joaocolombari/Gagabiro/components/res/PMFLR - PR02  - 100r - 2w - 1.JPG

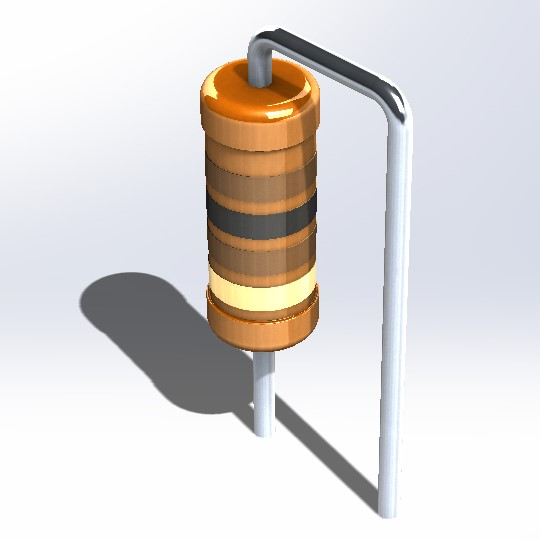
components/res/PMFLR - PR02 - 100r - 2w - 1.JPG
