joaocolombari/Gagabiro/components/El84/Renderings/untitled.250.jpg

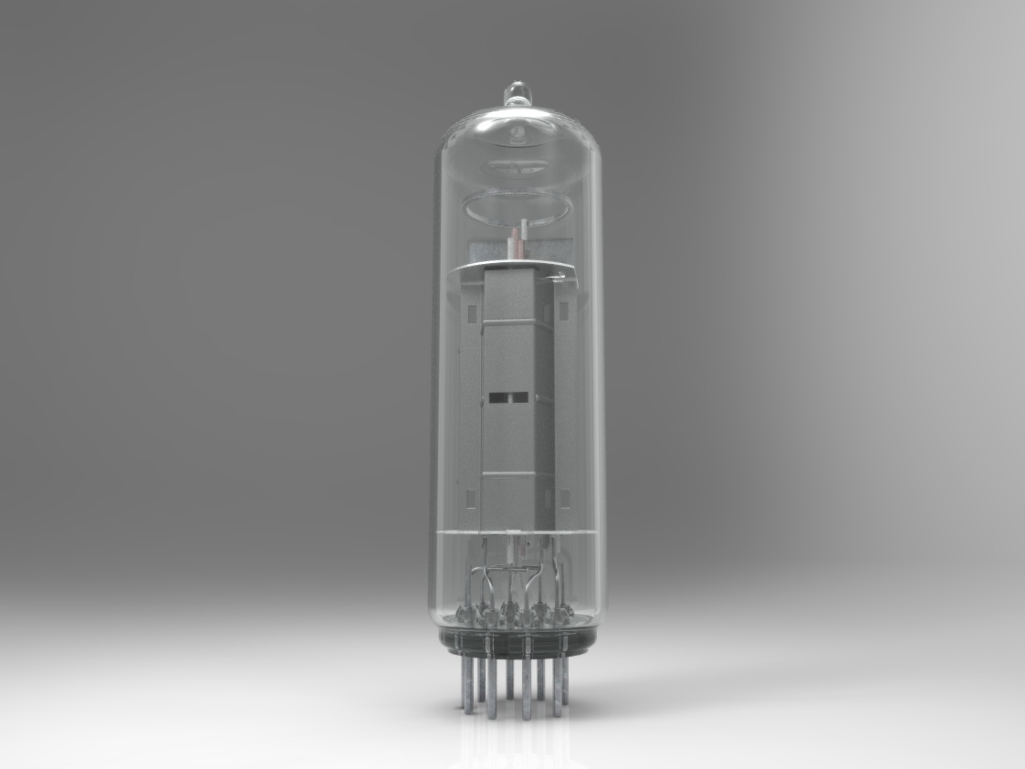
components/El84/Renderings/untitled.250.jpg
