joaocolombari/Gagabiro/schatz/How Good is an Audio Transformer - Crowhurst - 1952.pdf

# How Good is an Audio Transformer?

### N. H. CROWHURST

A thorough understanding of transformers is essential to the selection of the proper type for any particular application. The fundamentals are here presented by the author to intro-

duce the series on one of the most important components in high- quality audio equipment. THERE WAS A T1ME when audio trans-

formers were specified simply by
turns ratio. An interstage transformer would be designated, according to ratio, e.g., 3: 1 or 5: 1. But one com- ponent would give much better per- formance, although having the same turns ratio as another. The modern

transformer manufacturer knows that there is far more to designing a good transformer than just putting windings on a core so as to have the correct turns

ratio. Each design must in fact be suited for the particular job in hand. To help the prospective user, the component is generally specified by the circuit for which it is intended, e.g. "10,000 -ohm plate to single grid," together with some statement of frequency range. This is much more informative, but a still further and more detailed understanding of audio transformers will enable them to be used to best advantage in every ap- plication. Any audio transformer is essentially a matching device, but no transformer is a perfect matching device because it introduces its own losses and defects. It is the designer's job to see that these losses and defects are kept to suitable proportions. If he has done a good job, then the user can get the best perform- ance from the component by following

the manufacturer's recommendations as to circuit values. But it would not be

economic to design a different transformer to suit every possible application or circuit, so a standardized design often

has to cover a range of uses. A perfectly good transformer, connected into a circuit unsuited for it, will give poor re- sults, but correct understanding of the

problem can help rectify these deficiencies.

How Big Must it Bet
A popular fallacy has been that audio transformers always follow the principle "the bigger the better." Sometimes size is essential to quality, but for other applications the smaller component is the better one. All modern transformer core mate-

rials have a well defined saturation density. Magnetization above it will con- siderably distort the current waveform, and the distortion will reflect into the 82, Canterbury Grove, London, S.E. 27, England.

circuit. The saturation density will cor- respond to different voltage levels at dif-

ferent frequencies, so the handling ca- pacity of a transformer depends on the frequency considered. A winding that will accept 5 volts at 60 cps before distorting will accept 10 volts at 120 cps. Applying this fact to audio power transformers, a component rated to de-

liver 10 watts over a frequency range down to 60 cps will deliver considerably more power if the low- frequency cut -off

is raised to, say, 240 cps. Conversely, a smaller transformer may be used for the same power rating if a higher cut -off

is employed. In practice, the fact that only signals of low level are needed at the low -frequency end of the audio spectrum enables smaller transformers to be employed than would be possible if full output were required down to,

say, 60 cps.
Another factor that affects size is the presence or otherwise of d.c. polarizing. Where plate current passes through one winding (not in push -pull), the core be- comes polarized. To minimize this polar -, ization, a gap is left in the core by the

manufacturer, according to the intended current. Polarization reduces the allowable a.c. magnetization, but the gap in the core reduces the primary inductance unless the turns are increased. So to achieve suitable primary inductance and satisfactory a.c. magnetization limits, without excessive insertion loss, the presence of polarizing current requires more turns on a larger core size. For input transformers -line to grid, or microphone to grid -size is seldom an advantage, the best transformers

designed being of small size. For inter - stage transformers, where appreciable voltage swing is required, a slightly larger transformer may be necessary.

Fig. 1. Equivalent circuit of
C.= primary | Lp = capacitance | L. = Ca = secondary | r, = capacitance | ra = Cs = interwinding capacitance | Rv =

audio transforme .
lprimary

inductance eakage inductan e primary resistance secondary resistance core loss referred

to primary

For driver transformers, where power must be delivered to the grid circuit, considerably larger sizes are required.

Its Electrical Specification
The transformer's electrical properties have a direct bearing on its performance, but the user will not necessarily be bothered with them directly. His con- cern is with the performance of the finished article. The principal properties are shown for reference at Fig. 1, which will assist in understanding the behavior of the transformer under different con- ditions, and what part each contributes. This is one way of representing the equivalent circuit of any audio transformer. For convenience, the fact that the transformer provides a step -up or step -down is not shown in the diagram. This action of the transformer may be

regarded as perfect, its imperfections being presented in the circuit values of Fig. 1. The legend under the diagram explains what each symbol represents. There are four elements shown as shunting the transmitted signal -pri-

mary and secondary winding capacitance, primary inductance, and core loss referred to the primary. There are four elements shown as in series with signal transmission-pri - mary and secondary winding resistance. RI

R

la) | IB) Fig. 2. Equivalent circuit for low- frequency cut-

off, in a direct - coupled a.f. transformer. (A) Complete arrangement: R, = primary source

impedance; R, = secondary load impedance.
I B) Simplified equivalent of IA) : R. parallel combination of R,, R,, and Ra. leakage inductance, and interwinding capacitance.

All these circuit elements must be referred to one winding when considering their effect. If the primary is the chosen reference winding, then elements actually due to the secondary winding or its associated circuit must be "referred" in value by a factor of the turns ratio squared. Suppose the ratio is 3 : 1 step -up, then secondary winding resist- ance is divided by 9 and its capacitance

20 | AUDIO ENGINEERING | MARCH, 1952

multiplied by 9 in referring to the primary. Usually the "referred" winding resistances of both windings are of the same order, but the referred winding capacitance of the high winding is much larger than that of the low one (about 9 times for 3: 1 ratio). Hence the effect of the low- winding capacitance can often be ignored, only that of the high one being taken into account.

Insertion Loss At a middle frequency, the shunt re- actances will be high enough to exercise

negligible effect, while the series reac- tance of L. will be low enough to ignore, so the transformer is virtually a "T" re- sistor network, the attenuation of which can be calculated with reference to ex- ternal circuit values -also usually re- sistances only -at mid- frequency. This

attenuation, essentially a measure of power loss, is known as the insertion loss of the transformer.
For input and interstage transformers, where voltage transfer is the important feature, insertion loss is not generally given serious consideration. But for driver and output transformers, where insertion loss means valuable watts are lost, it must be considered. Insertion loss may be expressed in db, when the fractional power ratio corresponding to the db figure gives the proportion of input power reaching the output, or it may be expressed directly as a percentage. For example an insertion loss of 1 db represents an efficiency of approximately 80 per cent.
For a given transformer size, cor- rectly designed, the ratio of r, and r, to

Rp is fixed by the geometry of the com- ponent. Variation of turns and wire

Fig. 4 (left). Equivalent circuit for low -fre- quency cut -off in a parallel -fed a.f. transformer: = coupling capacitor. F g. 5 (right). Re- arrangement of Fig. 4 to show it as a resorant circuit.

gauge to suit, varies winding resistance and referred core -loss shunt in the same proportion. Thus a winding with too few turns results in low core -loss shunt, while too many turns produces excessive winding resistance. Conversely, from the user's viewpoint, connecting a transformer to circuits of lower impedance than design values introduces high series loss due to winding resistance, while connection to higher impedances results in serious shunt losses due to core magnetization.
In generally, a variation of impedance results in a deficiency in frequency re- sponse as well, and the choice of the

number of turns in design must be a compromise to achieve good response to

both low and high ends of the spectrum. At low frequencies, the effect of La, C., C., and C. is negligible, but that of

AUDIO ENGINEERING | MARCH,
Fig. 3. Low- frequency cut -off | attenuation

characteristic, 6 db per octave.

01 | 0.2 030.4 0608 | 2 | 3 | 4567810 RELATIVE FREOUE/KY - /,c

inductance Ln will become appreciable. For the purpose of comparative re- sponse, the values of winding resist- ances r, and r. can generally be ignored as small compared to the circuit resist- ances R. and R. to which the trans-

former is connected. Thus the circuit can be redrawn as at Fig. 2 from the viewpoint of relative l.f. response. At
(A) the relevant values are shown, R, being the source impedance -i.e., the plate resistance of the tube if the transformer is connected in a plate circuit ;

Fig. 6 (left). Equivalent circuit for high -frequency cut -off in a step -up transformer, and Fig. 7 (right), in a step -down transformer.

R. is the secondary load resistance, if any, referred by turns ratio squared to the primary side. For example, a shunt resistor of 1 megohm on the secondary of a 5: 1 step -up will give a referred R. of 1 megohm divided by 5' or 25, which is 40.000 ohms.
The shunting effect of Lp must be considered relative to the parallel re- sultant of R., R. and Rp. Thus (B) in Fig. 2 shows a simplified theoretical form of the circuit, where R is the re- sistance of R,, R. and Rp in parallel. This circuit produces a simple 6 db/ octave l.f. cut -off, of the type shown at Fig. 3, in which the 3 -db point is the frequency where the reactance of Lp is equal to R. Thus the cut-off frequency can be modified by changing either Lo or R. As Lp and Rp are fixed by the

transformer, the remaining possibilities for adjusting l.f. cut -off are R, and R.. Reduction of the effective parallel re- sistance of these two will lower the I.f.

cut -off, extending the frequency range. With a direct -coupled transformer, where the core is polarized, the core is gapped so that the highest possible inductance is achieved when the current for which it is designed passes through the winding. It is wasteful to work the

1952

transformer at a current differing appreciably from this value.
A direct -coupled transformer operating in a push -pull plate circuit does not have its core polarized, so a smaller component can be used, and the circuit of Fig. 2 can be applied, taking care that all impedances are referred to either the whole, or half, of the primary winding, correctly. However, the inductance varies widely with both frequency and level, so the response shown at Fig. 3. will not be applicable, but the same prin-

ciple for adjusting 11 cut -off applies. Distortion is closely associated with l.f. response because it appears most strongly at this end. Steps that improve I.f. response also reduce distortion due to harmonics in the magnetizing current. Sometimes transformers are parallel fed, to avoid passing the plate current through the primary winding. Since a coupling capacitor is then necessary, its. reactance also becomes effective at low frequencies, so the circuit for l.f. re- sponse takes the form shown at Fig. 4.

Here R. is the effective resistance given, by the plate resistance of the tube and its coupling resistor in parallel ; R., as before, is the secondary load resistance,. if any, referred to the primary. This . circuit is in the form of a resonant cir-

cuit, seen more clearly as redrawn at Fig. 5, where R. is in series with the resonant components Cc and L,, and the resistances Rp and R. are in shunt. For this reason, larger values of R. or smaller values of R. increase the damping (or reduce the Q) of the resonant circuit.
Less -than -critical damping results im a l.f. peak in the vicinity of cut -off. Critical, or more -than -critical, damping, eliminates any tendency to peak. Choice' of suitable values for R,, R., and Cc can result in best possible operation of the transformer in a circuit. as will heshown in detail in following articles.

Response at High Frequencies
At high frequencies the effect of Lp,. and Cc if used, will be negligible, and where any appreciable transformation ratio is employed, one of the winding capacitances may usually be neglected. Thus Fig. 6 shows the h.f. circuit equivalent for a step -up transformer. while [Continued on page 5.51' 2T

TABLE II

Preferred change in level db From speech to speech

From music to speech
From speech to loud - starting music
From speech to quiet - starting music
From speech to interval
signal ( Bow Bells)

## - -4to-í

+2
+2to+3
-19

Voltage Regulator Tubes
An article un the use of neon voltage regulator tubes by C. Tuppin appears in the September 1950 Toute la Radio. Techniques for the stabilization of both d.c. and a.c. voltages are discussed, and trigger

tubes are mentioned briefly. Of importance is the table of regulator tubes available in France. Some of these tubes are capable of stabilizing voltages as high as 340 volts while others have current ranges up to 200 ma. Most of these tubes are not mar- keted in this country, although they would

appear to be quite useful in many applications where designers are now forced to use series or parallel connection of avail-

able tubes.

### HOW GOOD IS AN

## AUDIO TRANSFORMER?

from page 211
Fig. 7 shows that for a step -down type. As in the previous section. it is assumed that winding resistances are negligible 'in comparison with the circuit impedances.
A complicating factor is the interwinding capacitance Cs. so it is usual to take steps to eliminate its effect. Some transformers incorporate shields between windings, connected to ground, so that interwinding capacitance is replaced by winding -to- shield, i.e. to ground, capaci-

tance. effectively increasing existing winding capacitance slightly. Where shields are not employed, it is

RUGGED
CONS'i RUC (ION
EXCEPTIONAL
CALIBRATION
STABILITY
UNAFFECTED BY VARIATIONS
IN HUMIDITY

# MIDGET

# CONDENSER

# MICROPHONE

## for Precision Sound

## Measurements and High Quality Sound 'Recording

Built to give years of service without change in calibration. Even without dessicators, Kellogg Midget Condenser Microphones show no detectable drift in laboratory service. Proven in use for
optimum performance for more than 15 years. MODEL A | MODEL 8 RESPONSE JReferred to
1 volt, dyne, cmr) | -59 db | -55 db
FLAT TO WITHIN ± 3db from 20 to 11,000 cps, for closed cavity without grille. | ± A db from 20 to 15,000 cps with or without grille for perpen- dicular incidence in free field. Users 1r:dude government laboratories.

universities. audio development labora-

tories. sound studios and industrial plants manufacturing sound equipment. | SEND FOR FULL SPECIFICATIOtic TODAY! WRITE DEPT 27 -C ELLDSWITCHBOARD AND | COMPANY
-, a "7 | MIDGET CONDENSER MICROPHONE 6650 South Cicero Avenu e, Chicago 38, I Ilinois

Fig. 8 !left). Elimination of C. from Fig. 6, and Fig. 9(right) from Fig. 7. generally possible to connect the trans-

former so as to practically eliminate the effect of interwinding capacitance. Inter - winding capacitance is the capacitance

between the layers of turns that are nearest together in the two windings. These layers will be turns electrically close to one end of their respective windings. By connecting the windings into the external circuit so that the signal potential to ground from one of these ends is zero, the interwinding capacitance will become virtually the capacitance from the other winding to ground. If the ends nearest together in both

HIGH -FIDELITY k a quarterly magazine, devoted to the

interests of people who enjoy the best in home musical entertainment. It is a large- size magazine, beautifully

illustrated, and handsomely
printed on Fne paper. Published by MILTON B. SLEEPER

# Before you spend money

# for RECORDS, consult

# Uig h ; Jidcliiq

## the Big Magazine of Information about

Records and Hi -Fi Equipment for Your Home

BEFORE YOU BUY NEW RECORDS: Make it a habit to check the reviews in HIGH -FIDELITY by such outstanding critics os John Conly, Alfred Frankenstein, C. G. Burke, and John Indcox. If a new release is worth buying, you'll fund it listed. Also, you'll find

it compared with other recordings of the some composition. Thus HIGH -FIDELITY con help you to avoid mistakes, and to choose the best recording of any composition you want. Playing time and price of each record is shown. SPECIAL FEATURE: The Spring Issue contains C. G. Burke's monumental research work which reviews every LP ever made of Beethoven's music. In book form, it would occupy 120 pages.

BEFORE YOU BUY HI-FI EQUIPMENT: Make it a habit to consult the elaborately -illustrated articles in HIGH -FIDELITY on record players, styli, tape recorders, FM and TV tuners, amplifiers,

speakers, and modern decorative ideas for home installations, all described in non -technical language.
Mail Coupon Today! Big Spring issue now ready for mailing. e Mr. Charles Fowler, Editor, High Fidelity Magazine

I 26 Audio Building, Great Barrington, Mass. Please enter my subscription to High Fidelity Magazine:

36.00 for three years (SAVE $61 053.00 for one year (SAVE 511 Name Address Add 50{ per year for Canada, $1.00 foreign countries AUDIO ENGINEERING | MARCH, 1952 | 55

windings have zero signal potential to ground, the effect of interwinding ca- pacitance is completely eliminated, not even adding to effective winding ca- pacitance, because there is no signal

potential across it. (Any d.c. potential between windings will not produce ca- pacitance currents.) When the effect of interwinding ca- pacitance has been eliminated, the circuits of Figs. 6 and 7 become those shown at Figs. 8 and 9 respectively. Now, as in the 1.f. case, each circuit be- comes a simple resonant circuit, in which the impedance connected to the low side of the transformer is series damping, while that connected to the high side is shunt damping. Figure 10 shows the h.f. response due to (a) less - than- critical damping, (b) critical damp-

ing, (c) more -than -critical damping. Common cases where inadequate damping gives rise to a h.f. peak are interstage transformers operated in the

plate circuit of triodes, and output transformers for tetrode or pentode tubes. Careful attention to the circuit can eliminate an undesirable peak or loss and produce the best possible response.

# FIFTH PRINTING

## Just off the press

# AND STILL GOING STRONG!

# audio

# anthology

Paper cover . | $2.00

Distributors write for quantity discount

The long awaited compilation of reprints from early issues of AUDIO ENGINEERING, most of which are unobtainable.

Contains 37 articles on the following subjects:
Amplifiers | Phonograph Equipment
Speakers | Tone and Loudness Controls
Noise Suppressors | Dividing Networks
These articles have been of great interest to readers of AUDIO ENGINEER-ING over the past three years. Assembled in one volume, they comprise the most authoritative reference work for the audio hobbyist.
I- | -CUT OUT -MAIL TODAY-
Book Division, Dept. A9
Radio Magazines, Inc.
342 Madison Ave., New York 17, N. Y. Sins: Enclosed is my | check | money order for | copies of the
Audio Anthology. Name (print carefully) Address City | Zone | State | J

The internal properties of an audio transformer that set a limit to its frequency range at the upper end are its leakage inductance and the winding ca- pacitance of the high side (including

additional capacitance connected across the winding externally, such as grid input and strays). The ultimate cut -off frequency is inversely proportional to the square root of the product of this inductance and capacitance. Both these quantities increase with the size of the transformer so it is clear that smaller transformers have an inherently higher frequency range.

o g

10

03 | 05 | 2

i10

20 03 0.5

z o i 10

20 | 05 | 2 | 3

Fig. 10. Attenuation responses for high -fre- quency cut -off; (A) less- than -critical damp-

ing; (B) critical damping; and (C) more -thancritical damping.
Successful operation of any transformer depends appreciably upon the circuit in which it is worked, and the manufacturer's specification does not wholly determine how good any particular transformer is for the job in hand. Simple methods of measuring up the qualities of a transformer and of determining circuit modifications for opti- mum performance will be discussed in

subsequent articles.

56 | AUDIO ENGINEERING | MARCH, 1952
