joaocolombari/Gagabiro/Gagabiro/Project Outputs for Gagabiro/png_layers/1.png

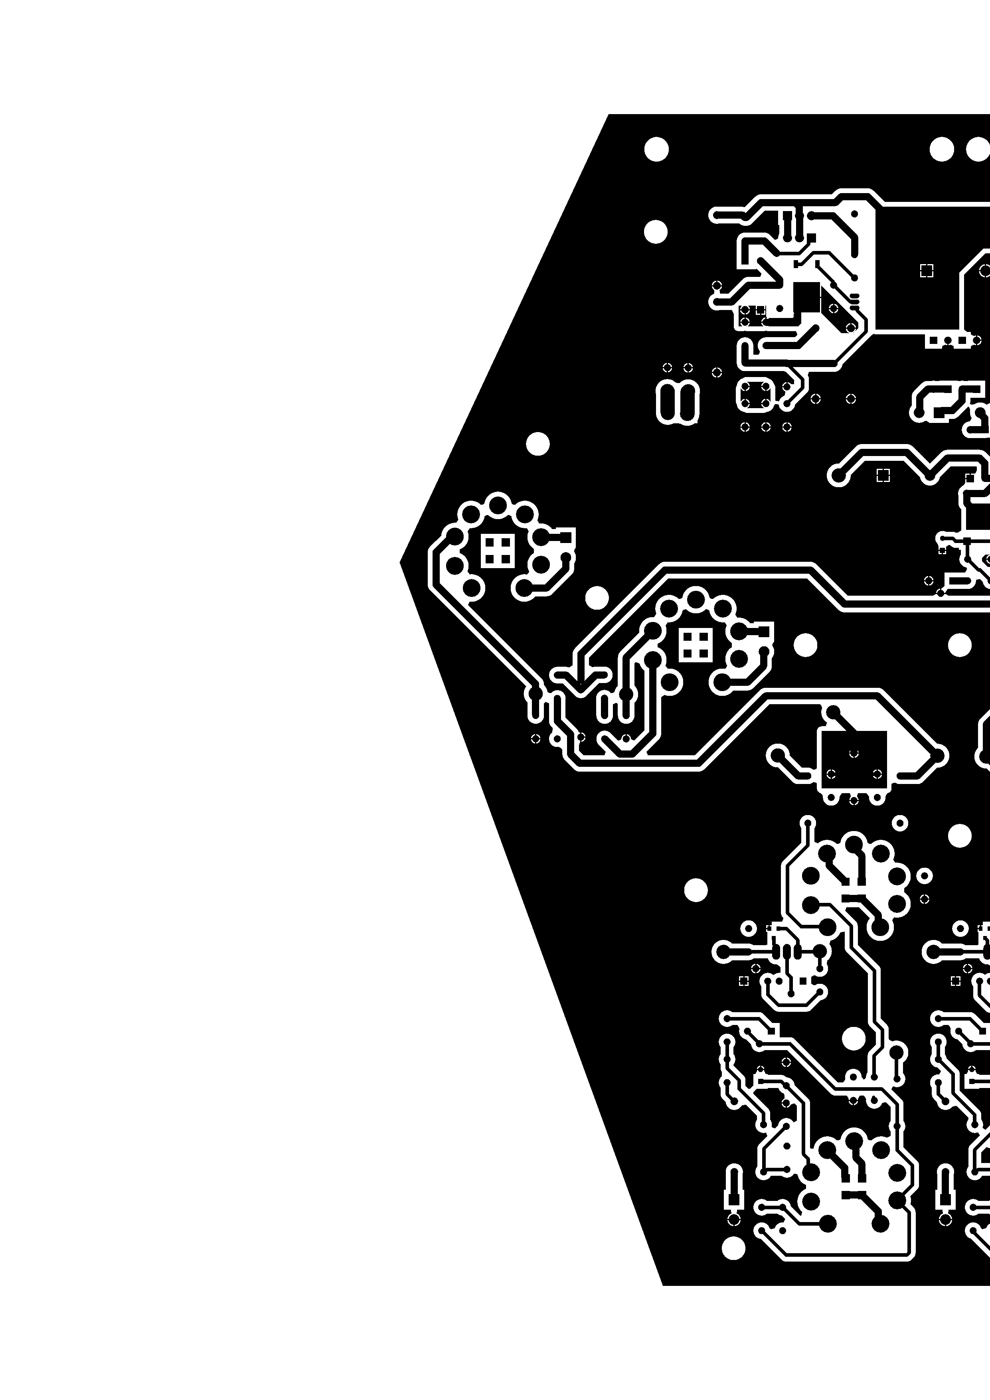
Gagabiro/Project Outputs for Gagabiro/png_layers/1.png
