joaocolombari/Gagabiro/Gagabiro/Project Outputs for Gagabiro/png_layers/2.png

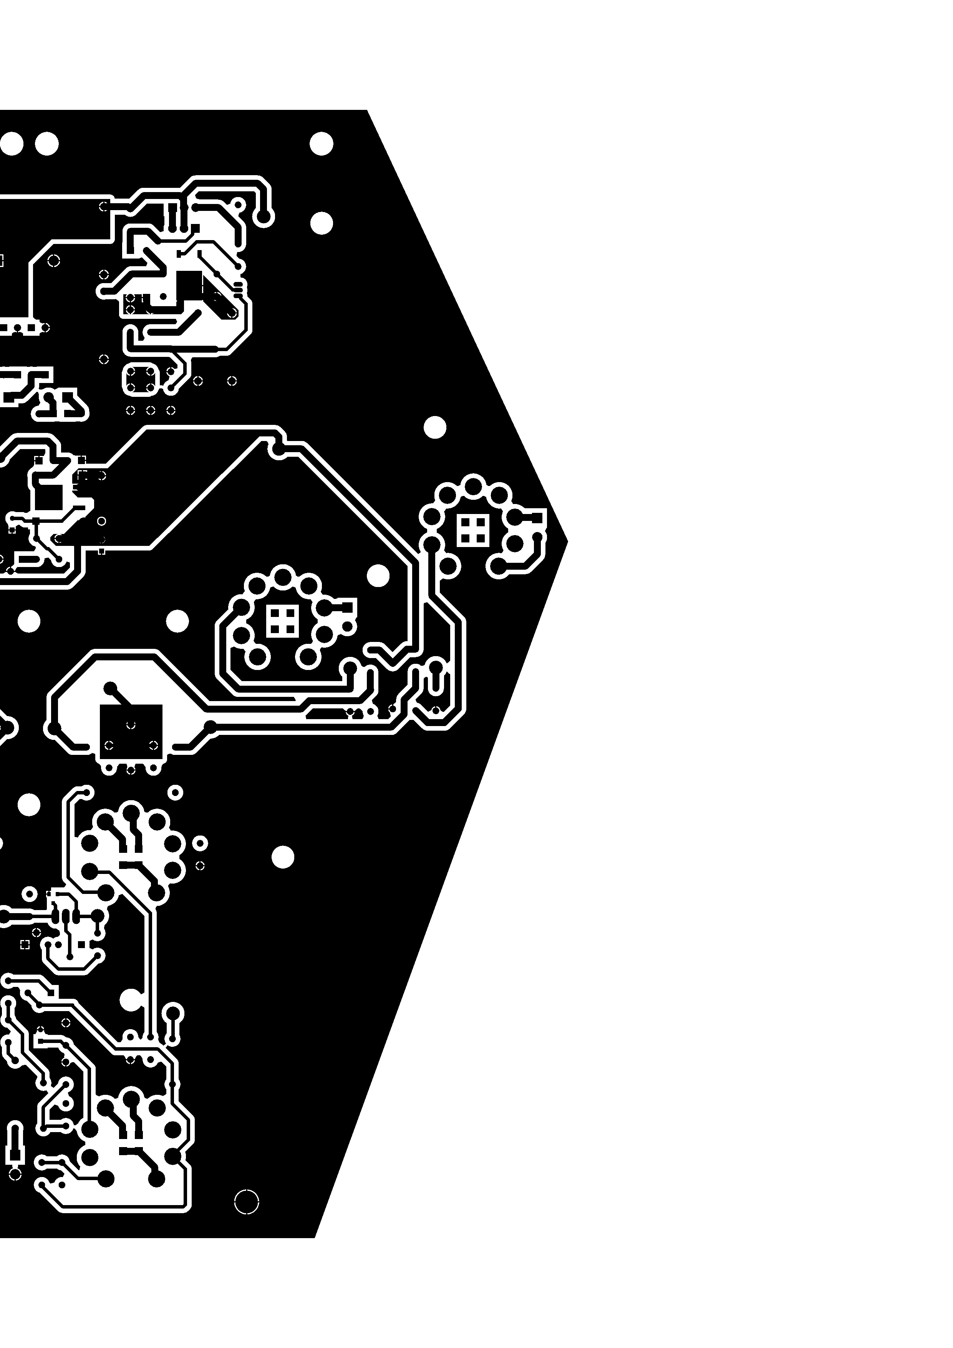
Gagabiro/Project Outputs for Gagabiro/png_layers/2.png
