joaocolombari/Gagabiro/Gagabiro/Project Outputs for Gagabiro/png_layers/3.png

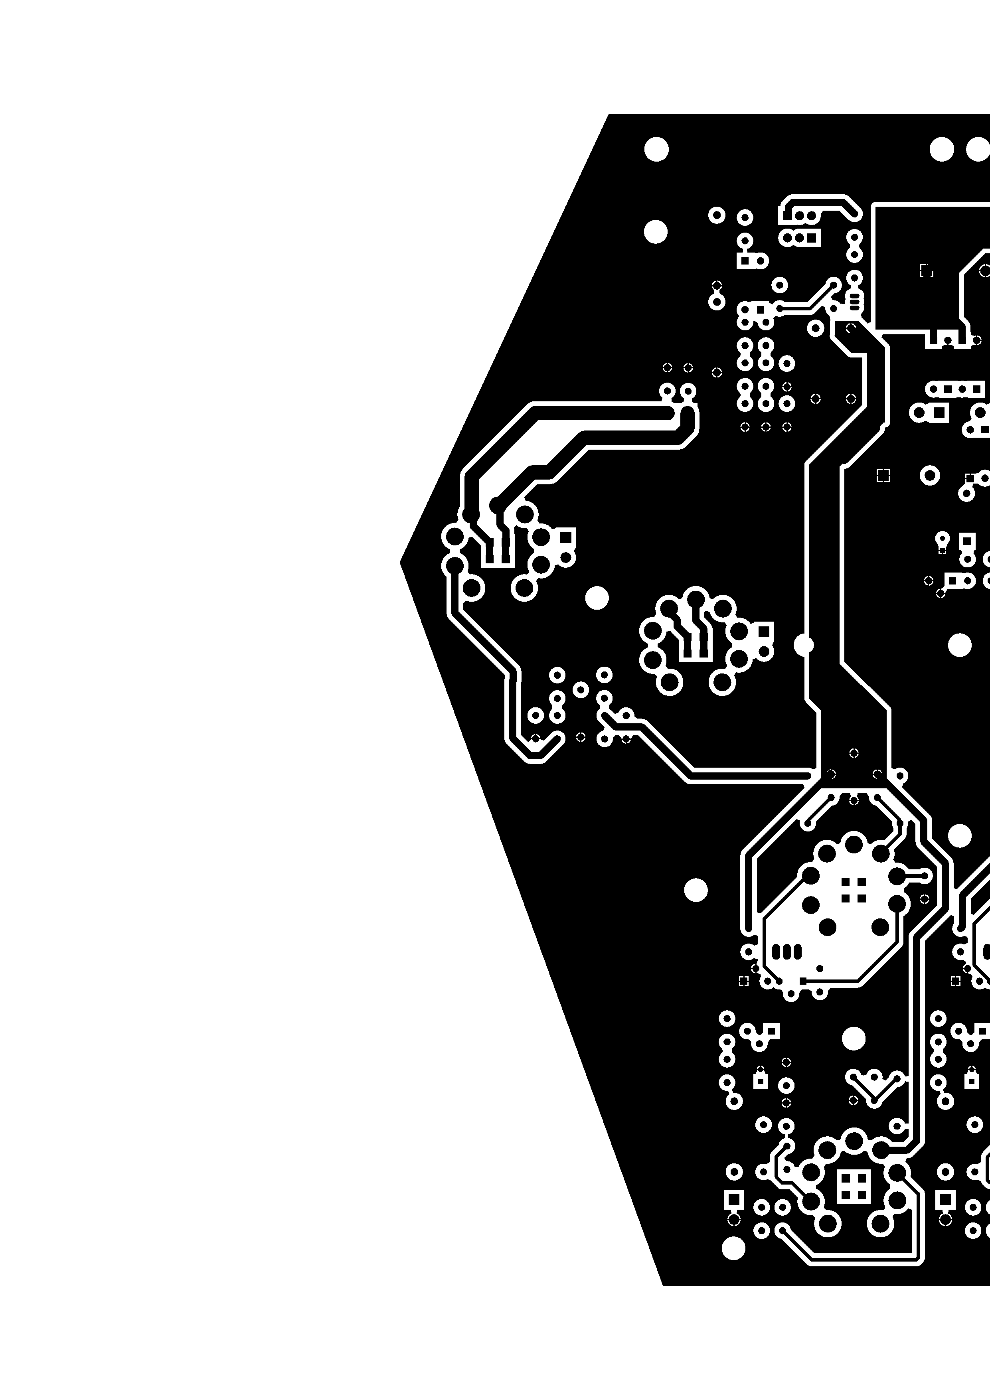
Gagabiro/Project Outputs for Gagabiro/png_layers/3.png
