joaocolombari/Gagabiro/templates/USP-removebg-preview.png

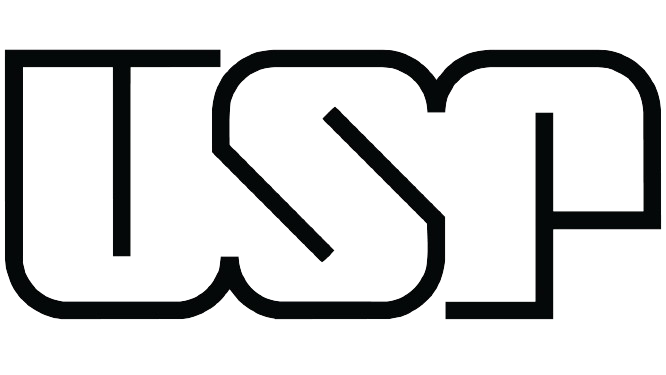
templates/USP-removebg-preview.png
