joaocolombari/Gagabiro/components/12ax7/2/base sem blindagem.fw.png

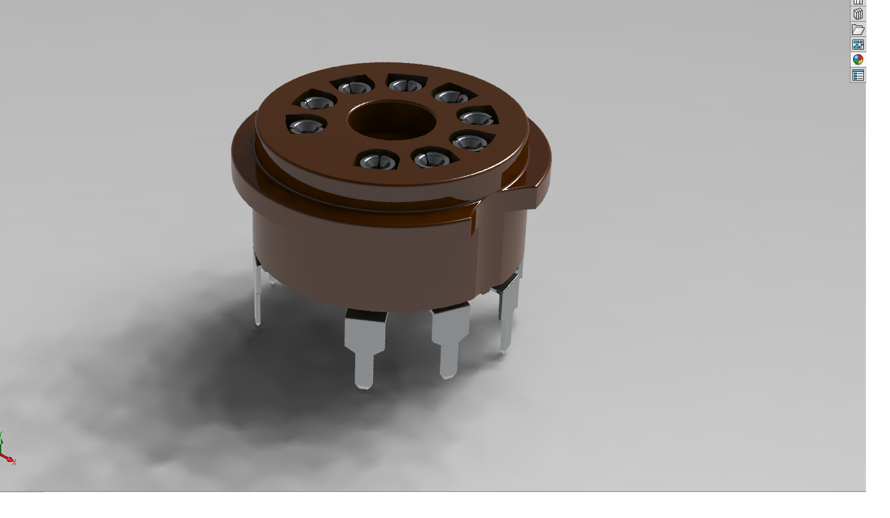
components/12ax7/2/base sem blindagem.fw.png
