joaocolombari/Gagabiro/components/12ax7/2/render base.fw.png

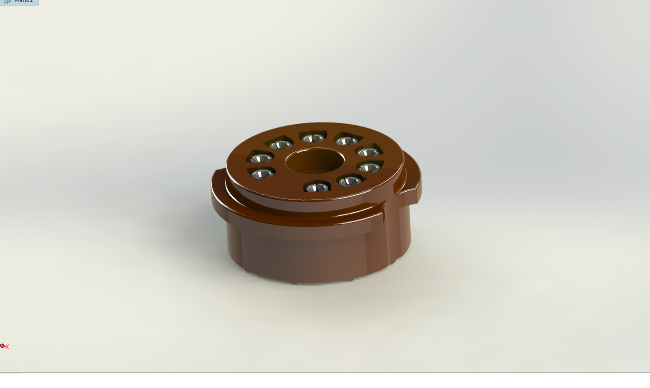
components/12ax7/2/render base.fw.png
