joaocolombari/Gagabiro/components/12ax7/2/render end.fw.png

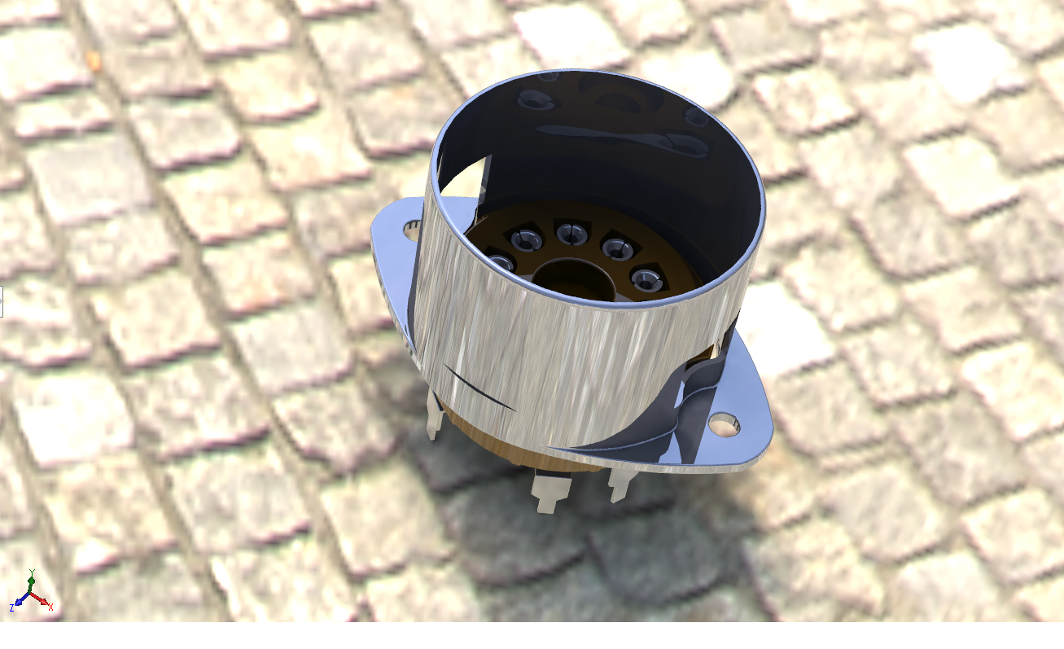
components/12ax7/2/render end.fw.png
