joaocolombari/Gagabiro/components/12ax7/Tube Socket - PCB v2.png

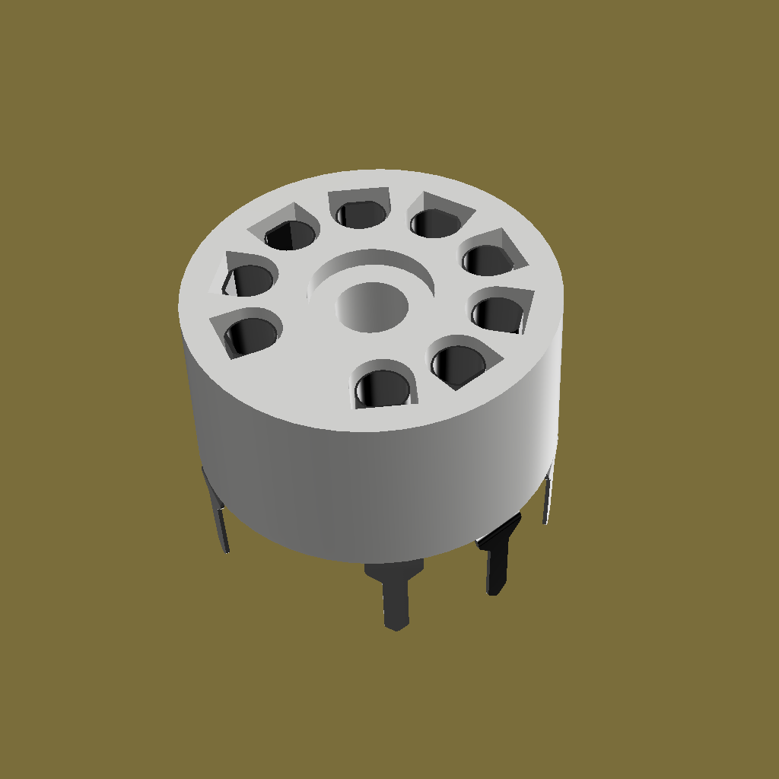
components/12ax7/Tube Socket - PCB v2.png
