joaocolombari/Gagabiro/components/El84/Renderings/el84.jpg

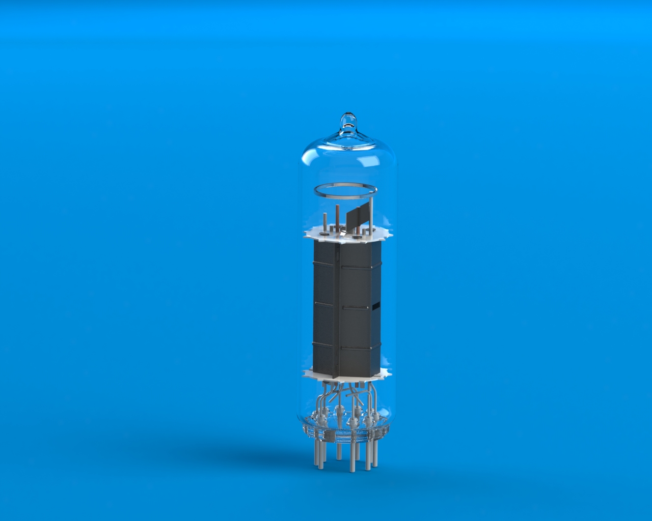
components/El84/Renderings/el84.jpg
