joaocolombari/Gagabiro/components/octal/octal.jpg

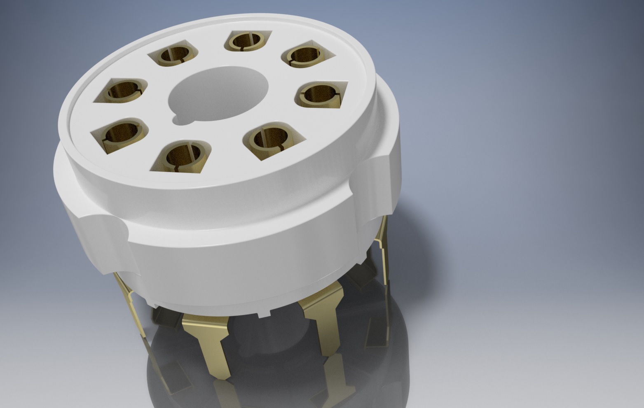
components/octal/octal.jpg
