joaocolombari/Gagabiro/components/octal/octal/Octal Base tube socket.png

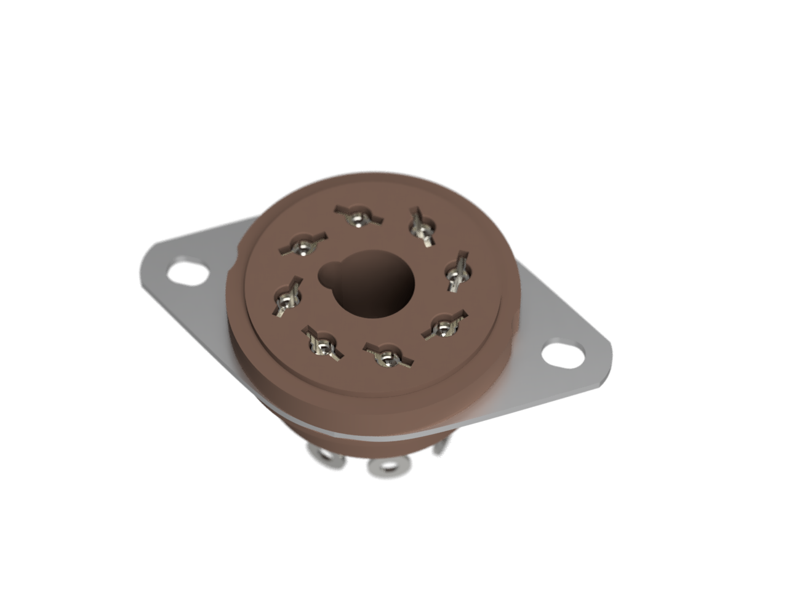
components/octal/octal/Octal Base tube socket.png
