joaocolombari/Gagabiro/components/octal/octal/Octal Tube Socket/Bottom.png

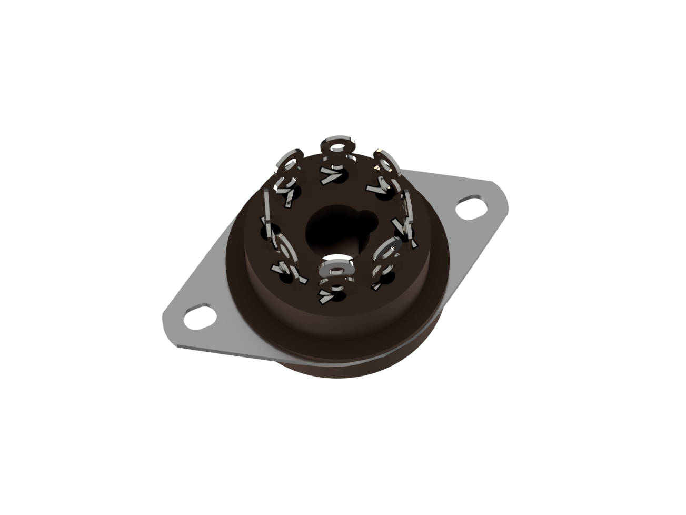
components/octal/octal/Octal Tube Socket/Bottom.png
