joaocolombari/Gagabiro/components/octal/octal/Octal Tube Socket/Front.png

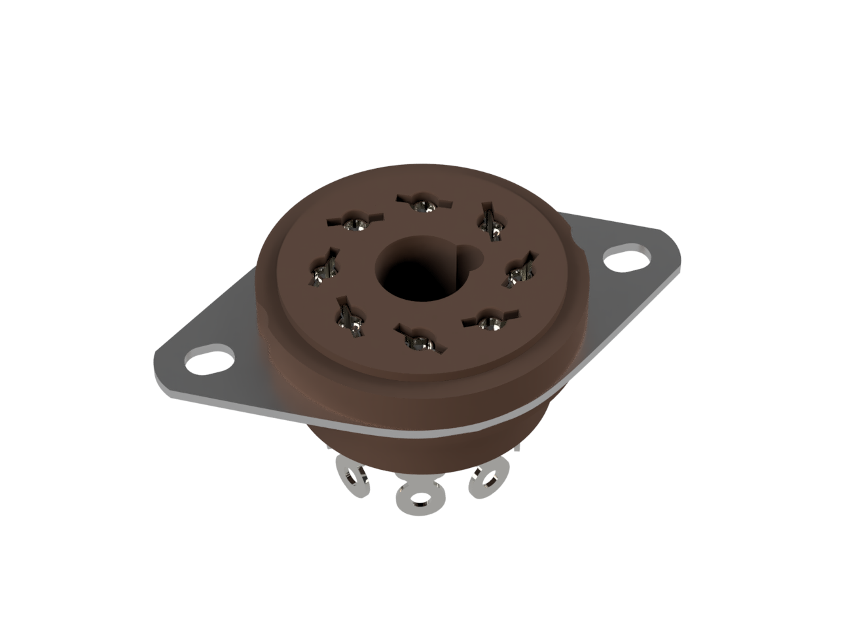
components/octal/octal/Octal Tube Socket/Front.png
