joaocolombari/Gagabiro/components/octal/octal/Octal Tube Socket/pin.png

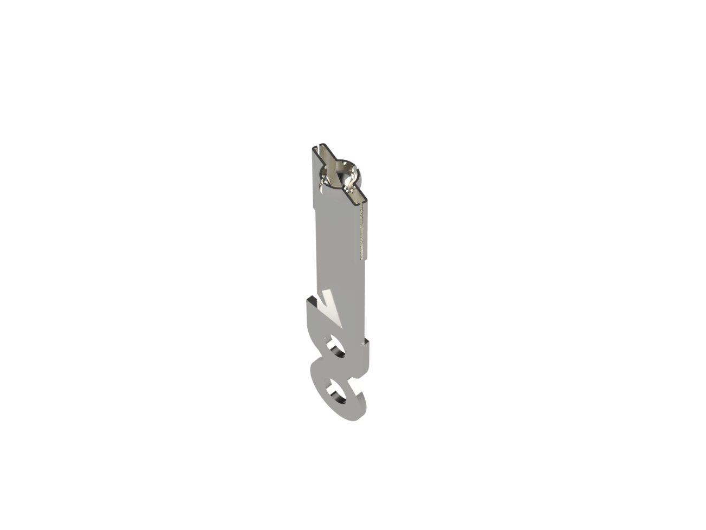
components/octal/octal/Octal Tube Socket/pin.png
