joaocolombari/Gagabiro/components/octal/Renderings/octal socket.jpg

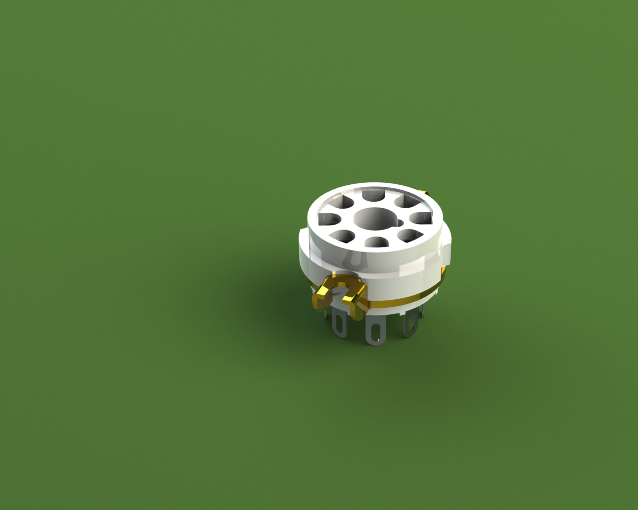
components/octal/Renderings/octal socket.jpg
