joaocolombari/Gagabiro/components/octal/octal assembly.SLDASM

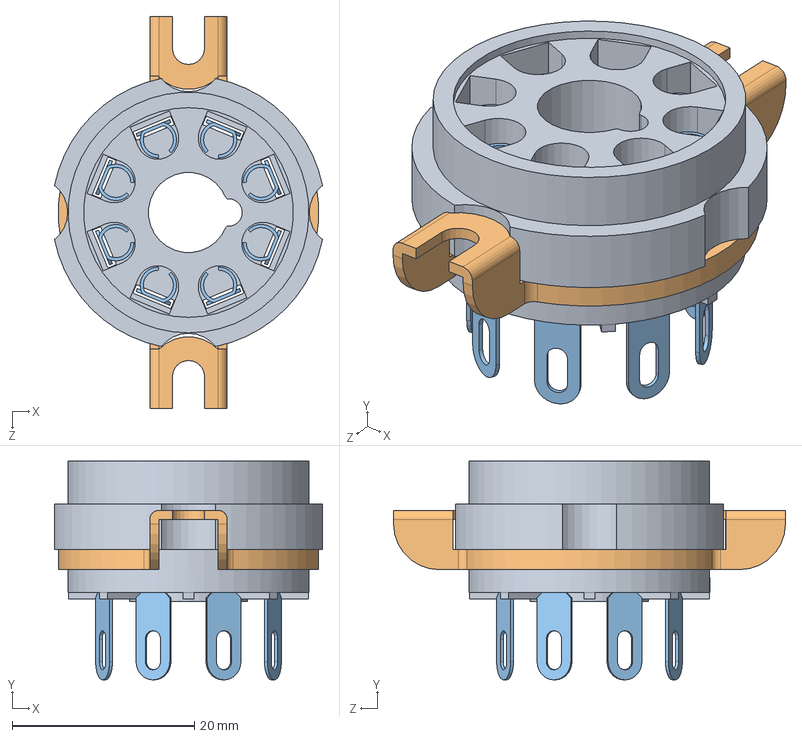
[picture p26: CAD file, 2025-02-04]
components/octal/octal assembly.SLDASM
29.4 x 24.0 x 43.0 mm
octal ceramic
octal clamp
octal tag x 8
