joaocolombari/Gagabiro/components/12ax7/2/montagem sem blindagem.SLDASM

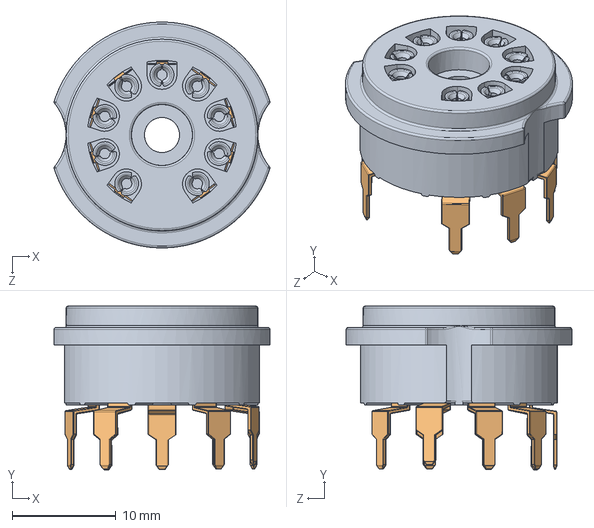
[picture p27: CAD file, 2025-02-04]
components/12ax7/2/montagem sem blindagem.SLDASM
20.8 x 15.8 x 21.8 mm
Base plastica
terminal x 9
