joaocolombari/Gagabiro/components/12ax7/2/blindagem.SLDPRT

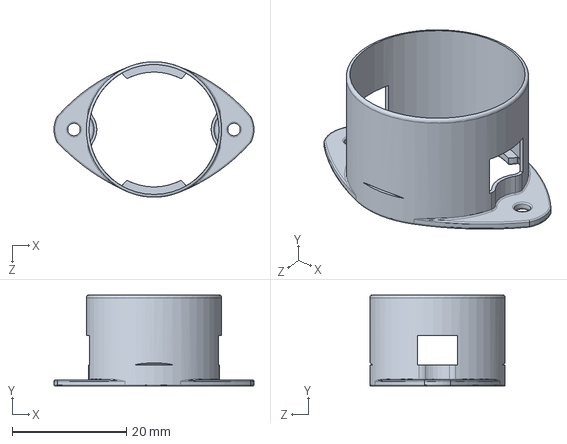
[picture p28: CAD file, 2025-02-04]
components/12ax7/2/blindagem.SLDPRT
35.0 x 15.9 x 23.7 mm
