joaocolombari/Gagabiro/components/12ax7/Tube Socket - PCB v2.step

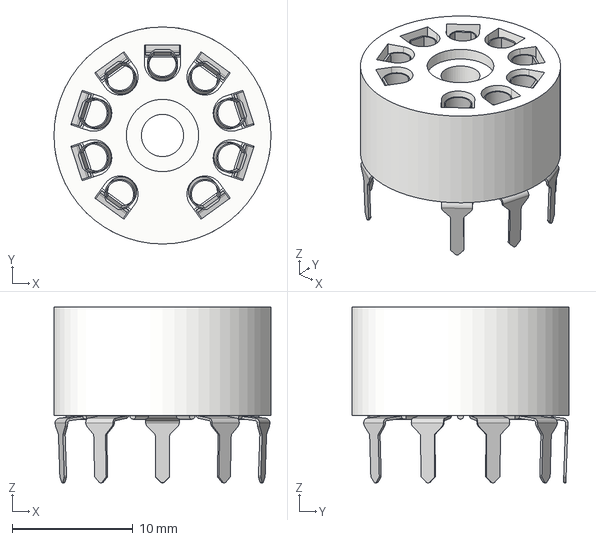
[picture p29: CAD file, 2025-02-04]
components/12ax7/Tube Socket - PCB v2.step
18.0 x 18.0 x 14.6 mm
