joaocolombari/Gagabiro/components/12ax7/valvula 12ax7/base-vidro-corpo.SLDPRT

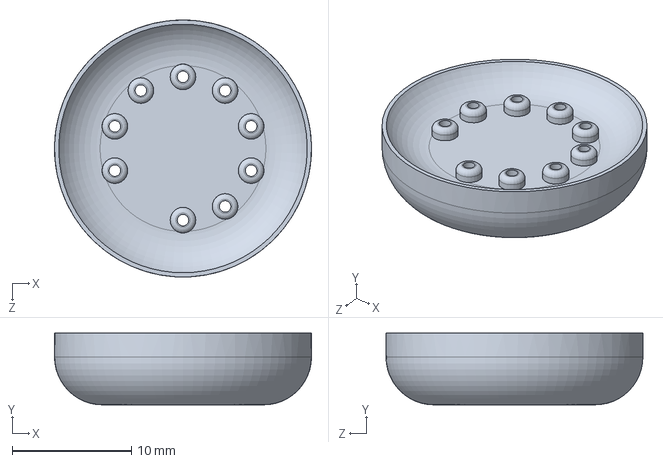
[picture p30: CAD file, 2025-02-04]
components/12ax7/valvula 12ax7/base-vidro-corpo.SLDPRT
21.5 x 6.00 x 21.5 mm
