joaocolombari/Gagabiro/components/AltiumDesigner/KTT3_6P22X6P6.step

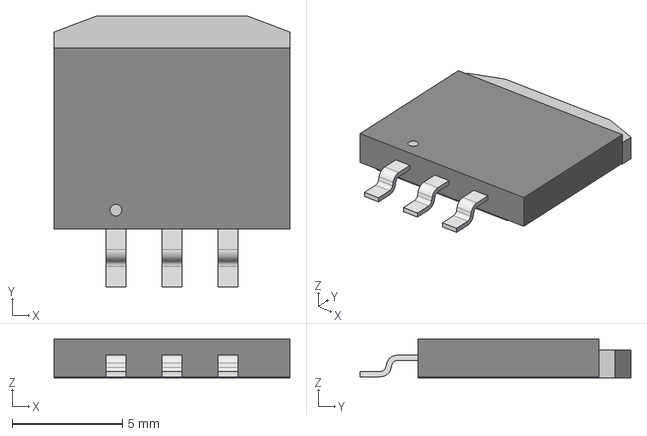
[picture p31: CAD file, 2025-02-04]
components/AltiumDesigner/KTT3_6P22X6P6.step
10.7 x 12.3 x 1.75 mm
