joaocolombari/Gagabiro/components/capacitor/mica-cap.STEP

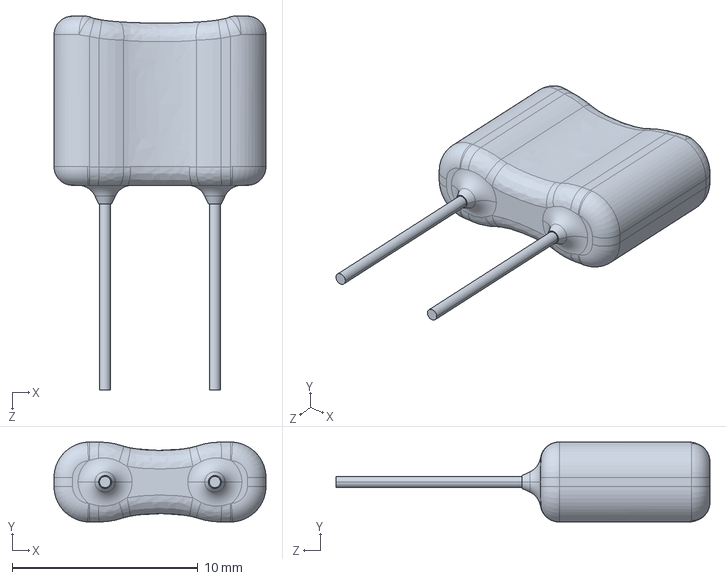
[picture p32: CAD file, 2025-02-04]
components/capacitor/mica-cap.STEP
11.4 x 4.30 x 20.1 mm
