joaocolombari/Gagabiro/components/capacitor/stp/ECW-FD2J-474-KB.stp

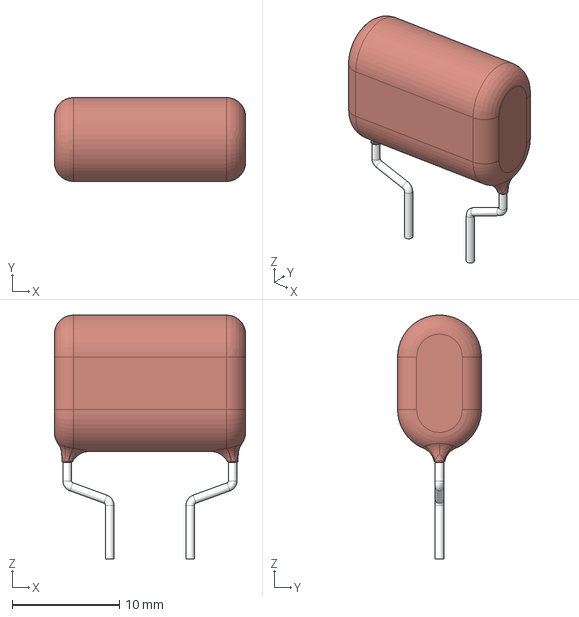
[picture p33: CAD file, 2025-02-04]
components/capacitor/stp/ECW-FD2J-474-KB.stp
17.8 x 7.80 x 22.7 mm
