joaocolombari/Gagabiro/components/eletrolitico/CAPACITOR BLACK-WHITE/0.22uF/0.22uF 50V electr 5 x11mm -P.diameter 2.5 mm-Black-White.stp

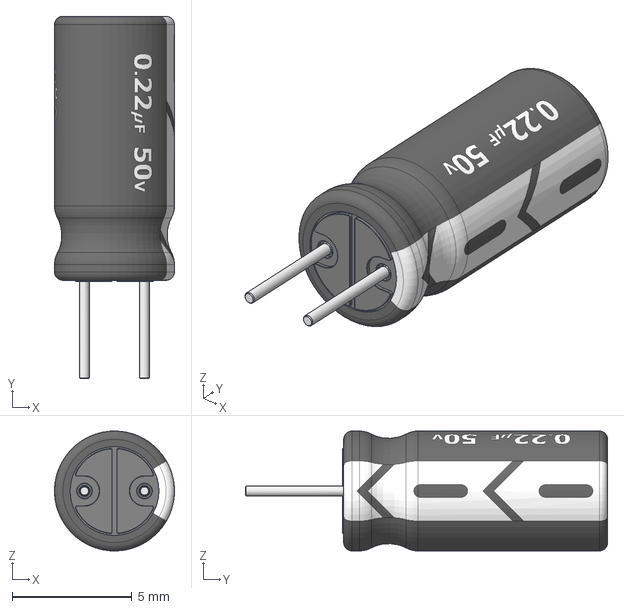
[picture p34: CAD file, 2025-02-04]
components/eletrolitico/CAPACITOR BLACK-WHITE/0.22uF/0.22uF 50V electr 5 x11mm -P.diameter 2.5 mm-Black-White.stp
5.00 x 15.1 x 4.99 mm
