joaocolombari/Gagabiro/components/eletrolitico/CAPACITOR BLACK-WHITE/1000uF/1000uF 100V electr 22 x36mm -P.diameter 11mm-Black-White.stp

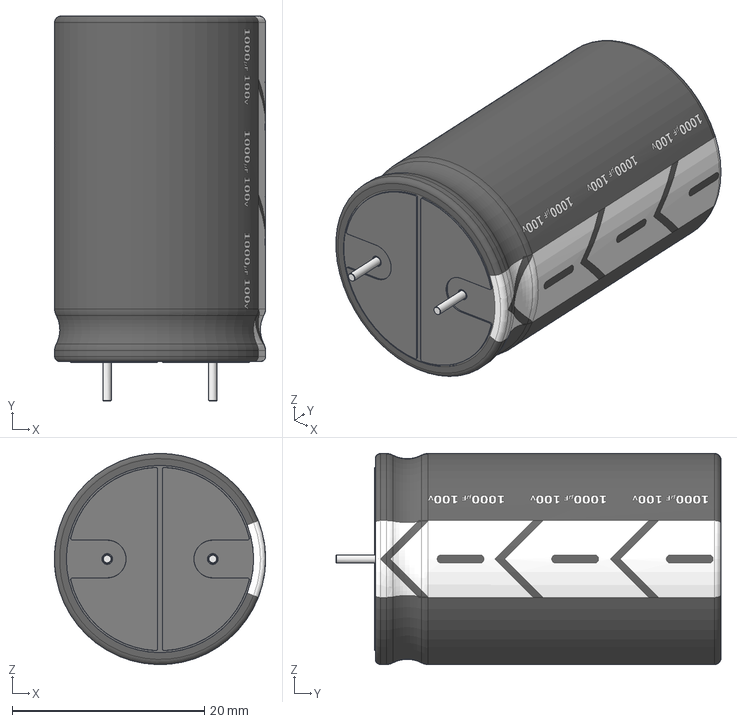
[picture p35: CAD file, 2025-02-04]
components/eletrolitico/CAPACITOR BLACK-WHITE/1000uF/1000uF 100V electr 22 x36mm -P.diameter 11mm-Black-White.stp
22.0 x 40.1 x 22.0 mm
