joaocolombari/Gagabiro/components/eletrolitico/CAPACITOR BLACK-WHITE/100uF/100uF 63V electr 8 x16mm -P.diameter 4mm-Black-White.stp

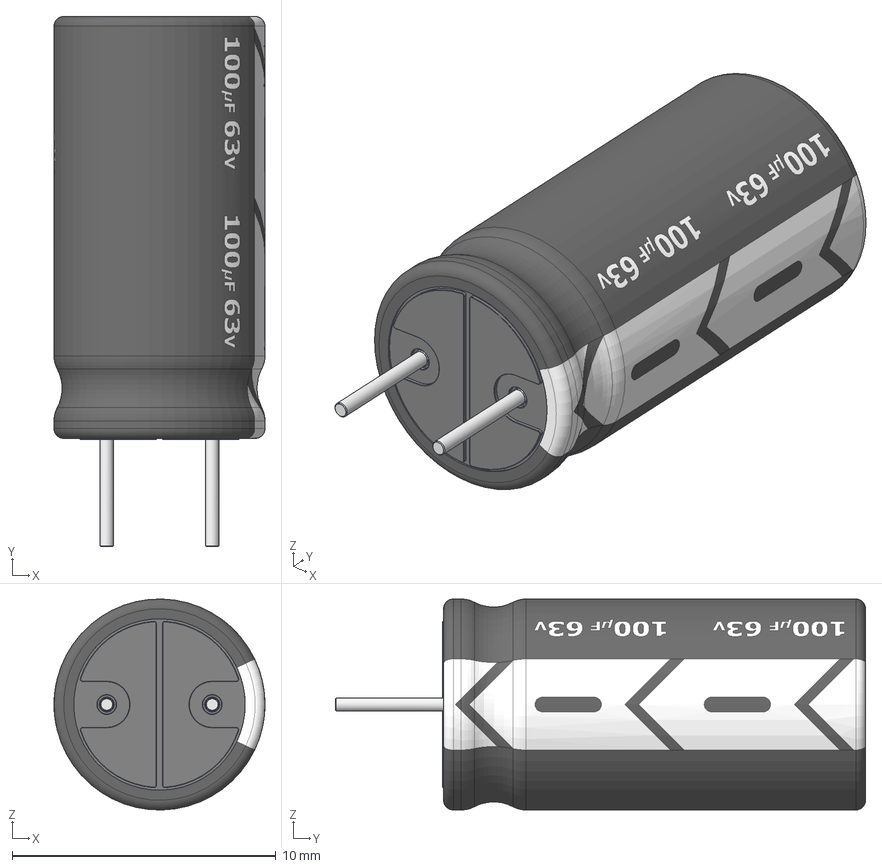
[picture p36: CAD file, 2025-02-04]
components/eletrolitico/CAPACITOR BLACK-WHITE/100uF/100uF 63V electr 8 x16mm -P.diameter 4mm-Black-White.stp
8.00 x 20.1 x 8.00 mm
