joaocolombari/Gagabiro/components/eletrolitico/CAPACITOR BLACK-WHITE/2200uF/2200uF 63V electr 20 x42mm -P.diameter 10mm-Black-White.stp

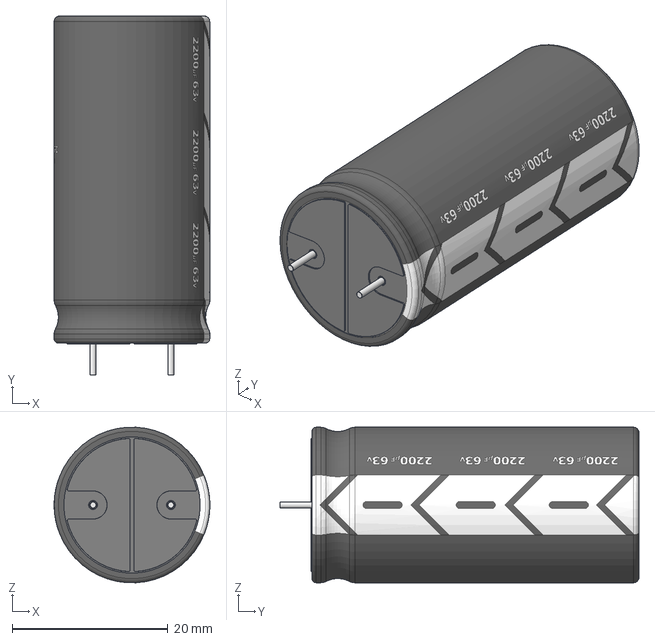
[picture p37: CAD file, 2025-02-04]
components/eletrolitico/CAPACITOR BLACK-WHITE/2200uF/2200uF 63V electr 20 x42mm -P.diameter 10mm-Black-White.stp
20.0 x 46.1 x 20.0 mm
