joaocolombari/Gagabiro/components/eletrolitico/CAPACITOR BLACK-WHITE/220uF/220uF 25V electr 8 x12mm -P.diameter 4mm-Black-White.stp

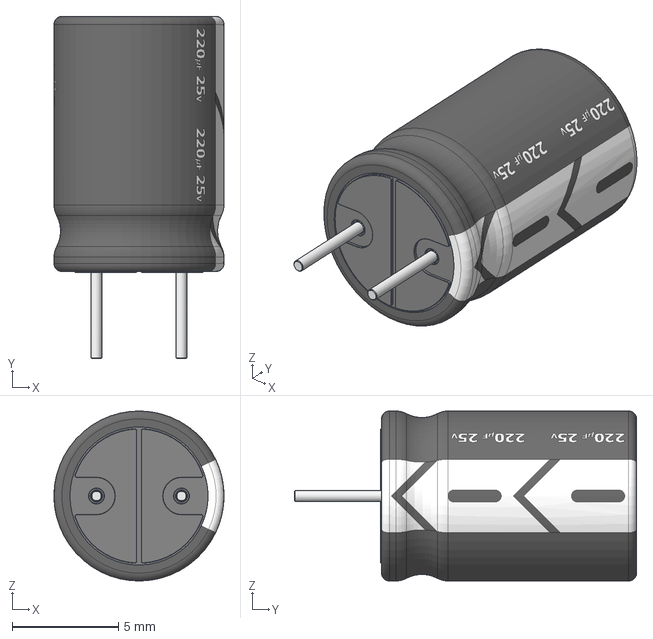
[picture p38: CAD file, 2025-02-04]
components/eletrolitico/CAPACITOR BLACK-WHITE/220uF/220uF 25V electr 8 x12mm -P.diameter 4mm-Black-White.stp
8.00 x 16.1 x 8.00 mm
