joaocolombari/Gagabiro/components/eletrolitico/CAPACITOR BLACK-WHITE/3300uF/3300uF 50V electr 22 x42mm -P.diameter 11mm-Black-White.stp

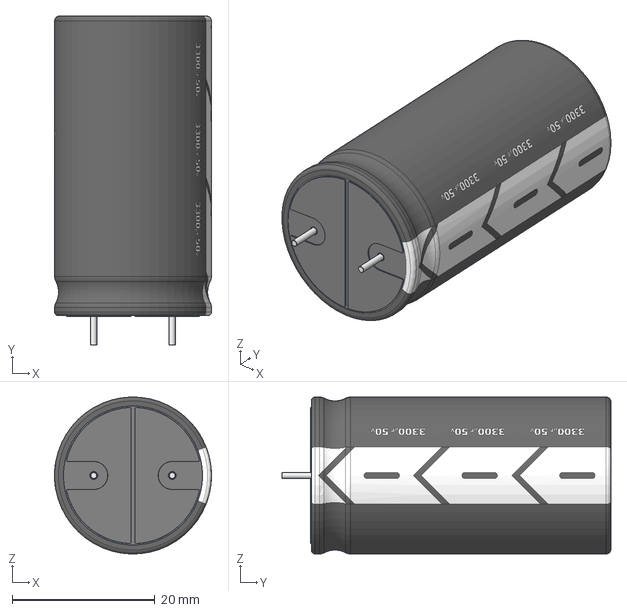
[picture p39: CAD file, 2025-02-04]
components/eletrolitico/CAPACITOR BLACK-WHITE/3300uF/3300uF 50V electr 22 x42mm -P.diameter 11mm-Black-White.stp
22.0 x 46.1 x 22.0 mm
