joaocolombari/Gagabiro/components/eletrolitico/CAPACITOR BLACK-WHITE/330uF/330uF 25V electr 8 x14mm P.diameter 4mm-Black-White.stp

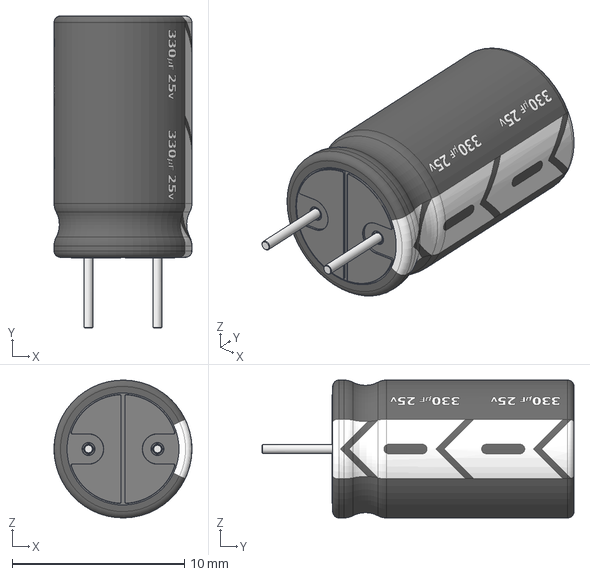
[picture p40: CAD file, 2025-02-04]
components/eletrolitico/CAPACITOR BLACK-WHITE/330uF/330uF 25V electr 8 x14mm P.diameter 4mm-Black-White.stp
8.00 x 18.1 x 8.00 mm
