joaocolombari/Gagabiro/components/eletrolitico/CAPACITOR BLACK-WHITE/47uF/47uF 50V electr 6.3 x11mm -P.diameter 3.2mm-Black-White.stp

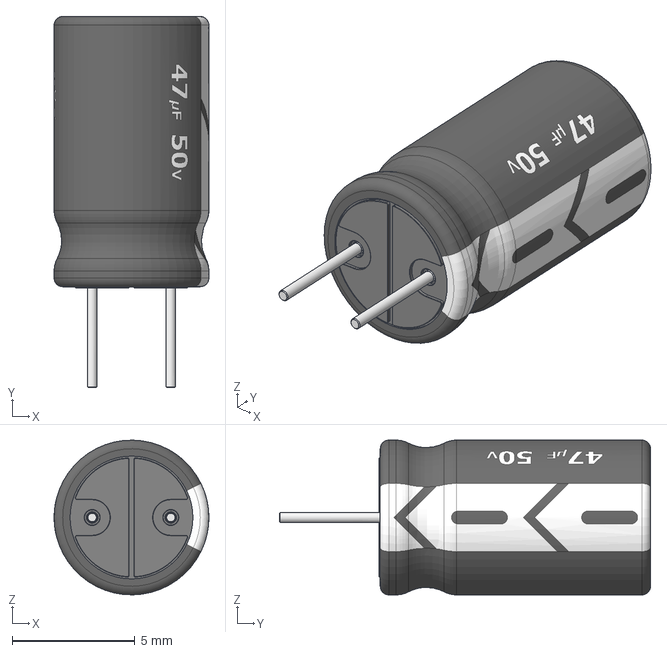
[picture p41: CAD file, 2025-02-04]
components/eletrolitico/CAPACITOR BLACK-WHITE/47uF/47uF 50V electr 6.3 x11mm -P.diameter 3.2mm-Black-White.stp
6.30 x 15.1 x 6.30 mm
