joaocolombari/Gagabiro/components/eletrolitico/panassonic/CAPPRD1000W100D2200H5000.stp

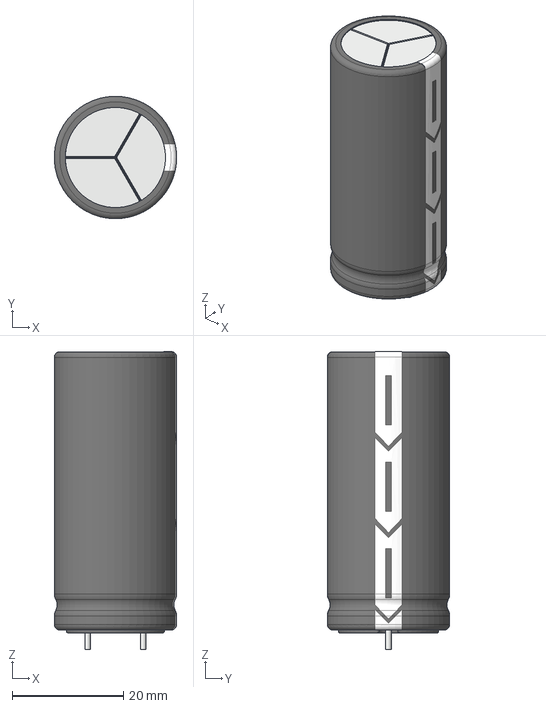
[picture p42: CAD file, 2025-02-04]
components/eletrolitico/panassonic/CAPPRD1000W100D2200H5000.stp
22.0 x 22.0 x 53.5 mm
