joaocolombari/Gagabiro/components/heatsink/sk406.SLDPRT

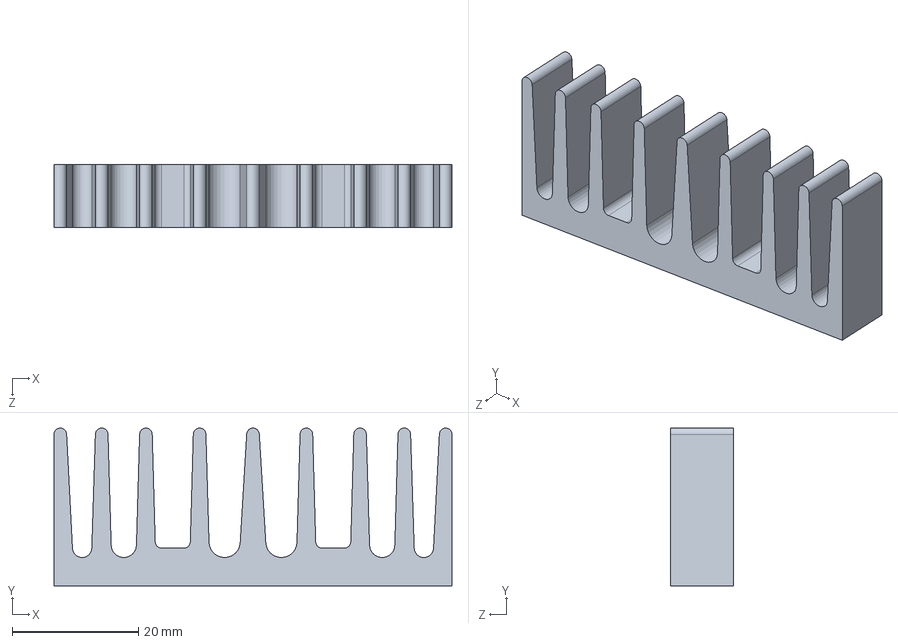
[picture p43: CAD file, 2025-02-04]
components/heatsink/sk406.SLDPRT
63.0 x 25.0 x 10.0 mm
