joaocolombari/Gagabiro/components/KTT0003A.stp

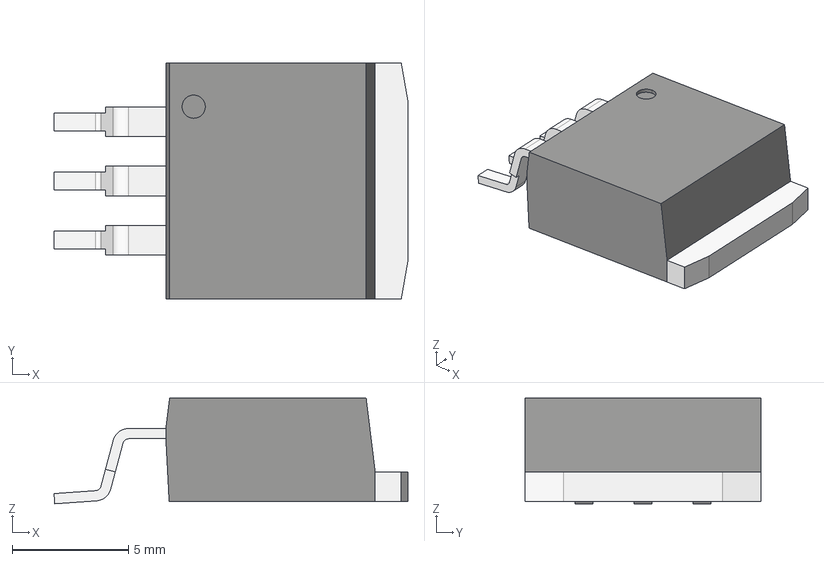
[picture p44: CAD file, 2025-02-04]
components/KTT0003A.stp
15.2 x 10.2 x 4.54 mm
BODY-TO
HTSINK-TO263
LEAD-TO263 x 3
