joaocolombari/Gagabiro/components/LM317MDT-TR/3D/LM317MDT-TR.stp

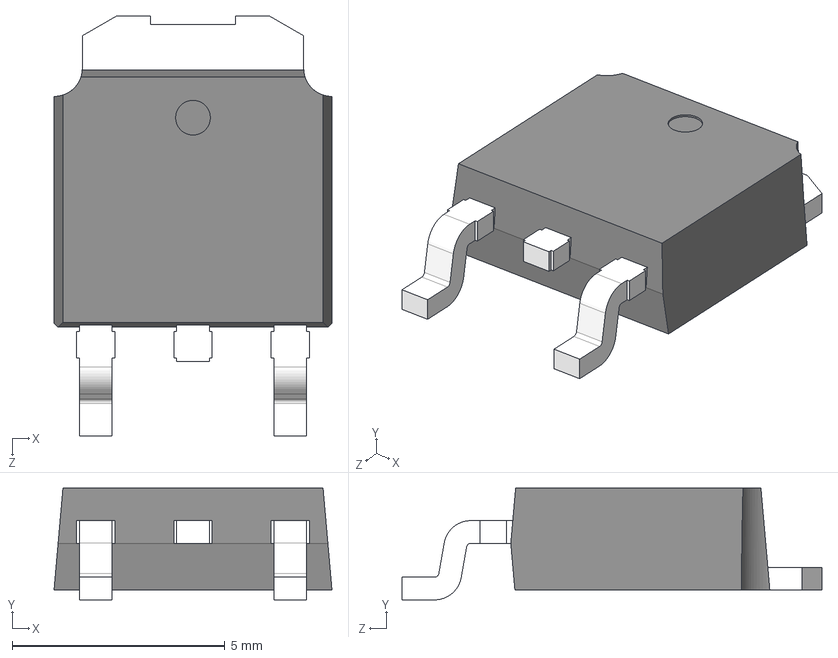
[picture p45: CAD file, 2025-02-04]
components/LM317MDT-TR/3D/LM317MDT-TR.stp
6.54 x 2.63 x 9.88 mm
