joaocolombari/Gagabiro/components/LM337KVURG3/3D/LM337KVURG3.stp

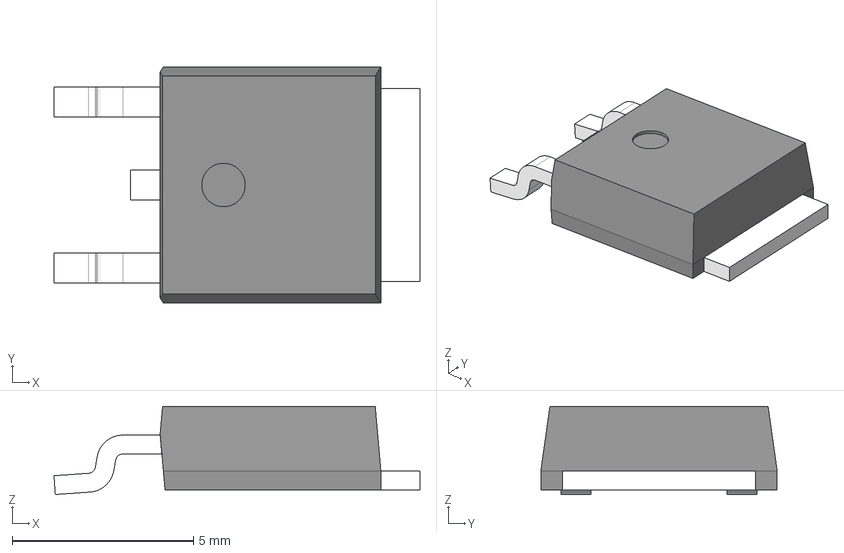
[picture p46: CAD file, 2025-02-04]
components/LM337KVURG3/3D/LM337KVURG3.stp
10.1 x 6.53 x 2.43 mm
BODY-TO
HEATSINK-TO252
LEAD-TO x 2
LEAD-MIDDLE
