joaocolombari/Gagabiro/components/octal/octal clamp.SLDPRT

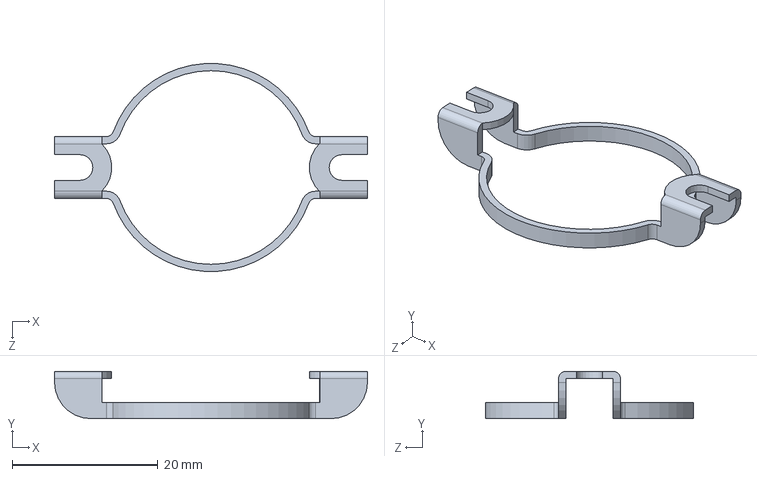
[picture p47: CAD file, 2025-02-04]
components/octal/octal clamp.SLDPRT
43.0 x 6.50 x 28.5 mm
