joaocolombari/Gagabiro/components/octal/octal/Octal Tube Socket/Octal tube socket.step

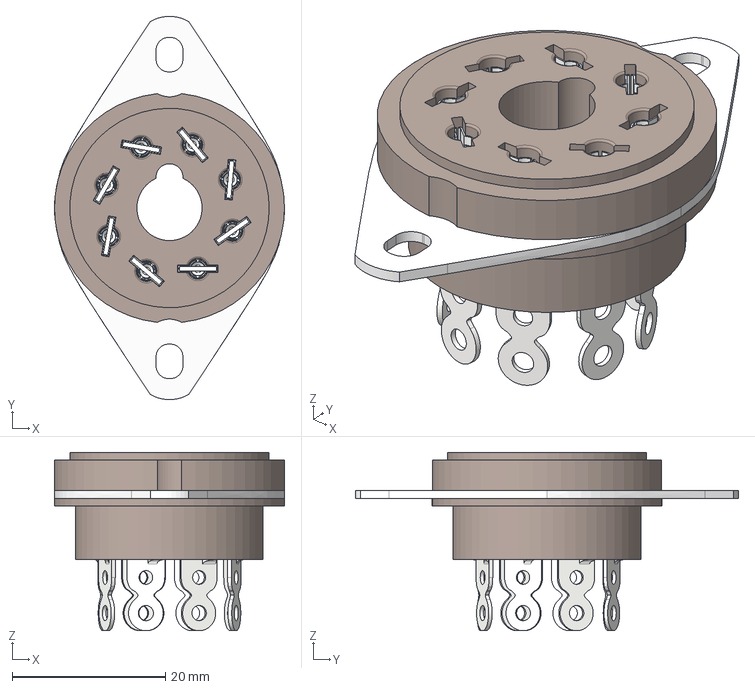
[picture p48: CAD file, 2025-02-04]
components/octal/octal/Octal Tube Socket/Octal tube socket.step
30.0 x 50.0 x 23.3 mm
