joaocolombari/Gagabiro/components/res/PMFLR - PR02  - 100r - 2w.STEP

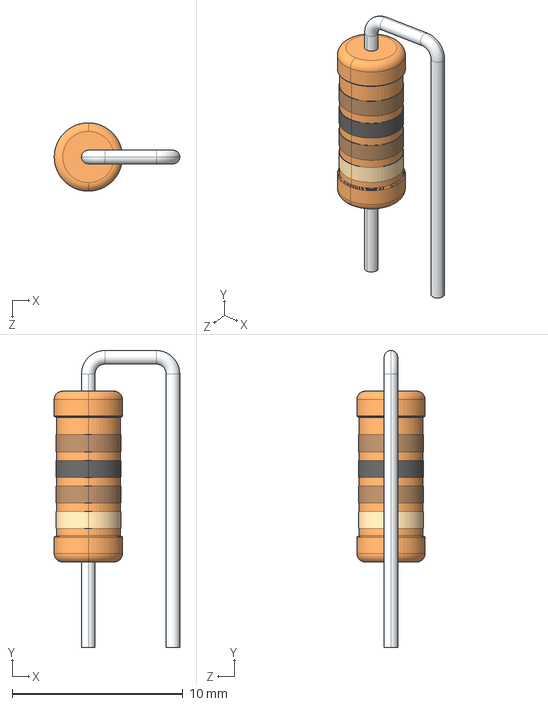
[picture p49: CAD file, 2025-02-04]
components/res/PMFLR - PR02 - 100r - 2w.STEP
7.35 x 17.4 x 4.00 mm
