joaocolombari/Gagabiro/Gagabiro_supply/Gagabiro_supply.step

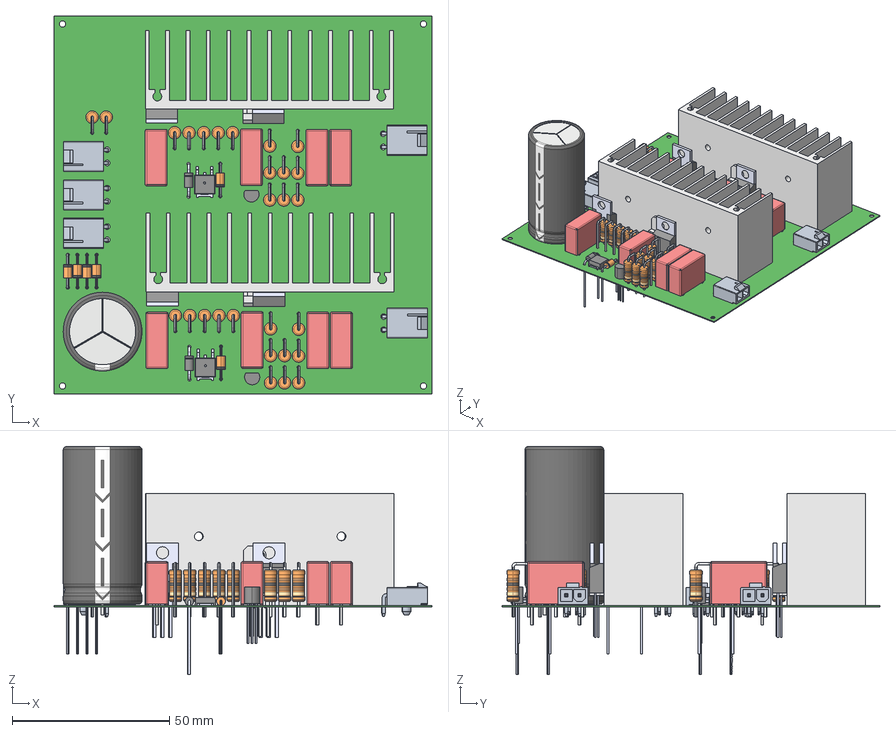
[picture p50: CAD file, 2025-02-04]
Gagabiro_supply/Gagabiro_supply.step
119.9 x 120.0 x 72.4 mm
CAPPRD1250W100D2500H5000
Heatsink_final x 2
TO-220_final x 2
LM317AMDT x 2
PMFLR - PR02 - 100r - 2w x 28
FILM_RED_P1500L1800W700H1400PD80 x 8
LM329AZ x 2
