joaocolombari/Gagabiro/components/12ax7/12AX7--3DModel-STEP-1.STEP

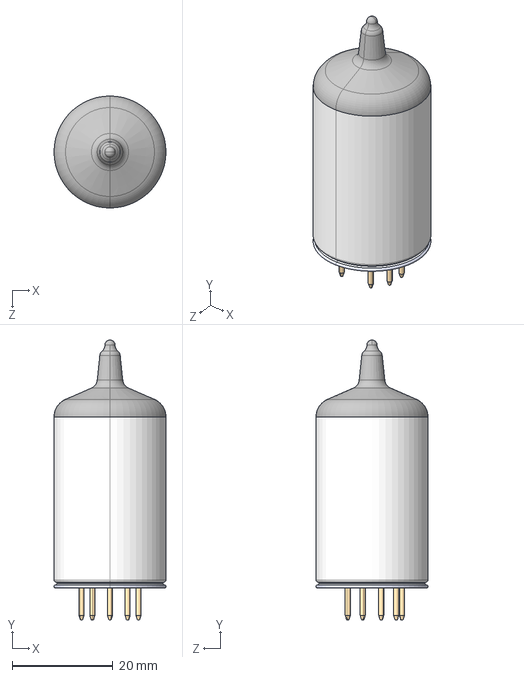
[picture p51: CAD file, 2025-02-04]
components/12ax7/12AX7--3DModel-STEP-1.STEP
22.2 x 55.6 x 22.2 mm
