joaocolombari/Gagabiro/components/12ax7/2/terminal.SLDPRT

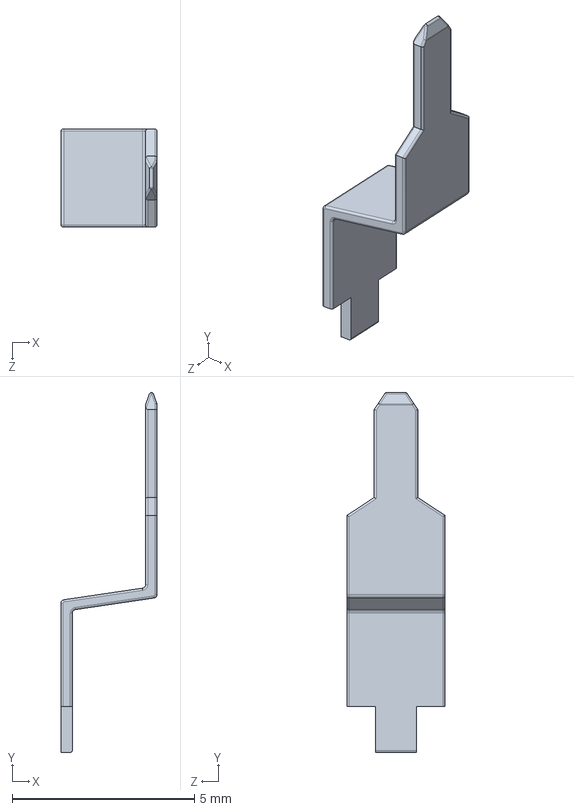
[picture p52: CAD file, 2025-02-04]
components/12ax7/2/terminal.SLDPRT
2.65 x 9.89 x 2.69 mm
