joaocolombari/Gagabiro/components/12ax7/valvula 12ax7/coluna-cintura-baixa.SLDPRT

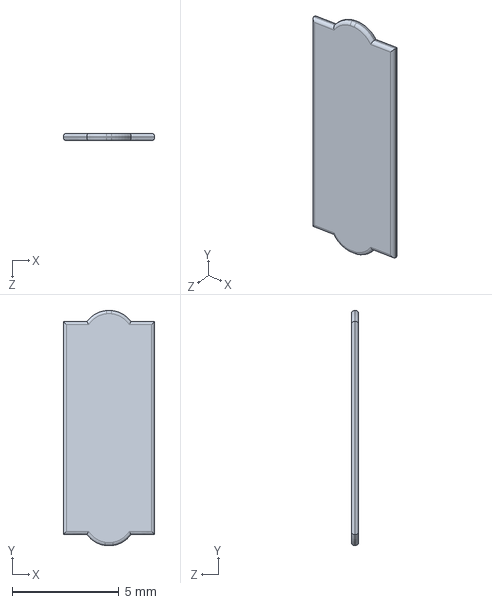
[picture p53: CAD file, 2025-02-04]
components/12ax7/valvula 12ax7/coluna-cintura-baixa.SLDPRT
4.28 x 11.0 x 0.35 mm
