joaocolombari/Gagabiro/components/capacitor/stp/ECW-FD2J-393-KB.stp

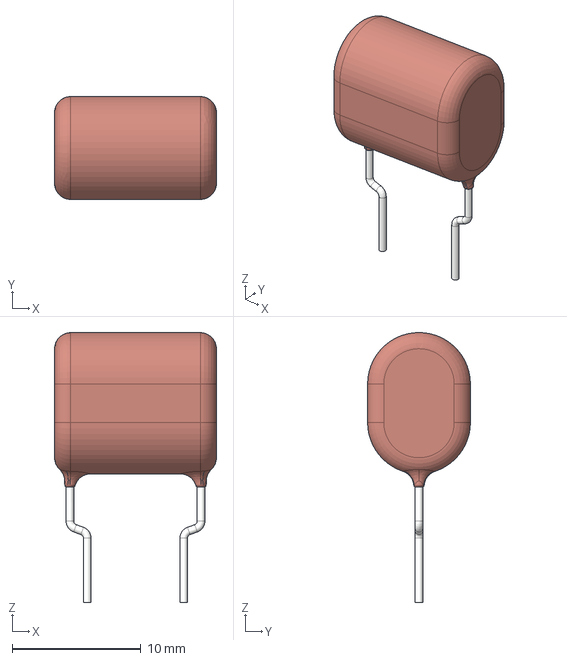
[picture p54: CAD file, 2025-02-04]
components/capacitor/stp/ECW-FD2J-393-KB.stp
12.6 x 8.00 x 21.0 mm
