joaocolombari/Gagabiro/components/eletrolitico/CAPACITOR BLACK-WHITE/1000uF/1000uF 25V electr 13 x20mm -P.diameter 5.5mm-Black-White.stp

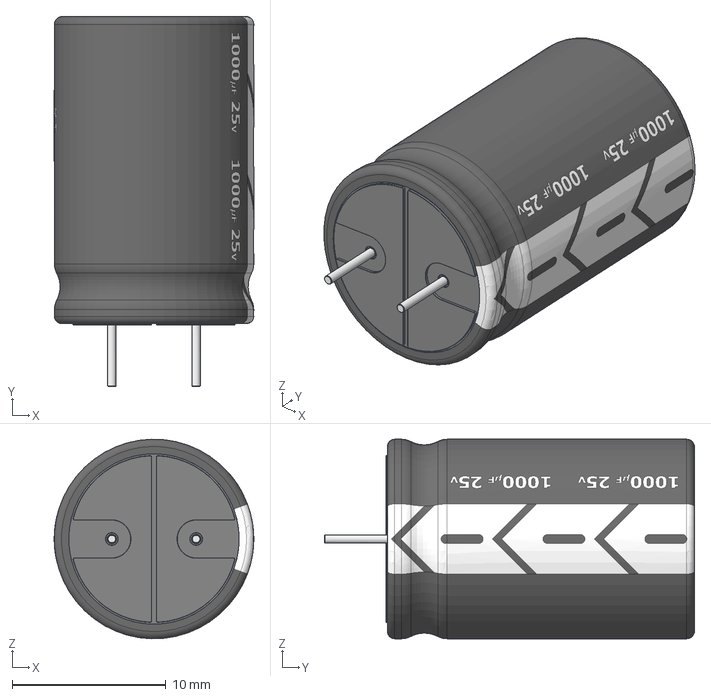
[picture p55: CAD file, 2025-02-04]
components/eletrolitico/CAPACITOR BLACK-WHITE/1000uF/1000uF 25V electr 13 x20mm -P.diameter 5.5mm-Black-White.stp
13.0 x 24.1 x 13.0 mm
