joaocolombari/Gagabiro/components/eletrolitico/CAPACITOR BLACK-WHITE/2200uF/2200uF 100V electr 25 x50mm -P.diameter 12.5mm-Black-White.stp

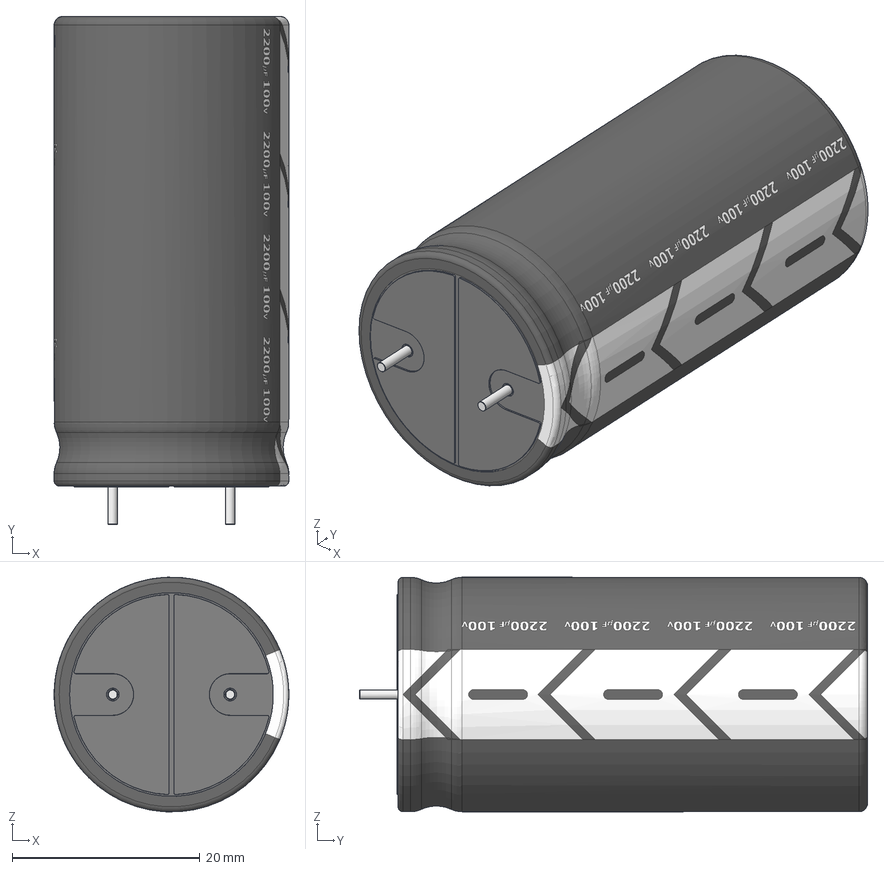
[picture p56: CAD file, 2025-02-04]
components/eletrolitico/CAPACITOR BLACK-WHITE/2200uF/2200uF 100V electr 25 x50mm -P.diameter 12.5mm-Black-White.stp
25.0 x 54.1 x 25.0 mm
