joaocolombari/Gagabiro/components/eletrolitico/CAPACITOR BLACK-WHITE/220uF/220uF 16V electr 6.3 x12mm -P.diameter 3.2mm-Black-White.stp

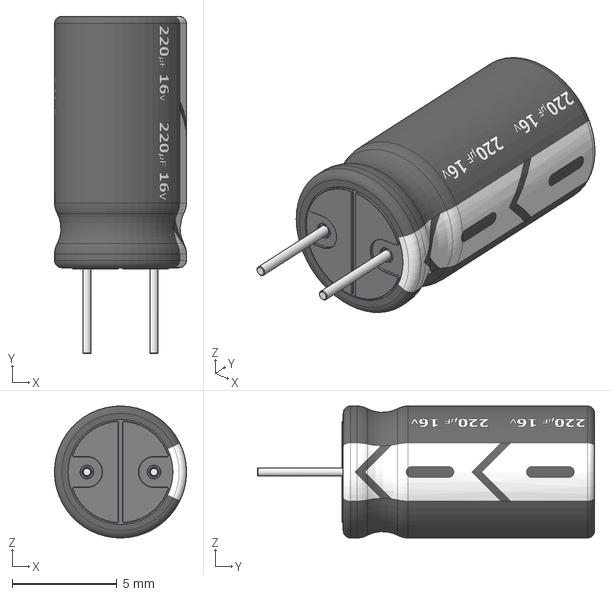
[picture p57: CAD file, 2025-02-04]
components/eletrolitico/CAPACITOR BLACK-WHITE/220uF/220uF 16V electr 6.3 x12mm -P.diameter 3.2mm-Black-White.stp
6.30 x 16.1 x 6.30 mm
