joaocolombari/Gagabiro/components/eletrolitico/CAPACITOR BLACK-WHITE/3300uF/3300uF 25V electr 16 x26mm -P.diameter 8mm-Black-White.stp

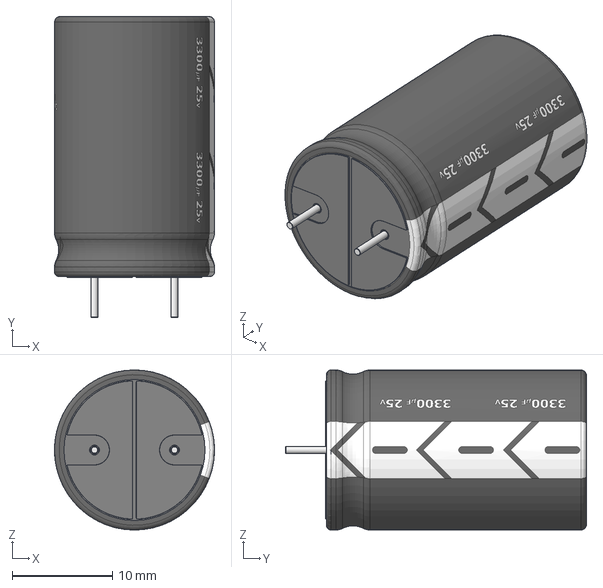
[picture p58: CAD file, 2025-02-04]
components/eletrolitico/CAPACITOR BLACK-WHITE/3300uF/3300uF 25V electr 16 x26mm -P.diameter 8mm-Black-White.stp
16.0 x 30.1 x 16.0 mm
