joaocolombari/Gagabiro/components/eletrolitico/CAPACITOR BLACK-WHITE/330uF/330uF 50V electr 10 x20mm -P.diameter 5mm-Black-White.stp

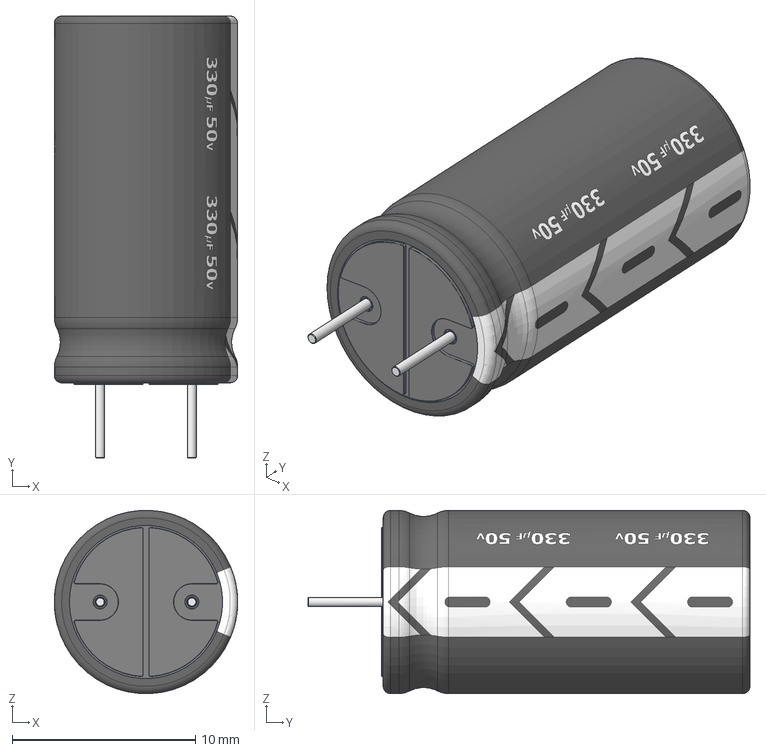
[picture p59: CAD file, 2025-02-04]
components/eletrolitico/CAPACITOR BLACK-WHITE/330uF/330uF 50V electr 10 x20mm -P.diameter 5mm-Black-White.stp
10.0 x 24.1 x 9.99 mm
