joaocolombari/Gagabiro/components/eletrolitico/panassonic/CAPPRD750W80D1600H3550.stp

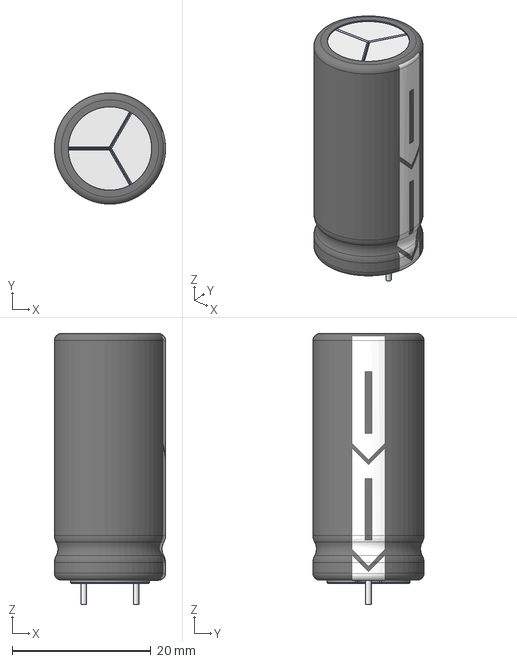
[picture p61: CAD file, 2025-02-04]
components/eletrolitico/panassonic/CAPPRD750W80D1600H3550.stp
16.0 x 16.0 x 39.0 mm
