joaocolombari/Gagabiro/components/heatsink/sk505.SLDPRT

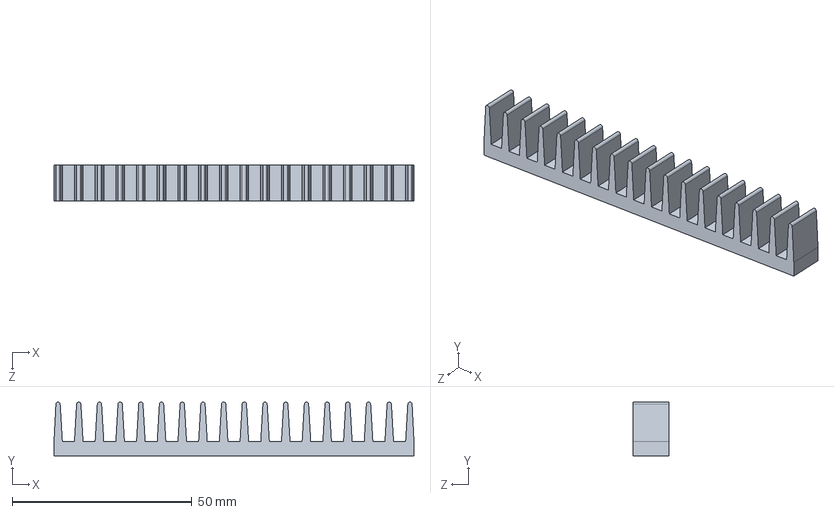
[picture p62: CAD file, 2025-02-04]
components/heatsink/sk505.SLDPRT
100.0 x 15.0 x 10.0 mm
