joaocolombari/Gagabiro/components/12ax7/2/Base plastica.SLDPRT

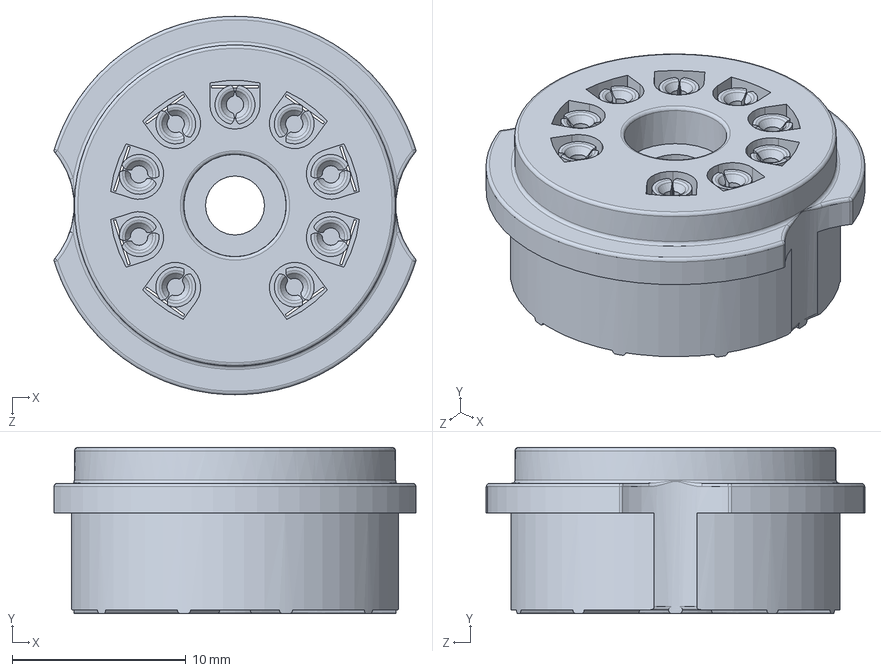
[picture p63: CAD file, 2025-02-04]
components/12ax7/2/Base plastica.SLDPRT
20.8 x 9.56 x 21.8 mm
