joaocolombari/Gagabiro/components/12ax7/valvula 12ax7/terminais.SLDPRT

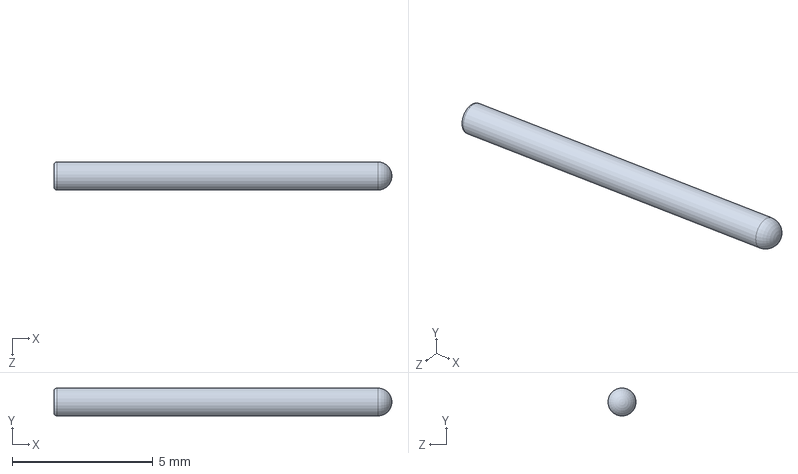
[picture p64: CAD file, 2025-02-04]
components/12ax7/valvula 12ax7/terminais.SLDPRT
12.0 x 0.993 x 1.00 mm
