joaocolombari/Gagabiro/components/capacitor/stp/ECW-FD2J-334-KB.stp

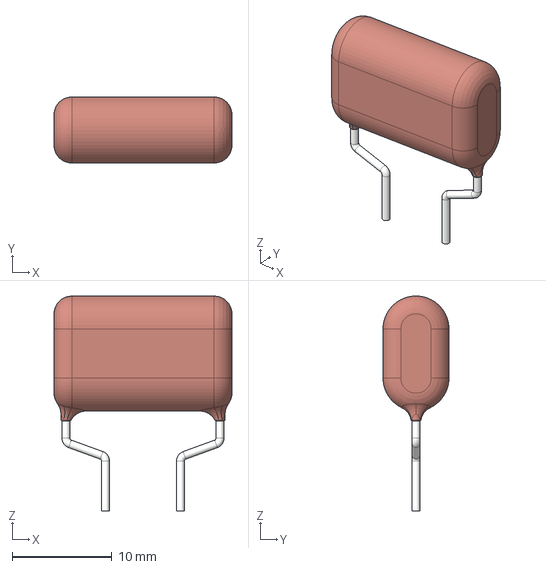
[picture p65: CAD file, 2025-02-04]
components/capacitor/stp/ECW-FD2J-334-KB.stp
17.8 x 6.60 x 21.5 mm
