joaocolombari/Gagabiro/components/eletrolitico/CAPACITOR BLACK-WHITE/1000uF/1000uF 63V electr 16 x33mm -P.diameter 8mm-Black-White.stp

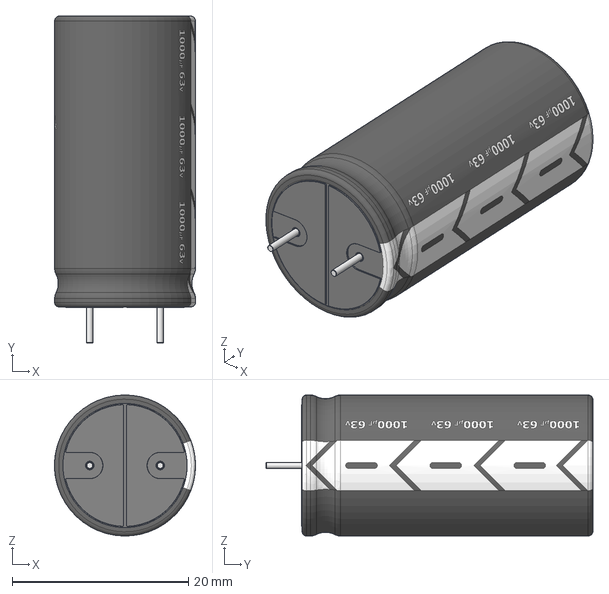
[picture p66: CAD file, 2025-02-04]
components/eletrolitico/CAPACITOR BLACK-WHITE/1000uF/1000uF 63V electr 16 x33mm -P.diameter 8mm-Black-White.stp
16.0 x 37.1 x 16.0 mm
