joaocolombari/Gagabiro/components/eletrolitico/CAPACITOR BLACK-WHITE/2200uF/2200uF 25V electr 13 x26mm -P.diameter 6.5mm-Black-White.stp

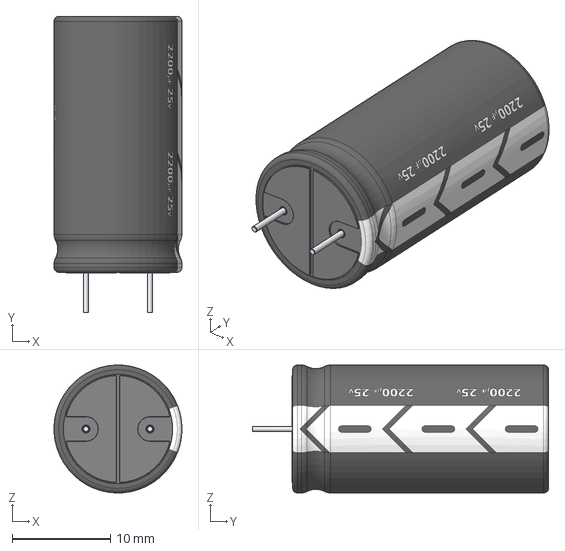
[picture p67: CAD file, 2025-02-04]
components/eletrolitico/CAPACITOR BLACK-WHITE/2200uF/2200uF 25V electr 13 x26mm -P.diameter 6.5mm-Black-White.stp
13.0 x 30.1 x 13.0 mm
