joaocolombari/Gagabiro/components/eletrolitico/CAPACITOR BLACK-WHITE/220uF/220uF 50V electr 10 x16mm  -P.diameter 5mm-Black-White.stp

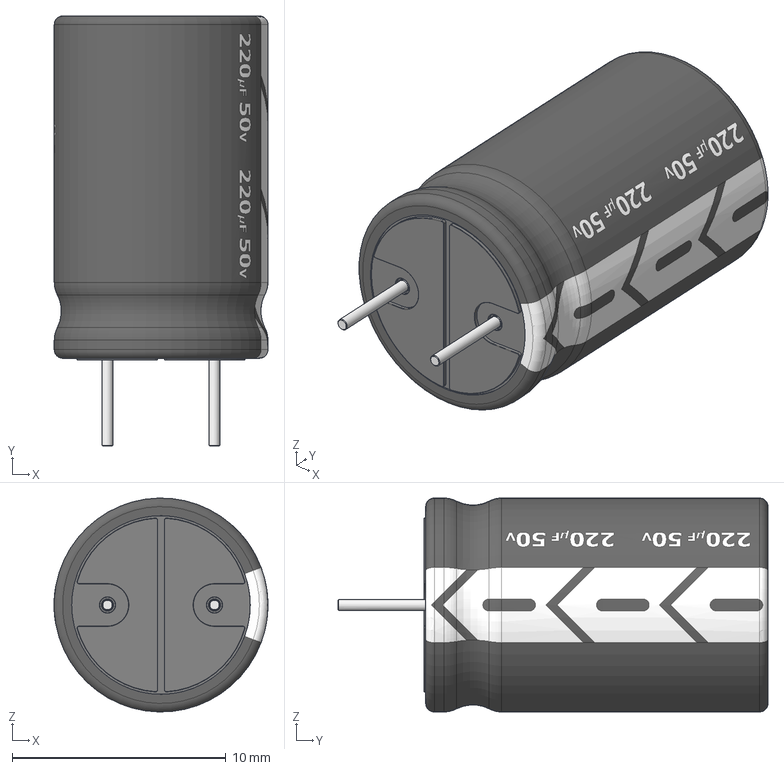
[picture p68: CAD file, 2025-02-04]
components/eletrolitico/CAPACITOR BLACK-WHITE/220uF/220uF 50V electr 10 x16mm -P.diameter 5mm-Black-White.stp
10.0 x 20.1 x 10.00 mm
