joaocolombari/Gagabiro/components/eletrolitico/CAPACITOR BLACK-WHITE/4700uF/4700uF 25V Electr 16 x35 -P.diameter 8mm-Black-White.stp

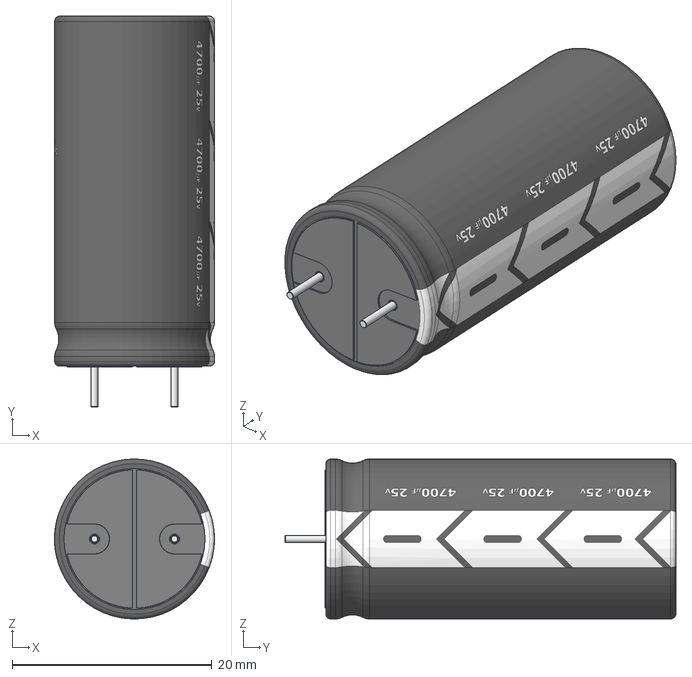
[picture p69: CAD file, 2025-02-04]
components/eletrolitico/CAPACITOR BLACK-WHITE/4700uF/4700uF 25V Electr 16 x35 -P.diameter 8mm-Black-White.stp
16.0 x 39.1 x 16.0 mm
