joaocolombari/Gagabiro/components/eletrolitico/panassonic/CAPPRD350W60D800H1150.stp

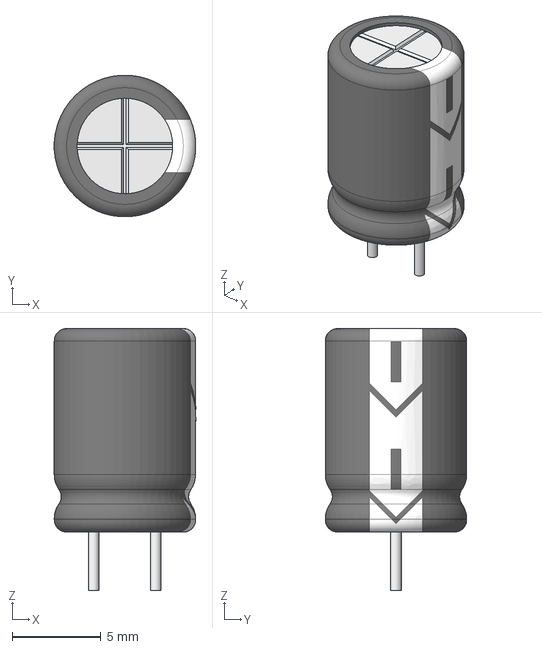
[picture p70: CAD file, 2025-02-04]
components/eletrolitico/panassonic/CAPPRD350W60D800H1150.stp
7.99 x 7.99 x 14.8 mm
