joaocolombari/Gagabiro/components/heatsink/TO220_heatsinkE.step

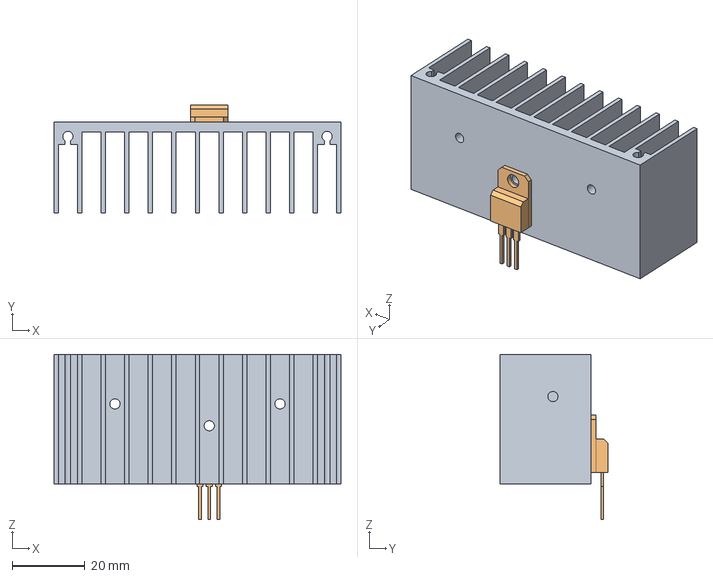
[picture p71: CAD file, 2025-02-04]
components/heatsink/TO220_heatsinkE.step
78.7 x 29.6 x 45.3 mm
Heatsink_final
TO-220_final
