joaocolombari/Gagabiro/components/octal/octal-socket.stp

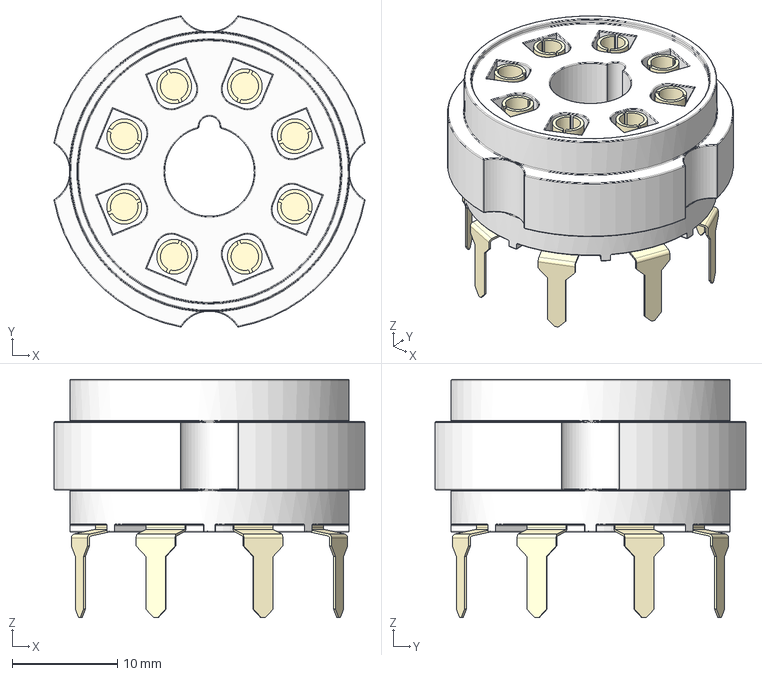
[picture p72: CAD file, 2025-02-04]
components/octal/octal-socket.stp
29.5 x 29.5 x 22.6 mm
