joaocolombari/Gagabiro/components/12ax7/valvula 12ax7/chapeu-dissipador.SLDPRT

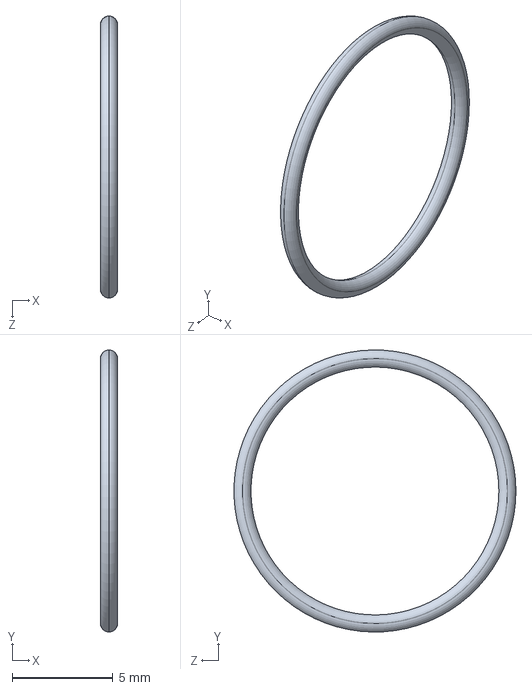
[picture p73: CAD file, 2025-02-04]
components/12ax7/valvula 12ax7/chapeu-dissipador.SLDPRT
0.85 x 14.0 x 14.0 mm
