joaocolombari/Gagabiro/components/capacitor/stp/ECW-FD2J-223-KB.stp

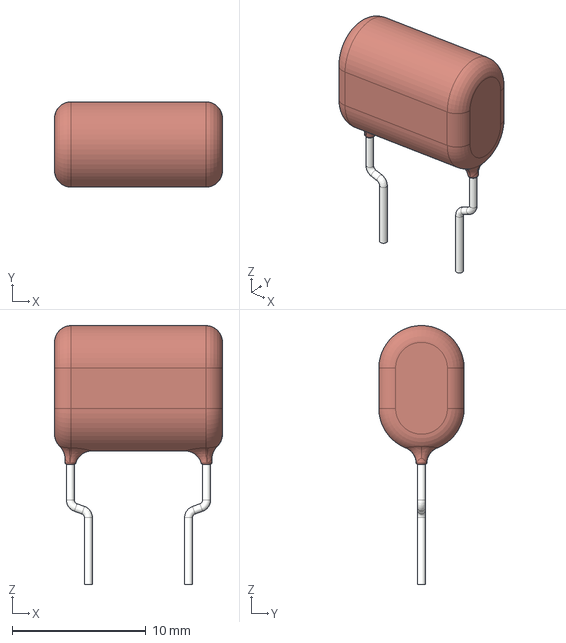
[picture p74: CAD file, 2025-02-04]
components/capacitor/stp/ECW-FD2J-223-KB.stp
12.6 x 6.40 x 19.4 mm
