joaocolombari/Gagabiro/components/eletrolitico/CAPACITOR BLACK-WHITE/2200uF/2200uF 50V electr 18 x35mm -P.diameter 9mm-Black-White.stp

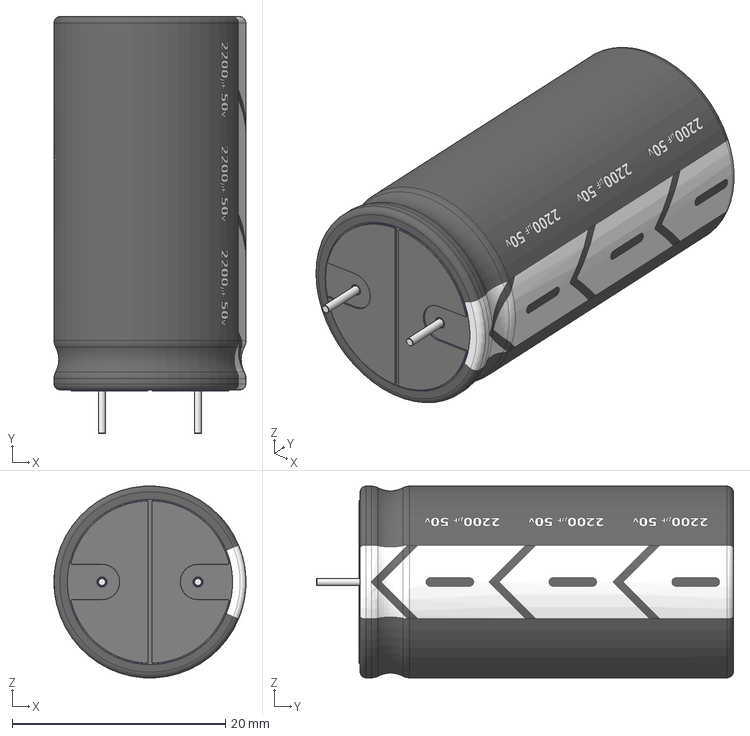
[picture p75: CAD file, 2025-02-04]
components/eletrolitico/CAPACITOR BLACK-WHITE/2200uF/2200uF 50V electr 18 x35mm -P.diameter 9mm-Black-White.stp
18.0 x 39.1 x 18.0 mm
