joaocolombari/Gagabiro/components/eletrolitico/CAPACITOR BLACK-WHITE/4700uF/4700uF 50V Electr 18 x37 -P.diameter 7mm-Black-White.stp

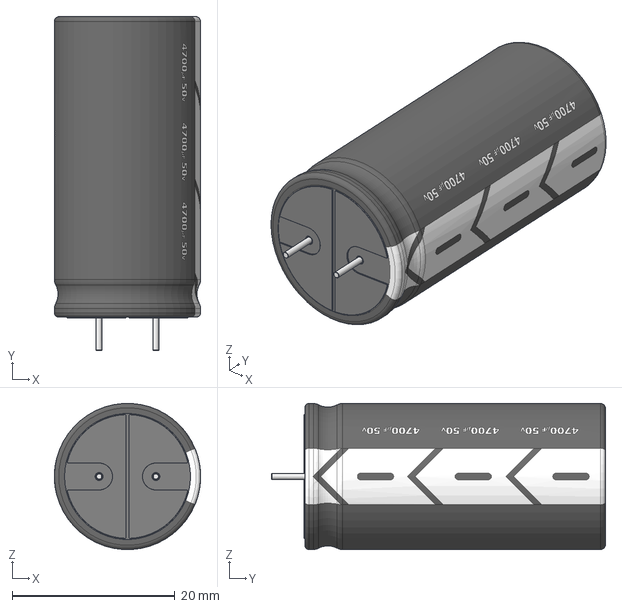
[picture p76: CAD file, 2025-02-04]
components/eletrolitico/CAPACITOR BLACK-WHITE/4700uF/4700uF 50V Electr 18 x37 -P.diameter 7mm-Black-White.stp
18.0 x 41.1 x 18.0 mm
