joaocolombari/Gagabiro/components/eletrolitico/panassonic/CAPPRD150W45D400H700.stp

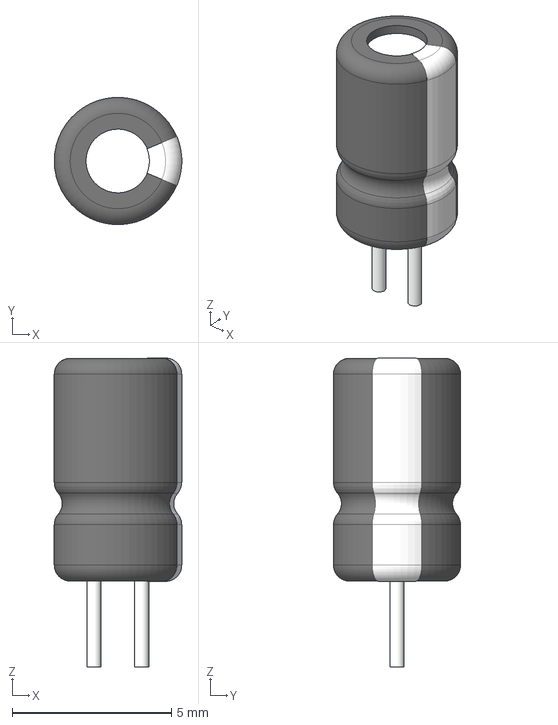
[picture p77: CAD file, 2025-02-04]
components/eletrolitico/panassonic/CAPPRD150W45D400H700.stp
4.01 x 3.99 x 9.71 mm
