joaocolombari/Gagabiro/components/heatsink/ick_s_40x40x20.SLDPRT

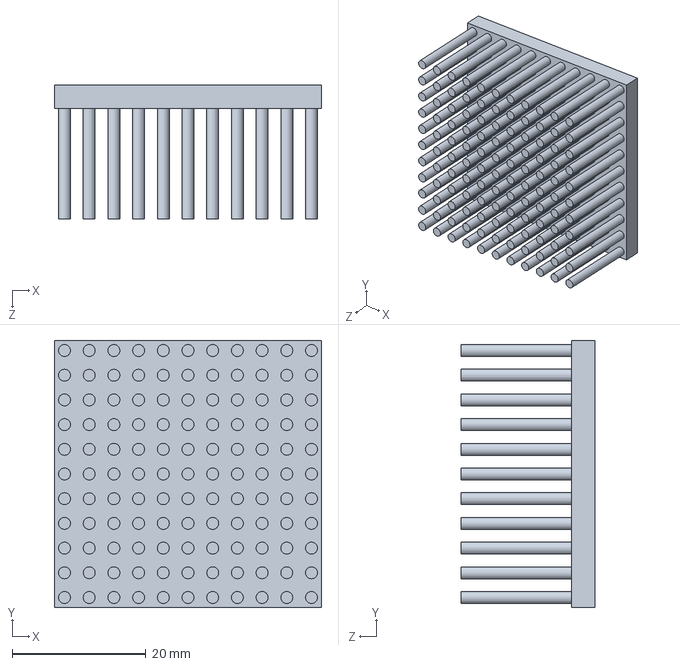
[picture p78: CAD file, 2025-02-04]
components/heatsink/ick_s_40x40x20.SLDPRT
40.0 x 40.0 x 20.0 mm
