joaocolombari/Gagabiro/components/octal/octal ceramic.SLDPRT

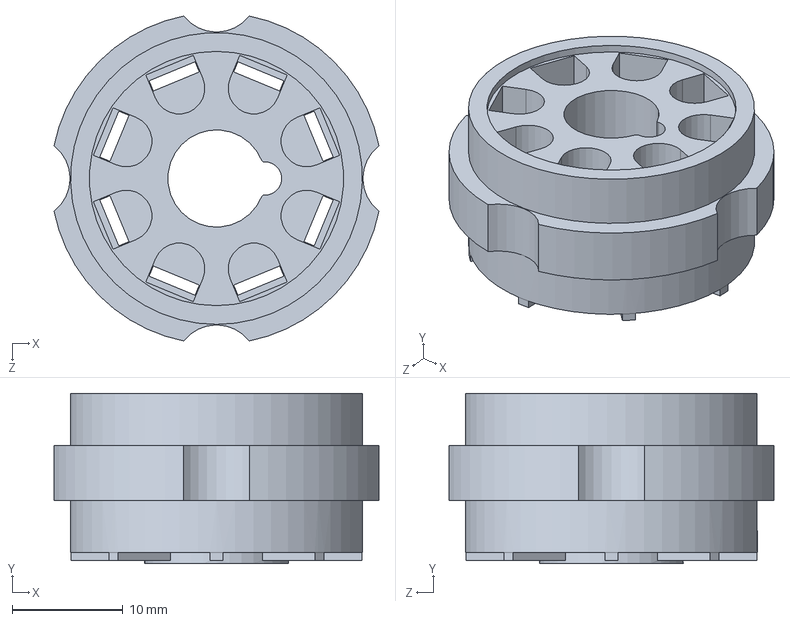
[picture p79: CAD file, 2025-02-04]
components/octal/octal ceramic.SLDPRT
29.4 x 15.4 x 29.4 mm
