joaocolombari/Gagabiro/components/12ax7/valvula 12ax7/terminais-internos.SLDPRT

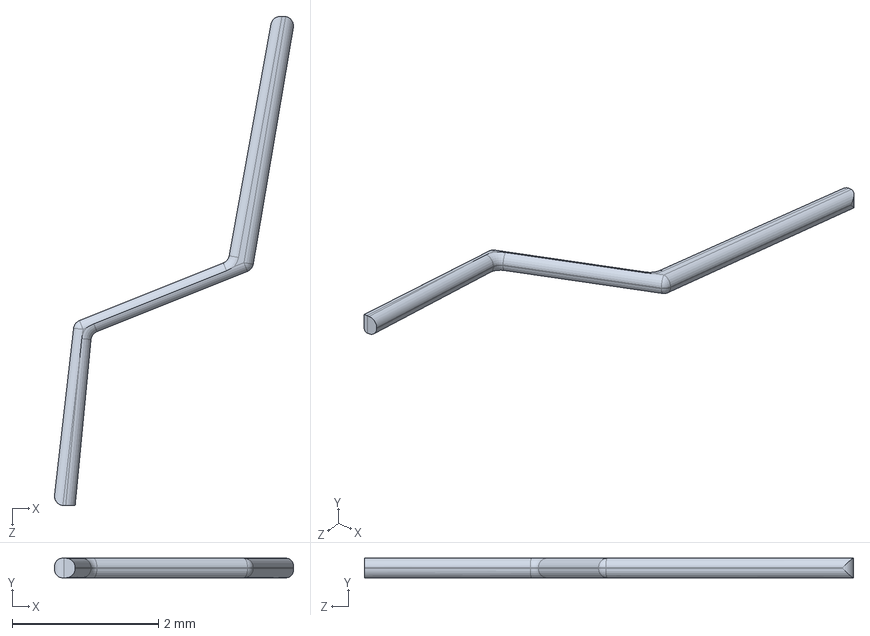
[picture p80: CAD file, 2025-02-04]
components/12ax7/valvula 12ax7/terminais-internos.SLDPRT
3.27 x 0.27 x 6.70 mm
