joaocolombari/Gagabiro/components/capacitor/stp/ECW-FD2J-563-KB.stp

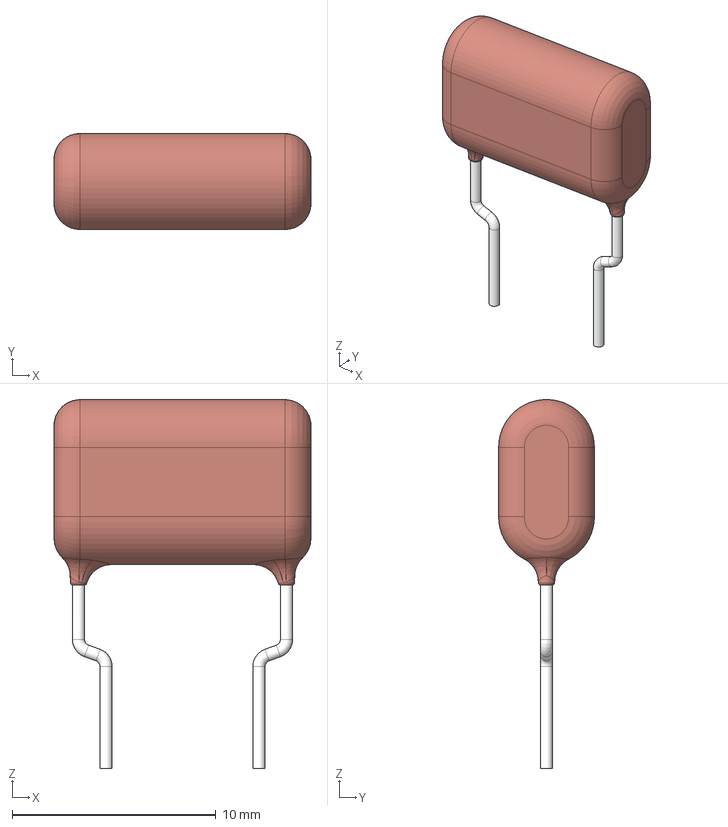
[picture p81: CAD file, 2025-02-04]
components/capacitor/stp/ECW-FD2J-563-KB.stp
12.6 x 4.70 x 18.1 mm
