joaocolombari/Gagabiro/components/eletrolitico/CAPACITOR BLACK-WHITE/100uF/100uF 63V electr 9.5 x12mm -P.diameter 4.6mm-Black-White.stp

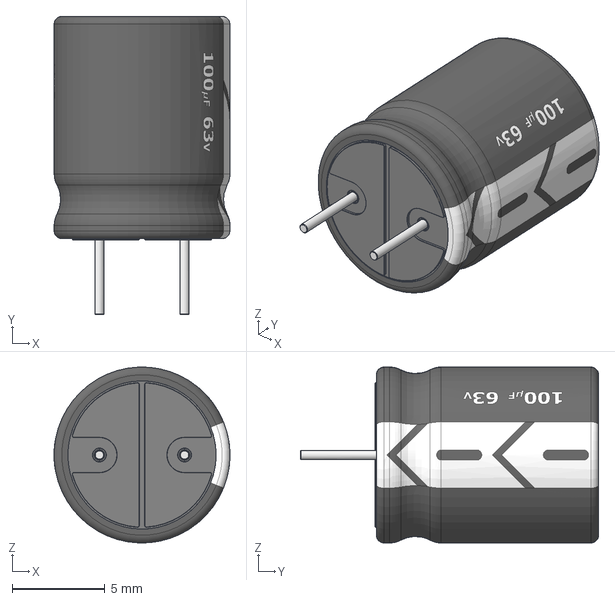
[picture p82: CAD file, 2025-02-04]
components/eletrolitico/CAPACITOR BLACK-WHITE/100uF/100uF 63V electr 9.5 x12mm -P.diameter 4.6mm-Black-White.stp
9.50 x 16.1 x 9.49 mm
