joaocolombari/Gagabiro/components/eletrolitico/panassonic/CAPPRD500W60D1250H2500.stp

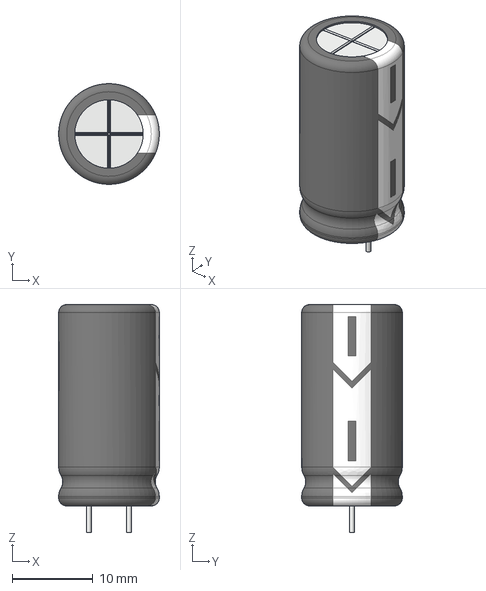
[picture p83: CAD file, 2025-02-04]
components/eletrolitico/panassonic/CAPPRD500W60D1250H2500.stp
12.5 x 12.5 x 28.3 mm
