joaocolombari/Gagabiro/components/heatsink/sk592.SLDPRT

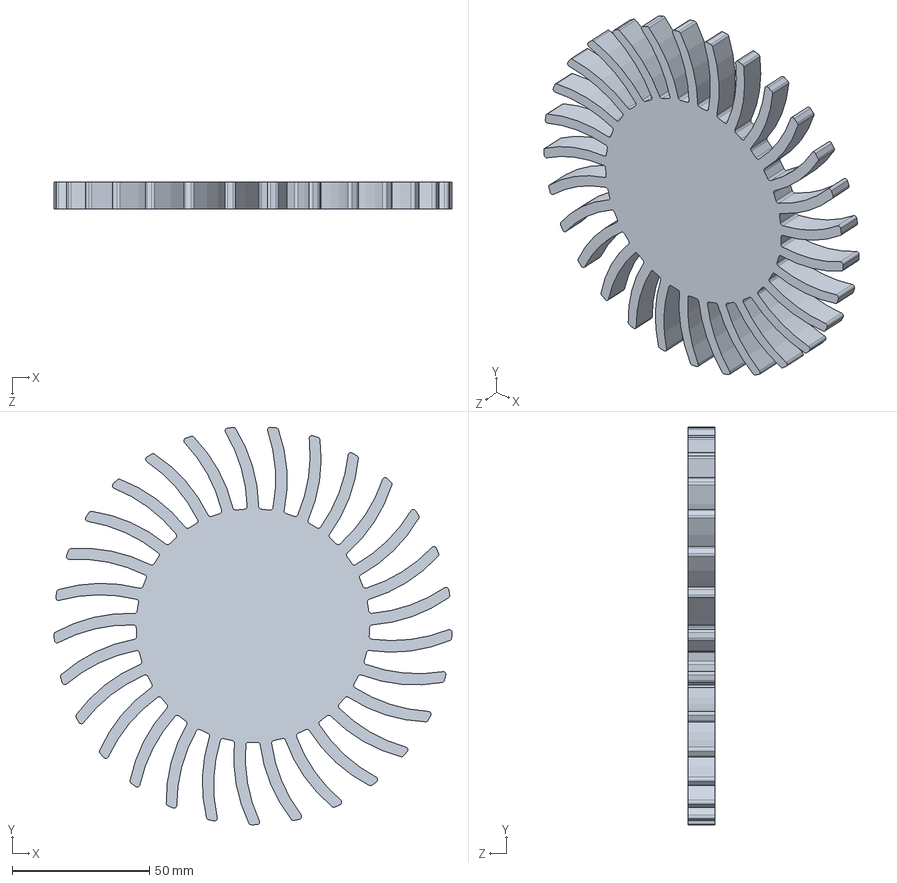
[picture p84: CAD file, 2025-02-04]
components/heatsink/sk592.SLDPRT
144.9 x 144.7 x 10.0 mm
