joaocolombari/Gagabiro/components/octal/octal tag.SLDPRT

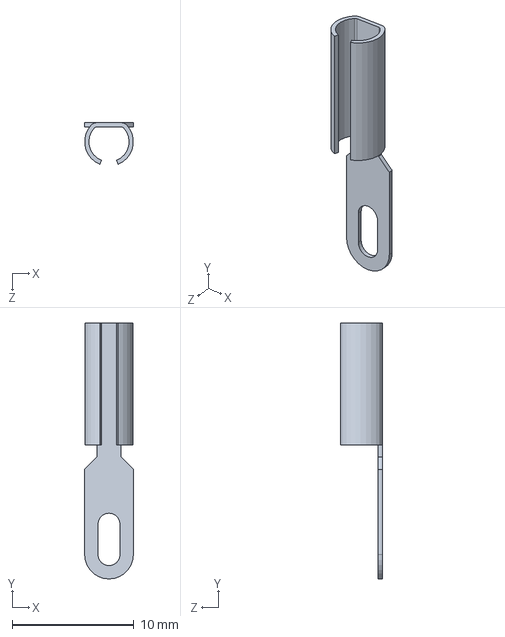
[picture p85: CAD file, 2025-02-04]
components/octal/octal tag.SLDPRT
4.00 x 21.0 x 3.42 mm
