joaocolombari/Gagabiro/Gagabiro/Gagabiro_dissipadores.STEP

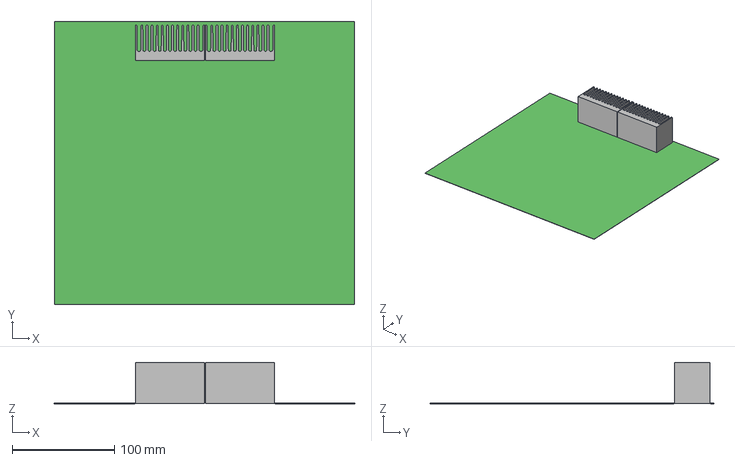
[picture p86: CAD file, 2024-12-14]
Gagabiro/Gagabiro_dissipadores.STEP
292.9 x 276.7 x 40.4 mm
Extruded x 2
