joaocolombari/Gagabiro/components/12ax7/valvula 12ax7/corpo-vidro-meio.SLDPRT

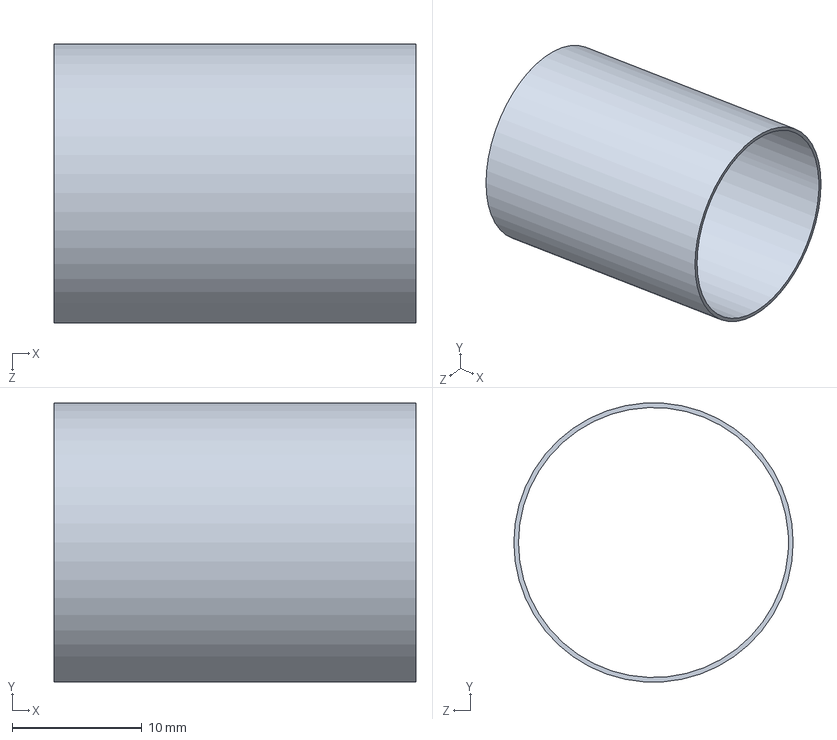
[picture p87: CAD file, 2025-02-04]
components/12ax7/valvula 12ax7/corpo-vidro-meio.SLDPRT
27.9 x 21.5 x 21.5 mm
