joaocolombari/Gagabiro/components/capacitor/stp/ECW-FD2J-225-KB.stp

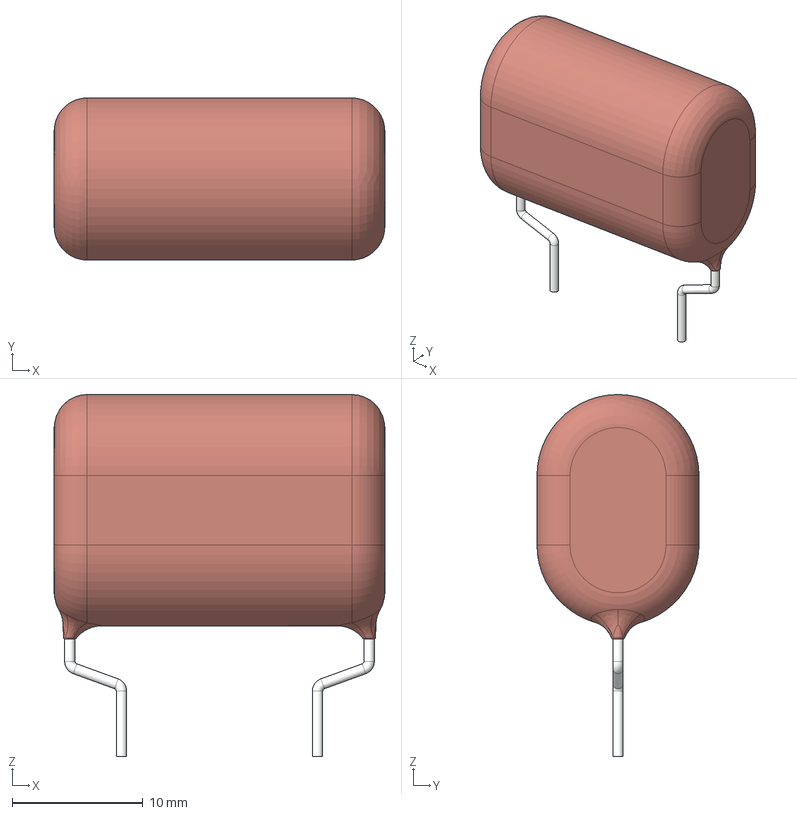
[picture p88: CAD file, 2025-02-04]
components/capacitor/stp/ECW-FD2J-225-KB.stp
25.3 x 12.4 x 27.7 mm
