joaocolombari/Gagabiro/components/eletrolitico/CAPACITOR BLACK-WHITE/4700uF/4700uF 63V Electr 22 x41 -P.diameter 10mm-Black-White.stp

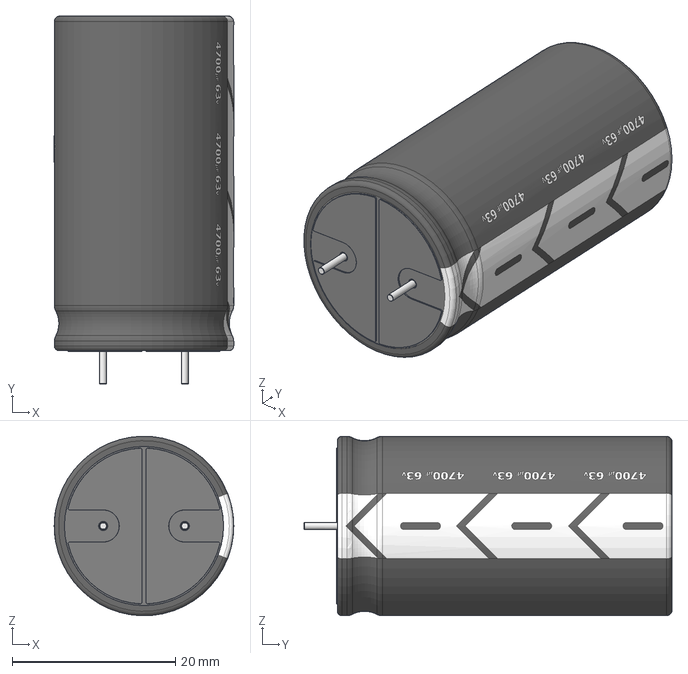
[picture p89: CAD file, 2025-02-04]
components/eletrolitico/CAPACITOR BLACK-WHITE/4700uF/4700uF 63V Electr 22 x41 -P.diameter 10mm-Black-White.stp
22.0 x 45.1 x 22.0 mm
