joaocolombari/Gagabiro/components/eletrolitico/CAPACITOR BLACK-WHITE/47uF/47uF 35V electr 8 x11mm  -P.diameter 3.5mm-Black-White.stp

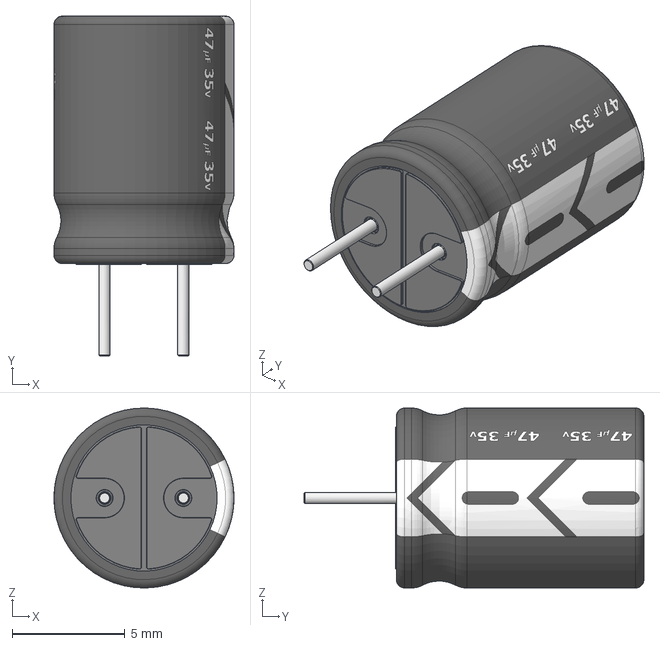
[picture p90: CAD file, 2025-02-04]
components/eletrolitico/CAPACITOR BLACK-WHITE/47uF/47uF 35V electr 8 x11mm -P.diameter 3.5mm-Black-White.stp
8.00 x 15.1 x 8.00 mm
