joaocolombari/Gagabiro/components/eletrolitico/panassonic/CAPPRD200W50D500H1100.stp

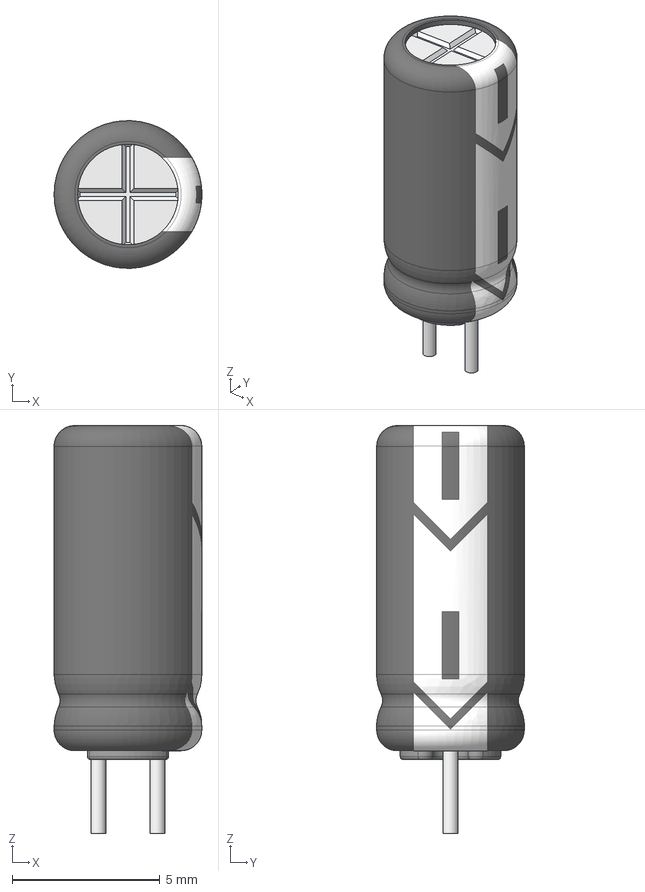
[picture p91: CAD file, 2025-02-04]
components/eletrolitico/panassonic/CAPPRD200W50D500H1100.stp
5.00 x 4.99 x 13.8 mm
