joaocolombari/Gagabiro/components/heatsink/sk081.SLDPRT

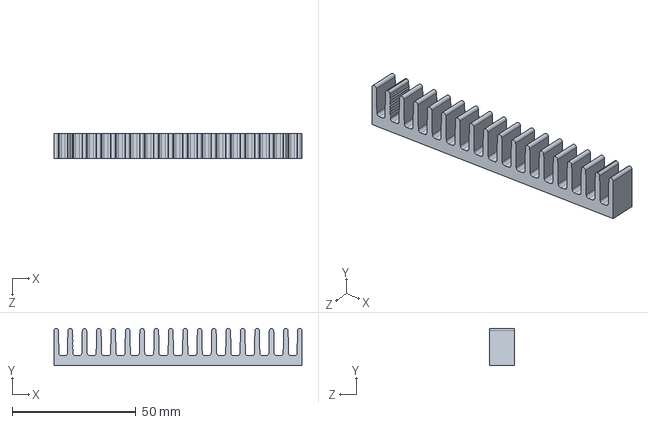
[picture p92: CAD file, 2025-02-04]
components/heatsink/sk081.SLDPRT
100.0 x 15.0 x 10.0 mm
