joaocolombari/Gagabiro/components/12ax7/valvula 12ax7/suporte-dissipador.SLDPRT

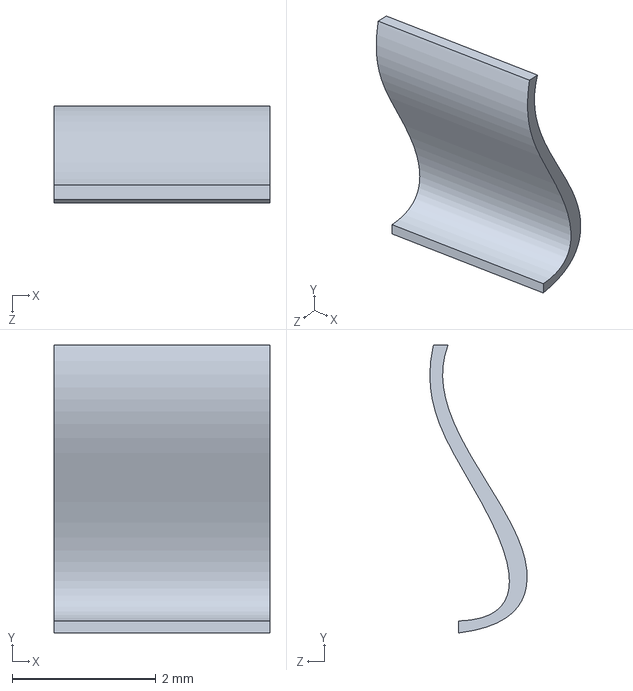
[picture p93: CAD file, 2025-02-04]
components/12ax7/valvula 12ax7/suporte-dissipador.SLDPRT
3.00 x 4.00 x 1.35 mm
