joaocolombari/Gagabiro/components/capacitor/stp/ECW-FD2J-183-KB.stp

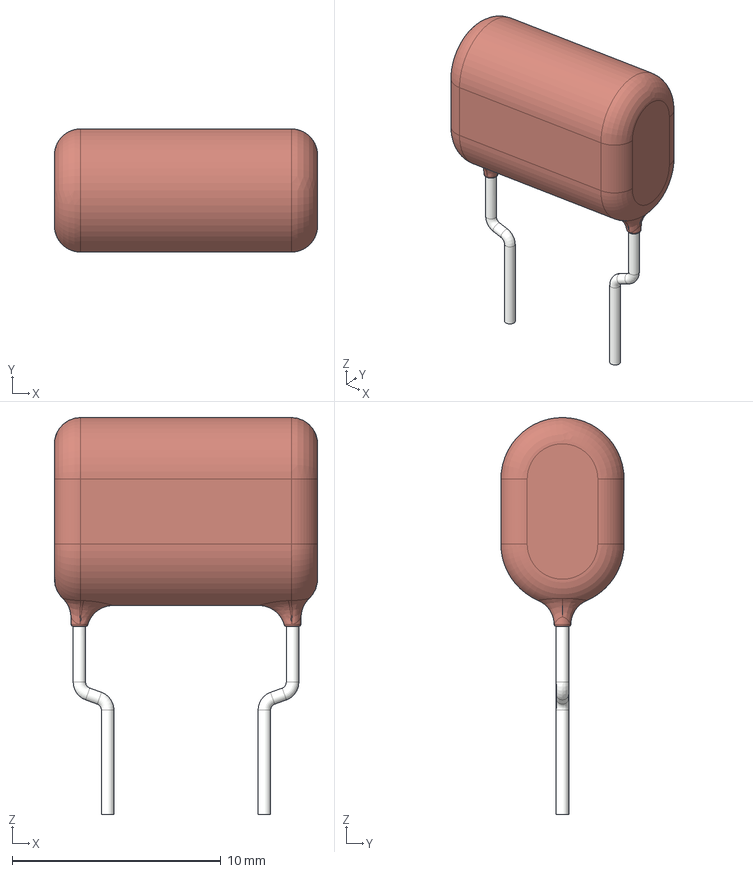
[picture p94: CAD file, 2025-02-04]
components/capacitor/stp/ECW-FD2J-183-KB.stp
12.6 x 5.90 x 19.0 mm
