joaocolombari/Gagabiro/components/eletrolitico/CAPACITOR BLACK-WHITE/2200uF/2200uF 16V electr 13 x25mm -P.diameter 5mm-Black-White.stp

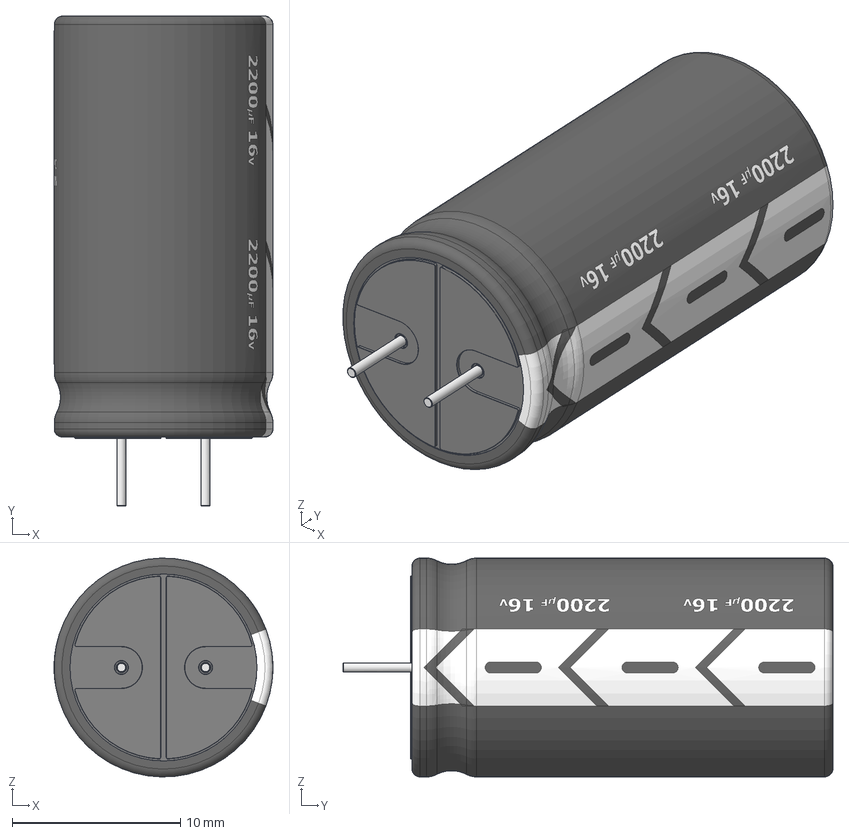
[picture p95: CAD file, 2025-02-04]
components/eletrolitico/CAPACITOR BLACK-WHITE/2200uF/2200uF 16V electr 13 x25mm -P.diameter 5mm-Black-White.stp
13.0 x 29.1 x 13.0 mm
