joaocolombari/Gagabiro/components/eletrolitico/CAPACITOR BLACK-WHITE/4700uF/4700uF 35V Electr 20 x35 -P.diameter 10mm-Black-White.stp

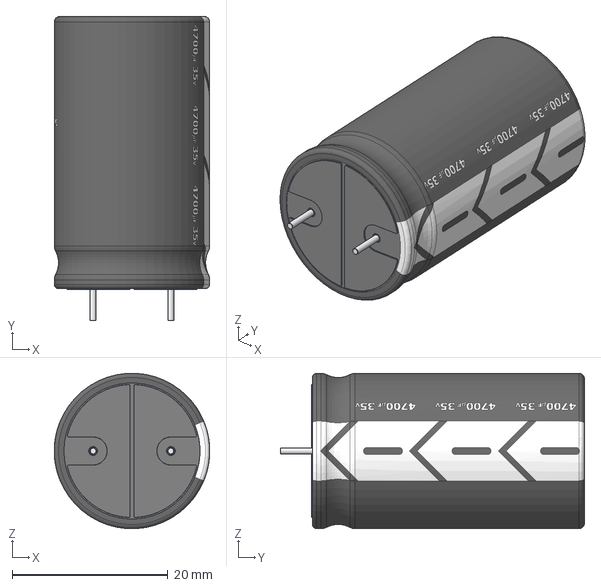
[picture p96: CAD file, 2025-02-04]
components/eletrolitico/CAPACITOR BLACK-WHITE/4700uF/4700uF 35V Electr 20 x35 -P.diameter 10mm-Black-White.stp
20.0 x 39.1 x 20.0 mm
