joaocolombari/Gagabiro/components/eletrolitico/panassonic/CAPPRD1000W100D2000H4000.stp

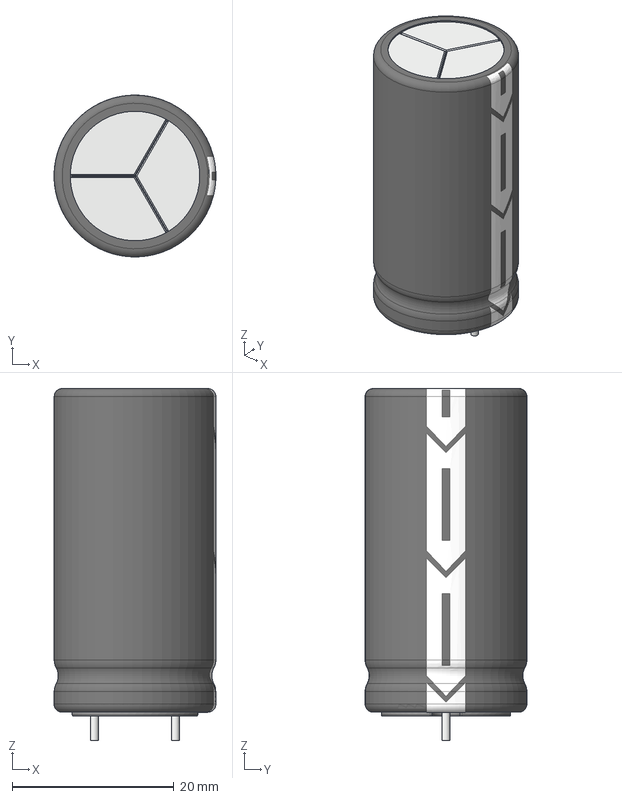
[picture p97: CAD file, 2025-02-04]
components/eletrolitico/panassonic/CAPPRD1000W100D2000H4000.stp
20.0 x 20.0 x 43.5 mm
