joaocolombari/Gagabiro/components/heatsink/sk590.SLDPRT

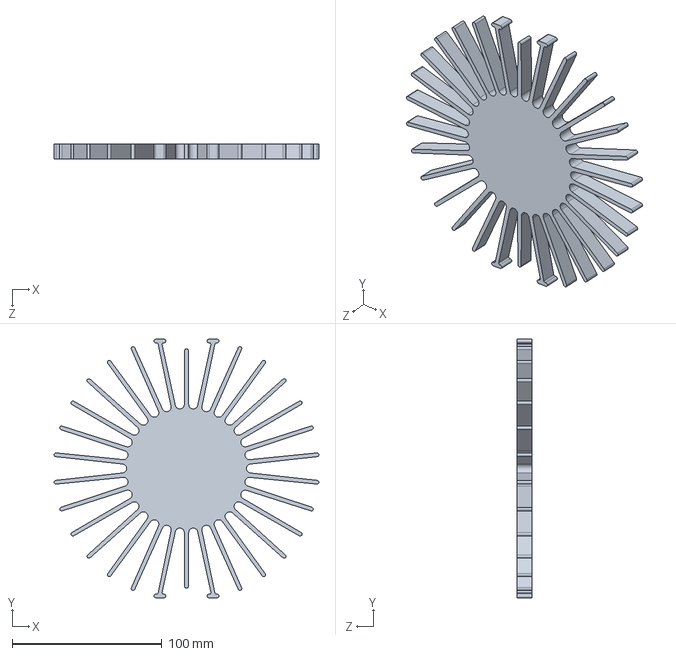
[picture p98: CAD file, 2025-02-04]
components/heatsink/sk590.SLDPRT
177.1 x 172.8 x 10.0 mm
