joaocolombari/Gagabiro/components/12ax7/valvula 12ax7/terminais-lamina.SLDPRT

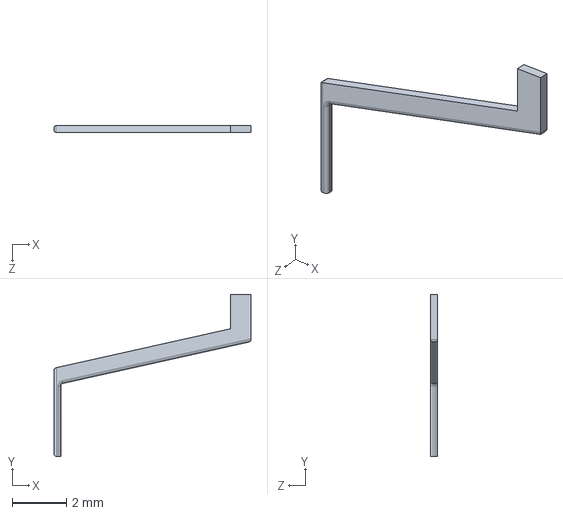
[picture p99: CAD file, 2025-02-04]
components/12ax7/valvula 12ax7/terminais-lamina.SLDPRT
7.29 x 6.00 x 0.27 mm
