joaocolombari/Gagabiro/components/capacitor/stp/ECW-FD2J-824-KB.stp

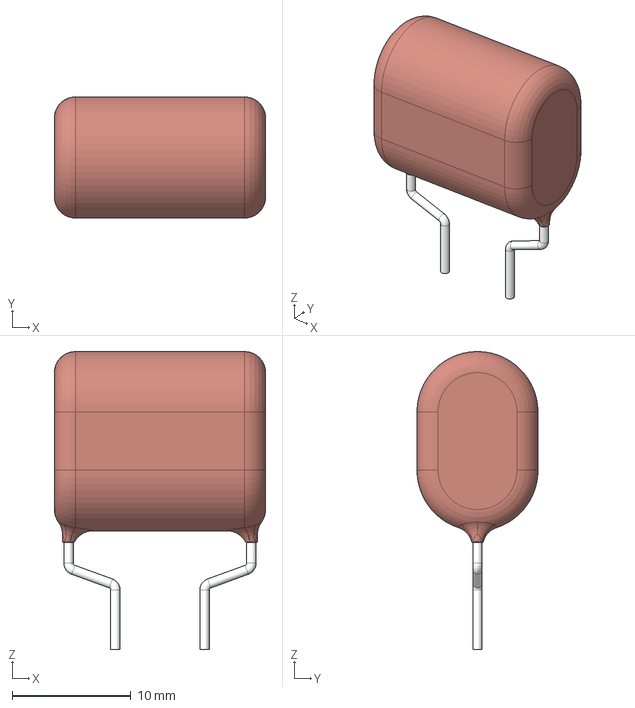
[picture p100: CAD file, 2025-02-04]
components/capacitor/stp/ECW-FD2J-824-KB.stp
17.8 x 10.2 x 25.1 mm
