joaocolombari/Gagabiro/components/eletrolitico/panassonic/CAPPRD1250W100D2500H5000.stp

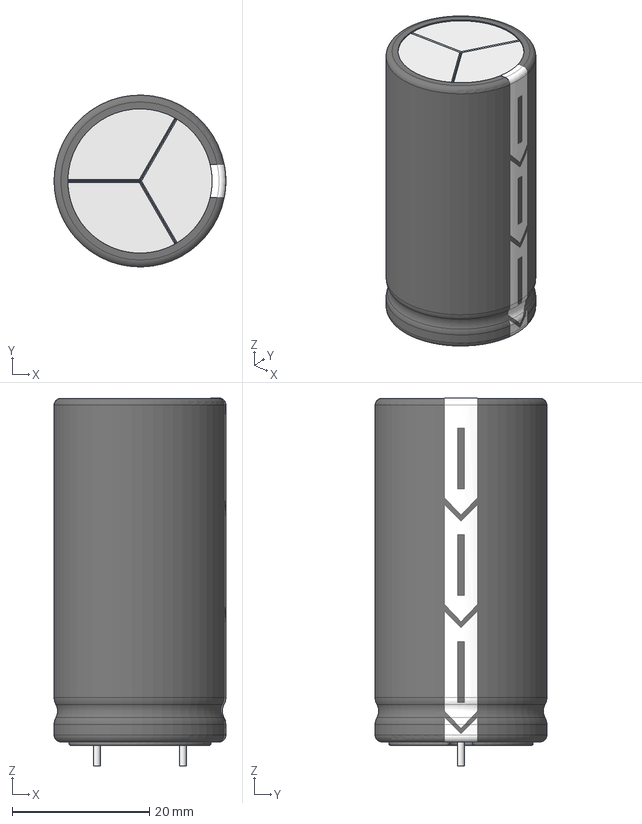
[picture p101: CAD file, 2025-02-04]
components/eletrolitico/panassonic/CAPPRD1250W100D2500H5000.stp
25.0 x 25.0 x 53.5 mm
