joaocolombari/Gagabiro/components/heatsink/ick_pga_25x25.SLDPRT

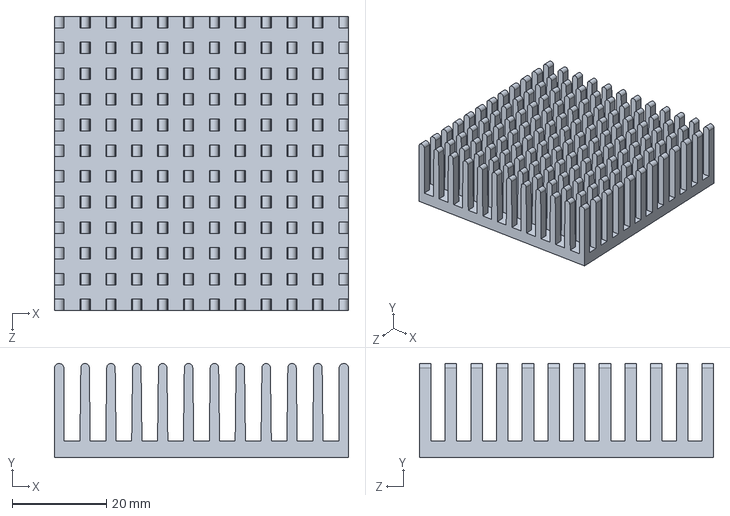
[picture p102: CAD file, 2025-02-04]
components/heatsink/ick_pga_25x25.SLDPRT
62.5 x 20.0 x 62.5 mm
