joaocolombari/Gagabiro/components/12ax7/valvula 12ax7/terminais-filamentos.SLDPRT

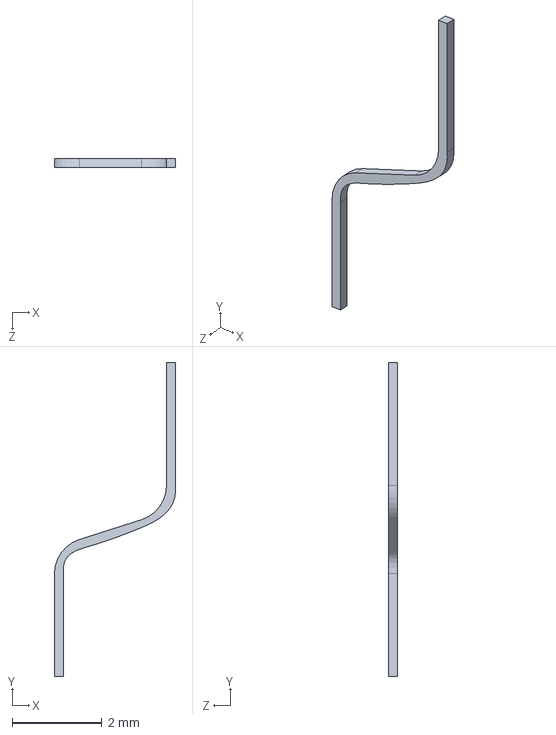
[picture p103: CAD file, 2025-02-04]
components/12ax7/valvula 12ax7/terminais-filamentos.SLDPRT
2.70 x 7.00 x 0.2 mm
