joaocolombari/Gagabiro/components/capacitor/stp/ECW-FD2J-823-KB.stp

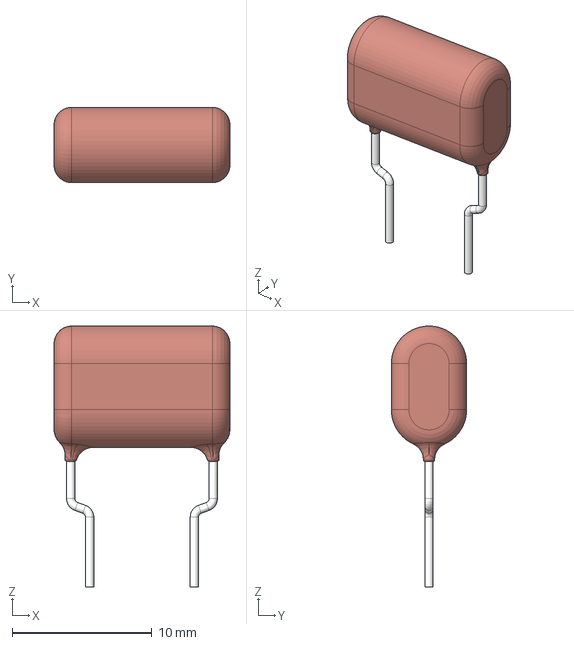
[picture p104: CAD file, 2025-02-04]
components/capacitor/stp/ECW-FD2J-823-KB.stp
12.6 x 5.40 x 18.7 mm
