joaocolombari/Gagabiro/components/eletrolitico/panassonic/CAPPRD750W80D1800H3550.stp

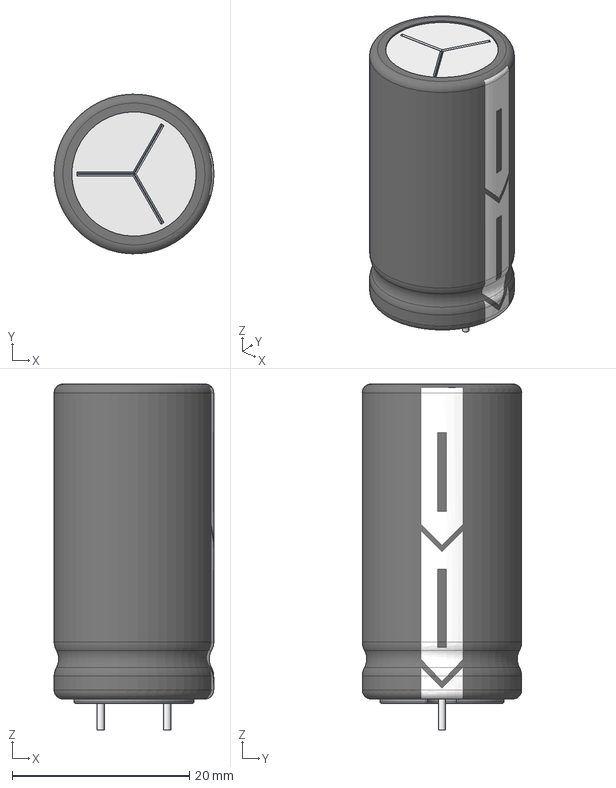
[picture p105: CAD file, 2025-02-04]
components/eletrolitico/panassonic/CAPPRD750W80D1800H3550.stp
18.0 x 18.0 x 39.0 mm
