joaocolombari/Gagabiro/components/heatsink/ick_led_r_40x10.SLDPRT

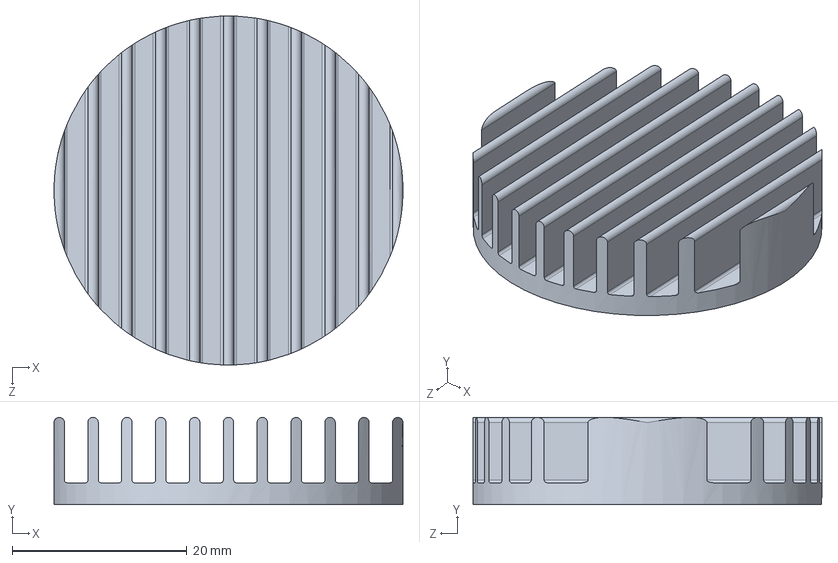
[picture p106: CAD file, 2025-02-04]
components/heatsink/ick_led_r_40x10.SLDPRT
40.0 x 10.0 x 40.0 mm
