joaocolombari/Gagabiro/components/12ax7/valvula 12ax7/caulda da base.SLDPRT

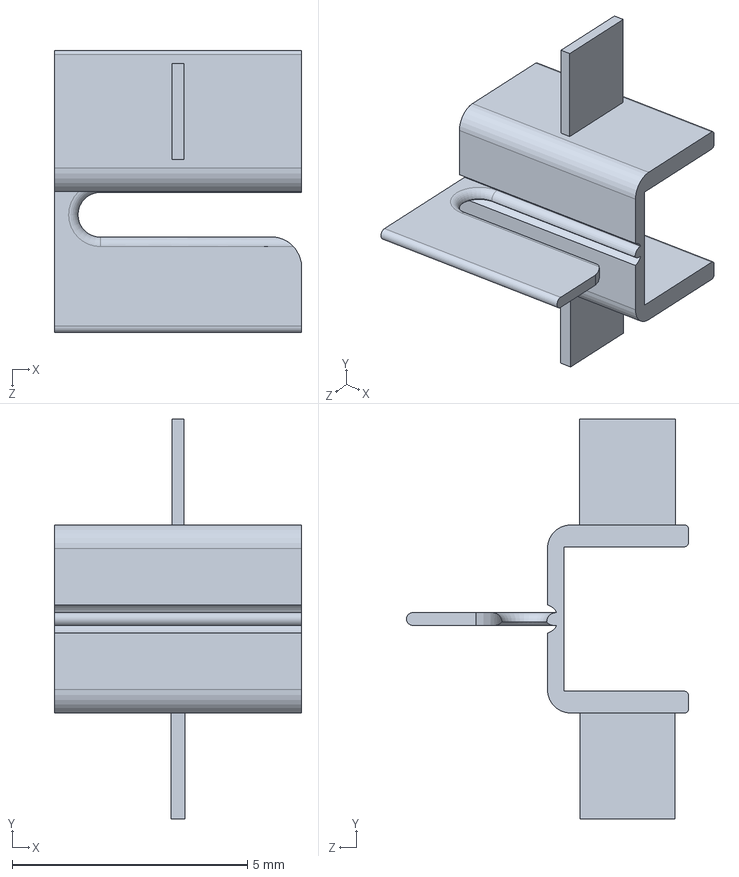
[picture p107: CAD file, 2025-02-04]
components/12ax7/valvula 12ax7/caulda da base.SLDPRT
5.25 x 8.50 x 5.99 mm
