joaocolombari/Gagabiro/components/capacitor/stp/ECW-FD2J-154-KB.stp

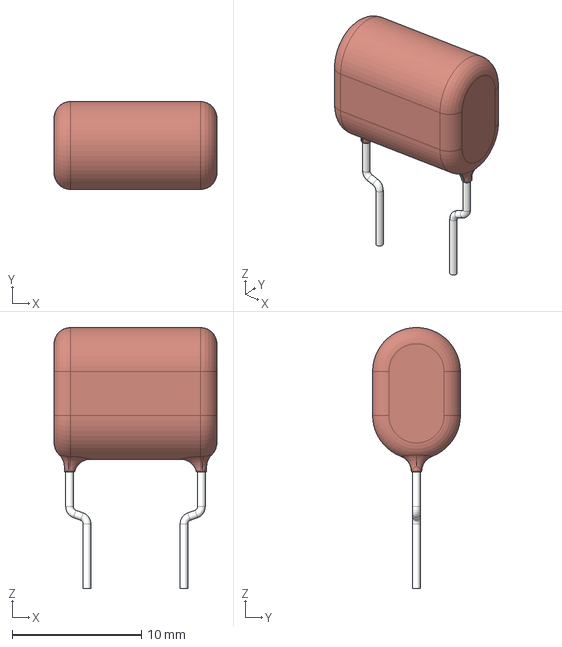
[picture p108: CAD file, 2025-02-04]
components/capacitor/stp/ECW-FD2J-154-KB.stp
12.6 x 6.80 x 20.2 mm
