joaocolombari/Gagabiro/components/eletrolitico/panassonic/CAPPRD500W60D1000H1250.stp

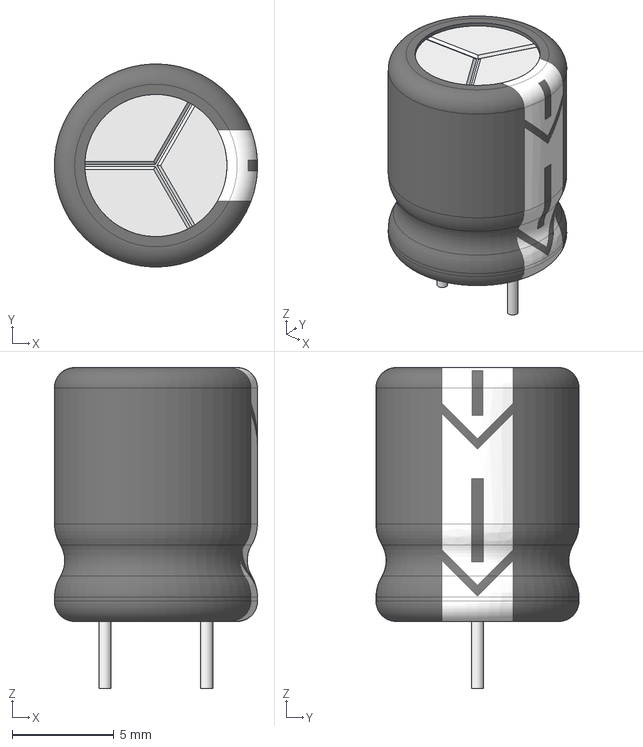
[picture p109: CAD file, 2025-02-04]
components/eletrolitico/panassonic/CAPPRD500W60D1000H1250.stp
10.00 x 10.00 x 15.8 mm
