joaocolombari/Gagabiro/components/heatsink/ick_led_r_50x10g.SLDPRT

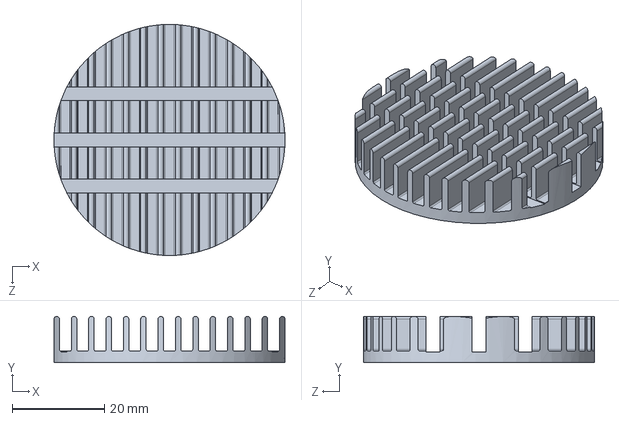
[picture p110: CAD file, 2025-02-04]
components/heatsink/ick_led_r_50x10g.SLDPRT
50.0 x 10.0 x 50.0 mm
