joaocolombari/Gagabiro/components/12ax7/valvula 12ax7/anodos.SLDPRT

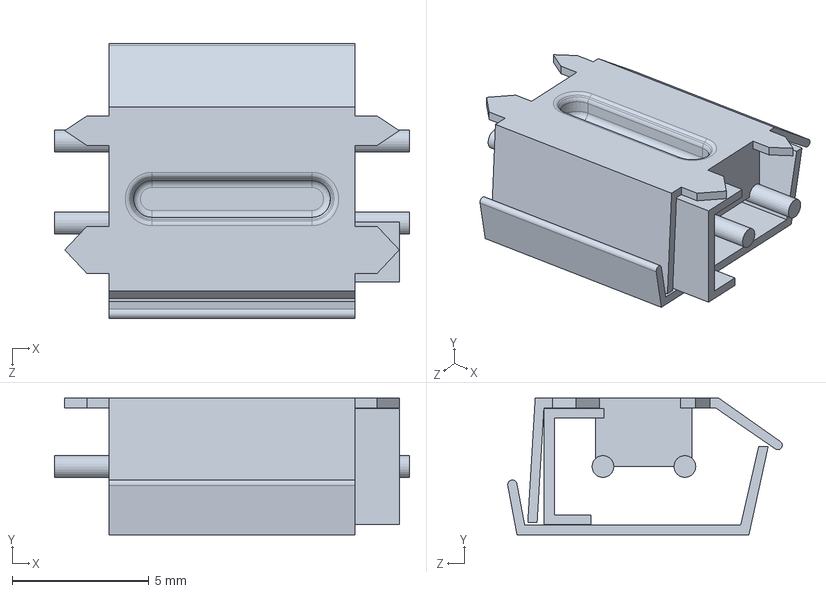
[picture p111: CAD file, 2025-02-04]
components/12ax7/valvula 12ax7/anodos.SLDPRT
13.0 x 5.00 x 10.1 mm
