joaocolombari/Gagabiro/components/capacitor/stp/ECW-FD2J-104-KB.stp

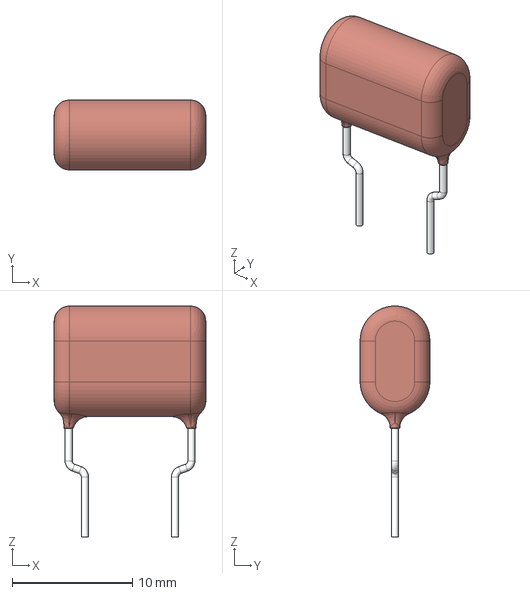
[picture p112: CAD file, 2025-02-04]
components/capacitor/stp/ECW-FD2J-104-KB.stp
12.6 x 5.80 x 19.2 mm
