joaocolombari/Gagabiro/(list of files, cad)

Other CAD files:
components/eletrolitico/CAPACITOR BLACK-WHITE/0.47uF/0.47uF 100V electr 5 x11mm -P.diameter 2.5 mm-Black-White.stp
components/eletrolitico/CAPACITOR BLACK-WHITE/10uF/10uF 50V electr 5 x11mm -P.diameter 2.5 mm-Black-White.stp
components/eletrolitico/CAPACITOR BLACK-WHITE/1uF/1uF 100V electr 5 x11mm -P.diameter 2.5 mm-Black-White.stp
components/eletrolitico/CAPACITOR BLACK-WHITE/2.2uF/2.2uF 100V electr 5 x11mm -P.diameter 2.5 mm-Black-White.stp
components/eletrolitico/CAPACITOR BLACK-WHITE/22uF/22uF 25V electr 5 x11mm -P.diameter 2.5mm-Black-White.stp
components/eletrolitico/CAPACITOR BLACK-WHITE/3.3uF/3.3uF 50V electr 5 x11mm -P.diameter 2.5 mm-Black-White.stp
components/eletrolitico/CAPACITOR BLACK-WHITE/33uF/33uF 63V electr 8 x12mm -P.diameter 4mm-Black-White.stp
components/eletrolitico/CAPACITOR BLACK-WHITE/4.7uF/4.7uF 100V electr 5 x11mm -P.diameter 2.5 mm-Black-White.stp
components/eletrolitico/CAPACITOR BLACK-WHITE/4700uF/4700uF 50V Electr 22 x42 -P.diameter 11mm-Black-White.stp
components/eletrolitico/CAPACITOR BLACK-WHITE/470uF/470uF 25V electr 8 x16mm -P.diameter 4mm-Black-White.stp
Gagabiro/Gagabiro.DWG
components/eletrolitico/CAPACITOR BLACK-WHITE/0.47uF/0.47uF 50V electr 5 x11mm -P.diameter 2.5 mm-Black-White.stp
components/eletrolitico/CAPACITOR BLACK-WHITE/100uF/100uF 35V electr 8 x12mm -P.diameter 4mm-Black-White.stp
components/eletrolitico/CAPACITOR BLACK-WHITE/10uF/10uF 63V electr 6.3 x11mm -P.diameter 3.2mm-Black-White.stp
components/eletrolitico/CAPACITOR BLACK-WHITE/1uF/1uF 63V electr 5 x11mm -P.diameter 2.5 mm-Black-White.stp
components/eletrolitico/CAPACITOR BLACK-WHITE/2.2uF/2.2uF 63V electr 5 x11mm -P.diameter 2.5 mm-Black-White.stp
components/eletrolitico/CAPACITOR BLACK-WHITE/22uF/22uF 50V electr 6.3 x11mm -P.diameter 3.2mm-Black-White.stp
components/eletrolitico/CAPACITOR BLACK-WHITE/3.3uF/3.3uF 100V electr 5 x11mm -P.diameter 2.5 mm-Black-White.stp
components/eletrolitico/CAPACITOR BLACK-WHITE/33uF/33uF 25V electr 5 x11mm -P.diameter 2.5mm-Black-White.stp
components/eletrolitico/CAPACITOR BLACK-WHITE/4.7uF/4.7uF 63V electr 5 x11mm -P.diameter 2.5 mm-Black-White.stp
components/eletrolitico/CAPACITOR BLACK-WHITE/470uF/470uF 16V electr 8 x14mm P.diameter 4mm-Black-White.stp
components/eletrolitico/CAPACITOR BLACK-WHITE/47uF/47uF 35V electr 6.3 x11mm -P.diameter 3.2mm-Black-White.stp
Gagabiro/Gagabiro_toplayer.DWG
components/eletrolitico/CAPACITOR BLACK-WHITE/100uF/100uF 16V electr 6.3 x11mm -P.diameter 3.2mm-Black-White.stp
components/eletrolitico/CAPACITOR BLACK-WHITE/10uF/10uF 63V electr 5 x11mm -P.diameter 2.5 mm-Black-White.stp
components/eletrolitico/CAPACITOR BLACK-WHITE/1uF/1uF 50V electr 5 x11mm -P.diameter 2.5 mm-Black-White.stp
components/eletrolitico/CAPACITOR BLACK-WHITE/2.2uF/2.2uF 50V electr 5 x11mm -P.diameter 2.5 mm-Black-White.stp
components/eletrolitico/CAPACITOR BLACK-WHITE/22uF/22uF 35V electr 5 x11mm -P.diameter 2.5mm-Black-White.stp
components/eletrolitico/CAPACITOR BLACK-WHITE/3300uF/3300uF 16V electr 13 x26mm -P.diameter 6.5mm-Black-White.stp
components/eletrolitico/CAPACITOR BLACK-WHITE/33uF/33uF 50V electr 6.3 x11mm -P.diameter 3.2mm-Black-White.stp
components/eletrolitico/CAPACITOR BLACK-WHITE/4.7uF/4.7uF 50V electr 5 x11mm -P.diameter 2.5 mm-Black-White.stp
components/eletrolitico/CAPACITOR BLACK-WHITE/470uF/470uF 63V electr 13 x20mm -P.diameter 6.5mm-Black-White.stp
components/eletrolitico/CAPACITOR BLACK-WHITE/47uF/47uF 63V electr 8 x12mm -P.diameter 4mm-Black-White.stp
Gagabiro/Gagabiro_bottomlayer.DWG
components/eletrolitico/CAPACITOR BLACK-WHITE/1000uF/1000uF 16V electr 10 x16mm -P.diameter 5mm-Black-White.stp
components/eletrolitico/CAPACITOR BLACK-WHITE/100uF/100uF 25V electr 6.3 x11mm -P.diameter 3.2mm-Black-White.stp
components/eletrolitico/CAPACITOR BLACK-WHITE/220uF/220uF 25V electr 8 x12mm -P.diameter 3mm-Black-White.stp
components/eletrolitico/CAPACITOR BLACK-WHITE/22uF/22uF 63V electr 6.3 x11mm -P.diameter 3.2mm-Black-White.stp
components/eletrolitico/CAPACITOR BLACK-WHITE/33uF/33uF 100V electr 8 x14mm P.diameter 4mm-Black-White.stp
components/eletrolitico/CAPACITOR BLACK-WHITE/470uF/470uF 16V electr 8 x12mm -P.diameter 3.5mm-Black-White.stp
components/eletrolitico/CAPACITOR BLACK-WHITE/47uF/47uF 16V electr 5 x11mm -P.diameter 2.5mm-Black-White.stp
Gagabiro/Plano 3 DWG.DWG
components/eletrolitico/CAPACITOR BLACK-WHITE/1000uF/1000uF 25V electr 10 x20mm -P.diameter 5mm-Black-White.stp
components/eletrolitico/CAPACITOR BLACK-WHITE/2200uF/2200uF 35V electr 16 x26mm -P.diameter 8mm-Black-White.stp
components/eletrolitico/CAPACITOR BLACK-WHITE/220uF/220uF 35V electr 8 x16mm -P.diameter 4mm-Black-White.stp
components/eletrolitico/CAPACITOR BLACK-WHITE/22uF/22uF 100V electr 8 x12mm -P.diameter 4mm-Black-White.stp
components/eletrolitico/CAPACITOR BLACK-WHITE/33uF/33uF 16V electr 5 x11mm -P.diameter 2.5mm-Black-White.stp
components/eletrolitico/CAPACITOR BLACK-WHITE/4700uF/4700uF 63V Electr 25 x50 -P.diameter 10mm-Black-White.stp
components/eletrolitico/CAPACITOR BLACK-WHITE/470uF/470uF 50V electr 13 x20mm -P.diameter 6.5mm-Black-White.stp
components/eletrolitico/CAPACITOR BLACK-WHITE/47uF/47uF 25V electr 6.3 x11mm -P.diameter 3.2mm-Black-White.stp
components/eletrolitico/CAPACITOR BLACK-WHITE/1000uF/1000uF 35V electr 13 x20mm -P.diameter 6.5mm-Black-White.stp
components/eletrolitico/CAPACITOR BLACK-WHITE/100uF/100uF 100V electr 13 x20mm -P.diameter 6.5mm-Black-White.stp
components/eletrolitico/CAPACITOR BLACK-WHITE/2200uF/2200uF 16V electr 13 x20mm -P.diameter 6.5mm-Black-White.stp
components/eletrolitico/CAPACITOR BLACK-WHITE/220uF/220uF 63V electr 10 x20mm -P.diameter 5mm-Black-White.stp
components/eletrolitico/CAPACITOR BLACK-WHITE/22uF/22uF 63V electr 6 x11mm -P.diameter 2.5mm-Black-White.stp
components/eletrolitico/CAPACITOR BLACK-WHITE/470uF/470uF 35V electr 10 x16mm -P.diameter 5mm-Black-White.stp
components/eletrolitico/CAPACITOR BLACK-WHITE/1000uF/1000uF 63V electr 16 x26mm -P.diameter 7.5mm-Black-White.stp
components/eletrolitico/CAPACITOR BLACK-WHITE/100uF/100uF 50V electr 8 x14mm P.diameter 4mm-Black-White.stp
components/eletrolitico/CAPACITOR BLACK-WHITE/220uF/220uF 100V electr 13 x26mm -P.diameter 6.5mm-Black-White.stp
components/eletrolitico/CAPACITOR BLACK-WHITE/470uF/470uF 100V electr 16 x33mm -P.diameter 8mm-Black-White.stp
components/eletrolitico/CAPACITOR BLACK-WHITE/47uF/47uF 100V electr 10 x16mm -P.diameter 5mm-Black-White.stp
components/eletrolitico/CAPACITOR BLACK-WHITE/1000uF/1000uF 50V electr 16 x26mm -P.diameter 8mm-Black-White.stp
components/eletrolitico/CAPACITOR BLACK-WHITE/4700uF/4700uF 16V electr 16 x26mm -P.diameter 8mm-Black-White.stp
components/12ax7/2/Base plastica.IGS
components/12ax7/2/blindagem.IGS
components/12ax7/2/montagem sem blindagem.IGS
components/12ax7/2/terminal.IGS
components/12ax7/valvula 12ax7/Peça2.SLDPRT
components/12ax7/valvula 12ax7/cintura baixa.SLDPRT
components/12ax7/valvula 12ax7/corpo-topo.SLDPRT
components/12ax7/valvula 12ax7/dissipador.SLDPRT
components/12ax7/valvula 12ax7/final.SLDASM
components/12ax7/valvula 12ax7/final.STEP
components/LM317MDT-TR/Allegro/std70n10f4.psm
components/LM317MDT-TR/DEHDL/lm317mdt_tr/chips/chips.prt
components/LM337KVURG3/Allegro/lm337kvurg3.psm
components/LM337KVURG3/DEHDL/lm337kvurg3/chips/chips.prt
components/capacitor/stp/ECW-FD2J-103-KB.stp
components/capacitor/stp/ECW-FD2J-105-Q4.stp
components/capacitor/stp/ECW-FD2J-123-KB.stp
components/capacitor/stp/ECW-FD2J-124-KB.stp
components/capacitor/stp/ECW-FD2J-153-KB.stp
components/capacitor/stp/ECW-FD2J-184-KB.stp
components/capacitor/stp/ECW-FD2J-224-KB.stp
components/capacitor/stp/ECW-FD2J-273-KB.stp
components/capacitor/stp/ECW-FD2J-274-KB.stp
components/capacitor/stp/ECW-FD2J-333-KB.stp
components/capacitor/stp/ECW-FD2J-394-KB.stp
components/capacitor/stp/ECW-FD2J-473-KB.stp
components/capacitor/stp/ECW-FD2J-564-KB.stp
components/capacitor/stp/ECW-FD2J-683-KB.stp
components/capacitor/stp/ECW-FD2J-684-KB.stp
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
