joaocolombari/Gagabiro/components/eletrolitico/CAPACITOR BLACK-WHITE/Ensamblaje2.png

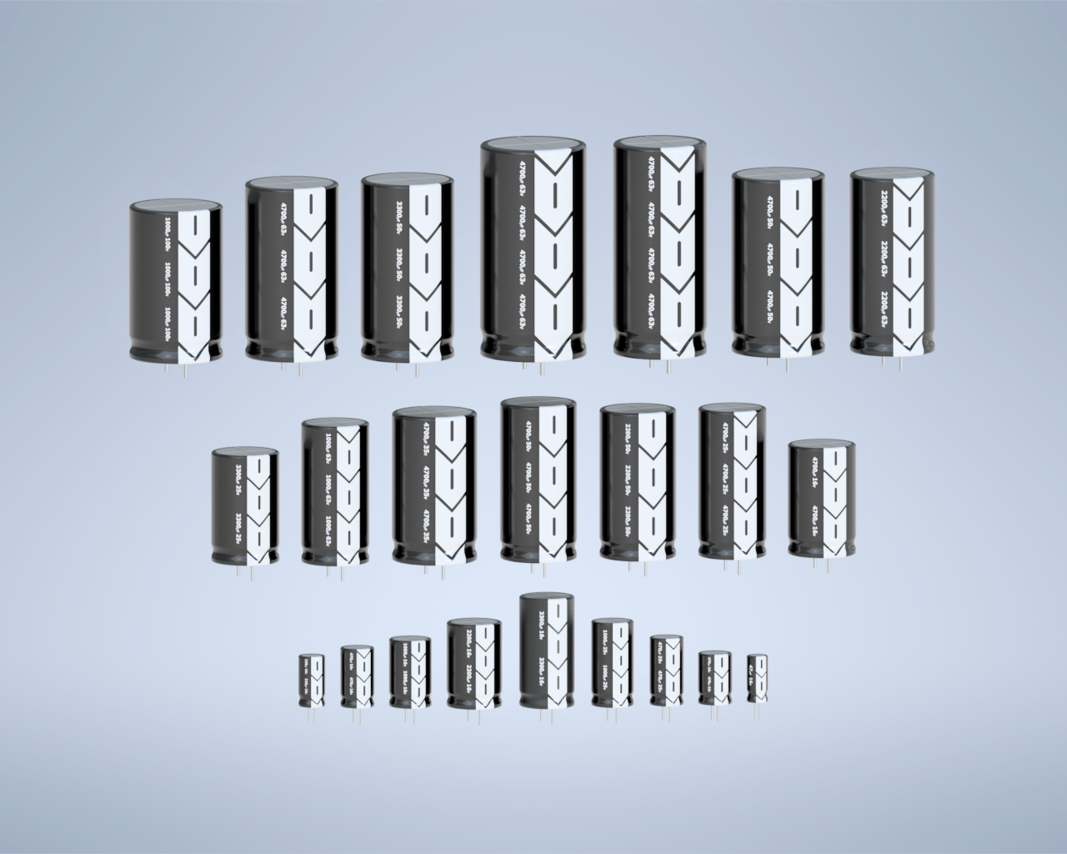
components/eletrolitico/CAPACITOR BLACK-WHITE/Ensamblaje2.png
