joaocolombari/Gagabiro/Gagabiro/Project Outputs for Gagabiro/Job1.PDF

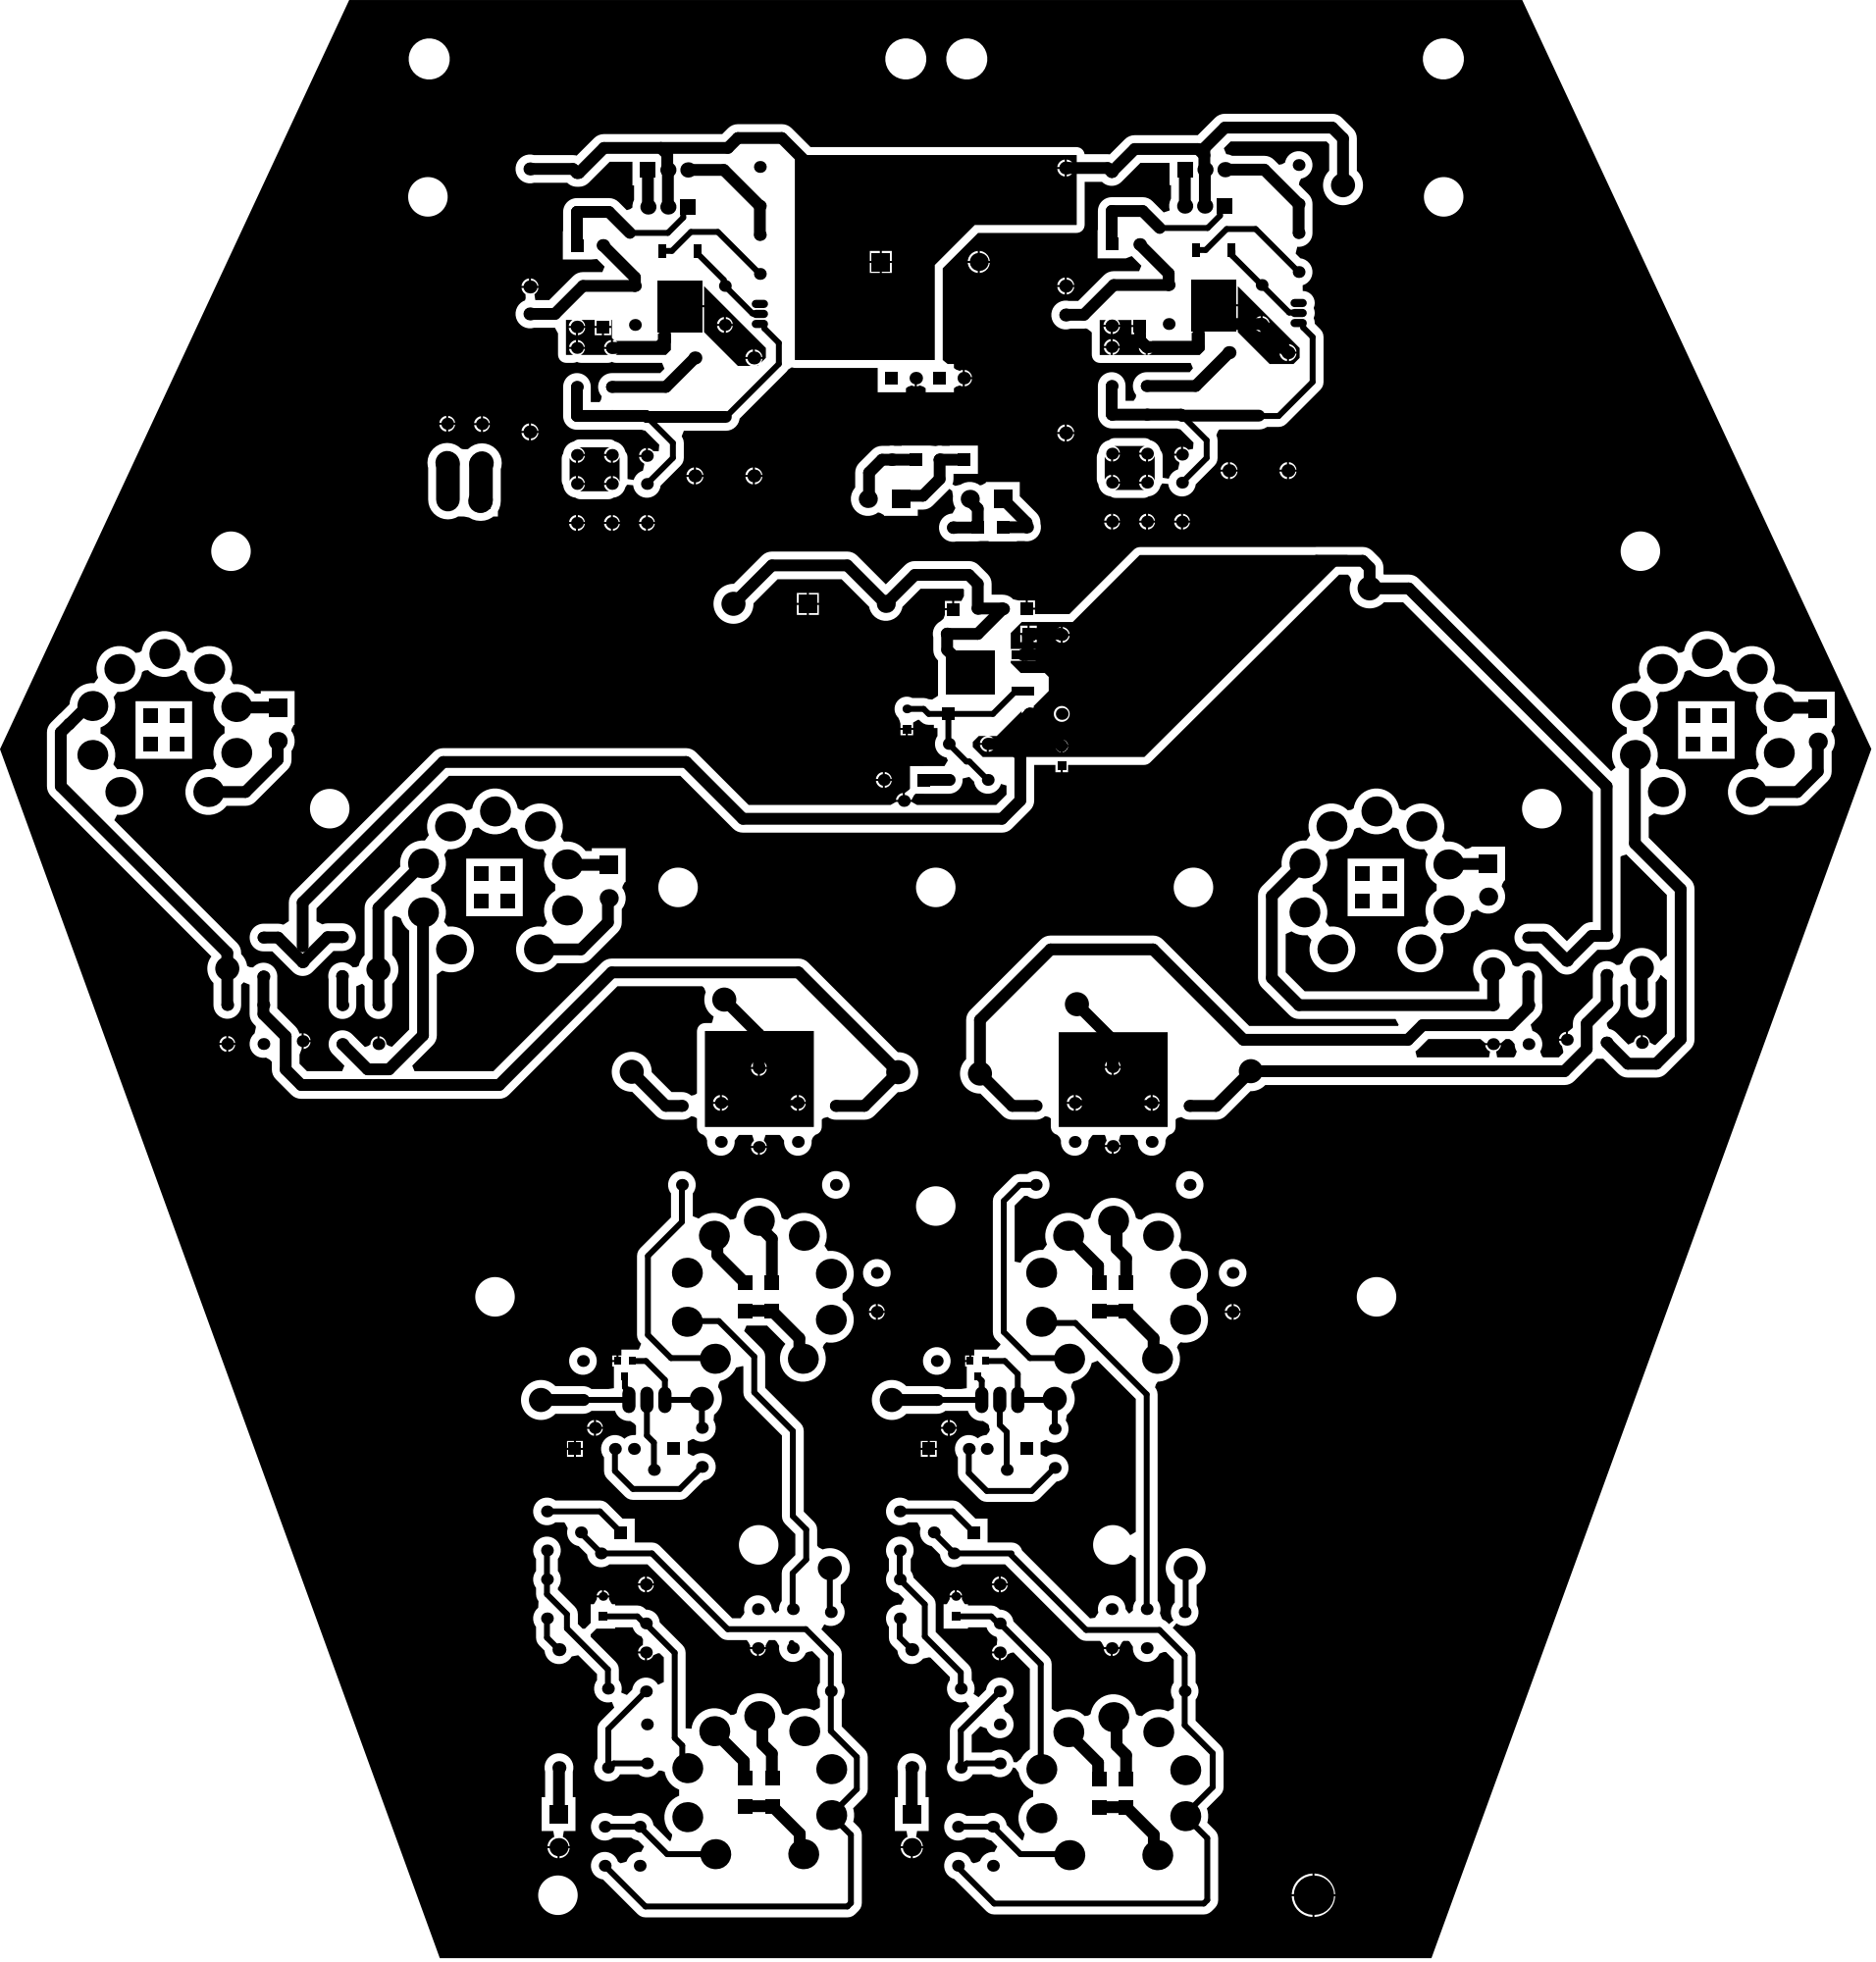
[picture p114: page 1]

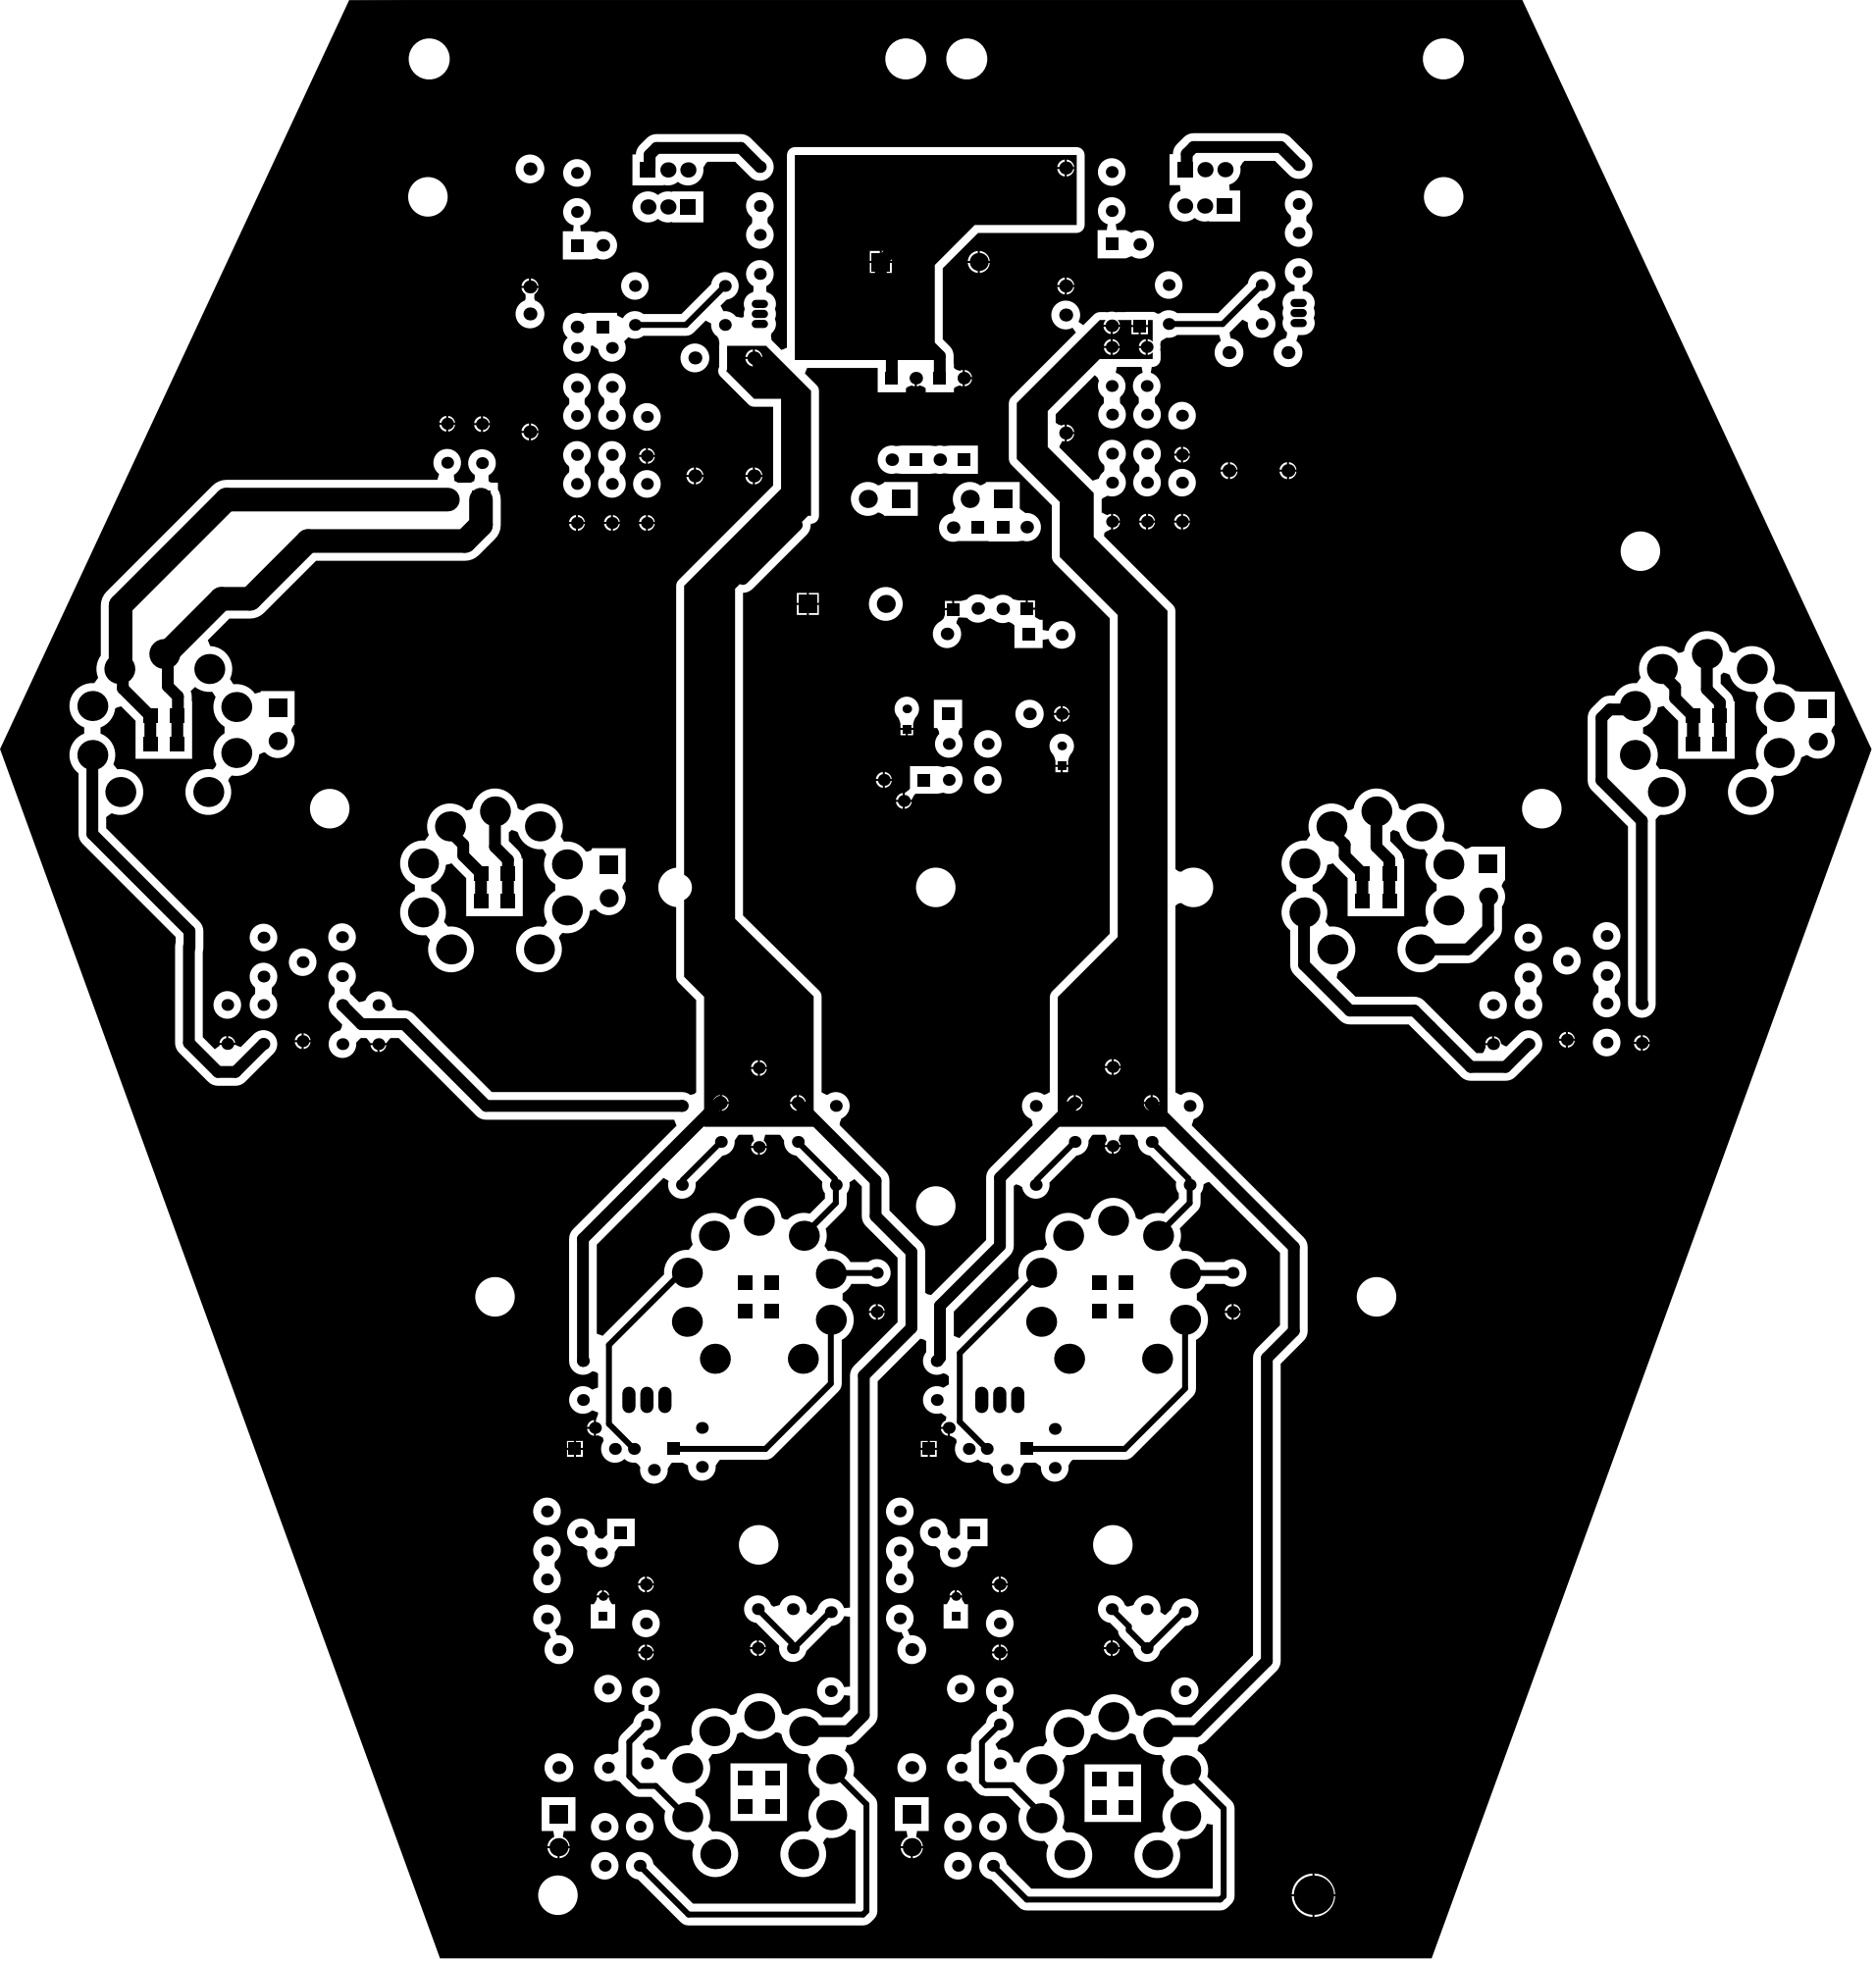
[picture p115: page 2]
