joaocolombari/Gagabiro/6L6GC/POWER_AMP_IC_rework.asc

C4: cap; 1µ
C5: cap; 1µ
C6: cap; 1µ
Q2: npn; BC847C
Q3: npn; BC847C
R10: r; 70
R11: r; 150k
R25: r; 220k
R26: r; 22k
R27: r; 22k
R28: r; 220k
R29: r; 220k
R30: r; 1k
R31: r; 1k
R32: r; 10k
R33: r; 10k
R35: r; 1k
R36: r; 470k
R37: r; 1k
R38: r; 820
R39: r; 820
Rload: r; 8
U1: PAT4002
U9: 12AU7
U10: 12AU7
U11: 12AU7
U12: 12AU7
U13: 6L6GB
U14: 6L6GB
V1: voltage; -37
V2: voltage; 420
V4: voltage; 300
V5: voltage; SINE(0 0.632 1k); AC 1
Named nets: 0, V_grid, V_pre, V_pow, V_in, out
.tran 0 2 1.99 10u
.OPTIONS numdgt=7
.OPTIONS plotwinsize=0
.four 1k 10 V(out)
.MODEL SFH4346 D	
+	IS=	4.37E-14
+	N=	1.806132146
+	RS=	2.129475292
+	IKF=	164.2918925
+	IBV =	2.00E-07
+	NBV =	105
+	IBVL =	1.00E-06
+	NBVL =	20
+	BV =	28
+	CJO =	1.67E-11
+	TT =	8.00E-09
+	EG =	1.3
.ac dec 100 0.01 10meg
.meas AC f20hz find v(out) at=20
.meas AC f30hz find v(out) at=20
.meas AC f40hz find v(out) at=20
.meas AC f50hz find v(out) at=50.05
.meas AC f70hz find v(out) at=70
.meas AC f100hz find v(out) at=100
.meas AC f200hz find v(out) at=200
.meas AC f500hz find v(out) at=500
.meas AC f700hz find v(out) at=700
.meas AC f1000hz find v(out) at=1000
.meas AC f2000hz find v(out) at=2000
.meas AC f2122hz find v(out) at=2122
.meas AC f5000hz find v(out) at=5000
.meas AC f7000hz find v(out) at=7000
.meas AC f10000hz find v(out) at=10000
.meas AC f20000hz find v(out) at=20000
Commands
Power Supplies
MARGEM DE GANHO:
QUANTO POSSO AUMENTAR DE GANHO ATE QUE O SISTEMA FIQUE
INSTAVEL, I.E., QUAL A DISTANCIA ENTRE 180 GRAUS E O 
DESLOCAMENTO DE FASE NO GANHO UNITARIO
MARGEM DE FASE:
QUANTO POSSO AUMENTAR DE FASE ATE QUE O SISTEMA FIQUE 
ISNTAVEL, I.E., QUAL A DISTANCIA ENTRE 180 GRAUS E O 
DESLOCAMENTO DE FASE NO GANHO UNITARIO
Rule of thumbs:
PM maior que 45 graus
GM maior que 6dB
Power Amplifier
.meas tran output_power AVG I(RLoad)*v(out)
.step param input_voltage list 0.563 0.632 0.708
1.0557% de distorção harmônica a 22.0257W
Com uma sensibilidade de -7dBV
+/- 0.47dB de 20 a 20kHz
.step param input_voltage list 0.1 0.11 0.12 0.13 0.14 0.15 0.16 0.17 0.18 0.19 0.2
.param input_voltage 0.14
