joaocolombari/Gagabiro/misc/POWER_AMP_IC_current_sink.asc

D1: LED; SFH4346
D2: LED; SFH4346
D3: LED; SFH4346
D4: LED; SFH4346
Q1: npn; BC547C
Q2: npn; BC547C
Q3: npn; BC547C
Q4: npn; BC547C
Q5: npn; BC547C
R1: r; 35
R3: r; 150k
R4: r; 35
R5: r; 150k
R6: r; 15k
R7: r; 15k
R8: r; 150k
R9: r; 820
R10: r; 35
R11: r; 15k
U1: EL84
V1: voltage; -20
V2: voltage; 300
V3: voltage; SINE(0 1.1 1k); AC 1
V4: voltage; -37
V5: voltage; 420
Named nets: 0, V_grid, Vee, V_pre, V_pow, V_in
.tran 0 2 1.9 10u
.OPTIONS numdgt=7
.OPTIONS plotwinsize=0
.four 1k 10 V(out)
.MODEL SFH4346 D	
+	IS=	4.37E-14
+	N=	1.806132146
+	RS=	2.129475292
+	IKF=	164.2918925
+	IBV =	2.00E-07
+	NBV =	105
+	IBVL =	1.00E-06
+	NBVL =	20
+	BV =	28
+	CJO =	1.67E-11
+	TT =	8.00E-09
+	EG =	1.3
.MODEL MJE350 PNP(IS=6.01619f BF=157.387 NF=0.910131 VAF=23.273
+ IKF=0.0564808 ISE=4.48479p NE=1.58557 BR=0.1 NR=1.03823
+ VAR=4.14543 IKR=0.0999978 ISC=1.00199e-13 NC=1.98851 RB=0.1
+ IRB=0.202965 RBM=0.1 RE=0.0710678 RC=0.355339 XTB=1.03638
+ XTI=3.8424 EG=1.206 CJE=1e-11 VJE=0.75 MJE=0.33 TF=1e-09 XTF=1
+ VTF=10 ITF=0.01 CJC=1e-11 VJC=0.75 MJC=0.33 XCJC=0.9 FC=0.5
+ CJS=0 VJS=0.75 MJS=0.5 TR=1e-07 PTF=0 Vceo=300 Icrating=0.5A
+ mfg=OnSemi)
.ac dec 100 0.01 10meg
.meas AC f20hz find v(out) at=20
.meas AC f50hz find v(out) at=50.05
.meas AC f70hz find v(out) at=70
.meas AC f100hz find v(out) at=100
.meas AC f200hz find v(out) at=200
.meas AC f500hz find v(out) at=500
.meas AC f700hz find v(out) at=700
.meas AC f1000hz find v(out) at=1000
.meas AC f2000hz find v(out) at=2000
.meas AC f2122hz find v(out) at=2122
.meas AC f5000hz find v(out) at=5000
.meas AC f7000hz find v(out) at=7000
.meas AC f10000hz find v(out) at=10000
.meas AC f20000hz find v(out) at=20000
Commands
Power Supplies
DUT
.dc V2 0 400 0.1
