joaocolombari/Gagabiro/(list of files, drawings)

Other design files:
components/AltiumDesigner/LM337KTTRG3.PcbLib
components/AltiumDesigner/LM337KTTRG3.SchLib
components/eletrolitico/B43659A5217M057/Altium/B43659A5217M057.PcbLib
components/eletrolitico/B43659A5217M057/Altium/B43659A5217M057.SchLib
components/Imported 12AX7.lia/12AX7.PcbLib
components/Imported 12AX7.lia/12AX7.SchLib
components/Imported VALVE-NOVAL_G/components.PcbLib
components/Imported VALVE-NOVAL_G/VALVE-NOVAL_G.PrjPcb
components/Imported VALVE-NOVAL_P/components.PcbLib
components/Imported VALVE-NOVAL_P/VALVE-NOVAL_P.PrjPcb
components/Imported VALVE-OCTAL/components.PcbLib
components/Imported VALVE-OCTAL/VALVE-OCTAL.PrjPcb
components/Imported Valve/Valve.PrjPcb
components/Imported Valve/Valve.SchLib
components/LM337KVURG3/Altium/LM337KVURG3.PcbLib
components/LM337KVURG3/Altium/LM337KVURG3.SchLib
components/OY100KE/OY100KE.SchLib
components/OY100KE/RESAD4700W80L1900D700.PcbLib
components/Persephone.SchLib
components/TIP50/TIP50.SchLib
components/TIP50/TO254P1009X445X1985-3.PcbLib
Gagabiro.SchLib
Gagabiro/Gagabiro.PrjPcb
Gagabiro/Gagabiro_cover_letter.SchDoc
Gagabiro/Gagabiro_main.SchDoc
Gagabiro/Gagabiro_mechanical.SchDoc
Gagabiro/Gagabiro_power_supply.SchDoc
Gagabiro/Gagabiro_power_supply_maida.SchDoc
Gagabiro_supply/Gagabiro_supply.PcbDoc
Gagabiro_supply/Gagabiro_supply.PrjPcb
Gagabiro_supply/Gagabiro_supply_acdc_converter.SchDoc
Gagabiro_supply/Gagabiro_supply_cover.SchDoc
Gagabiro_supply/Gagabiro_supply_interface.SchDoc
Gagabiro_supply/Gagabiro_supply_maida.SchDoc
