joaocolombari/Gagabiro/(commit log)

2024-12-14 including altium files
    [Gagabiro.GBL, Gagabiro.GBO, Gagabiro.GBP, Gagabiro.GBS, Gagabiro.GTL, Gagabiro.GTO, Gagabiro.GTP, Gagabiro.GTS]
2025-02-04 power supply were are you
    [0.22uF 50V electr 5 x11mm -P.diameter 2.5 mm-Black-White.stp, 0.47uF 100V electr 5 x11mm -P.diameter 2.5 mm-Black-White.stp, 0.47uF 50V electr 5 x11mm -P.diameter 2.5 mm-Black-White.stp, 1000uF 100V electr 22 x36mm -P.diameter 11mm-Black-White.stp, 1000uF 16V electr 10 x16mm -P.diameter 5mm-Black-White.stp, 1000uF 25V electr 10 x20mm -P.diameter 5mm-Black-White.stp, 1000uF 25V electr 13 x20mm -P.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]
